ZINKTiti/30-bibliotheque-Modelisme/01 Electronique/Motors/01 NEMA/NEMA_17_with_connector.png

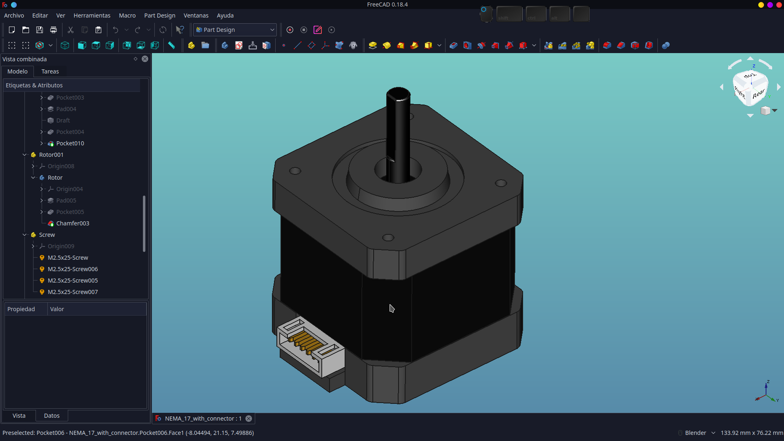
01 Electronique/Motors/01 NEMA/NEMA_17_with_connector.png
