ZINKTiti/30-bibliotheque-Modelisme/README.md

# 30-bibliotheque-Modelisme
 Library FreeCAD pour le modelisme

Cette library est un compilation d'un grand nombre de model utilisable dans me designe 3D pour le modelisme
