ZINKTiti/30-bibliotheque-Modelisme/00 Modelisme/Moteur/Bruchless/Turnigy/sk3-3542_dt3019-14p_motor_edited_.pdf

### I ""1 I I/"

I I

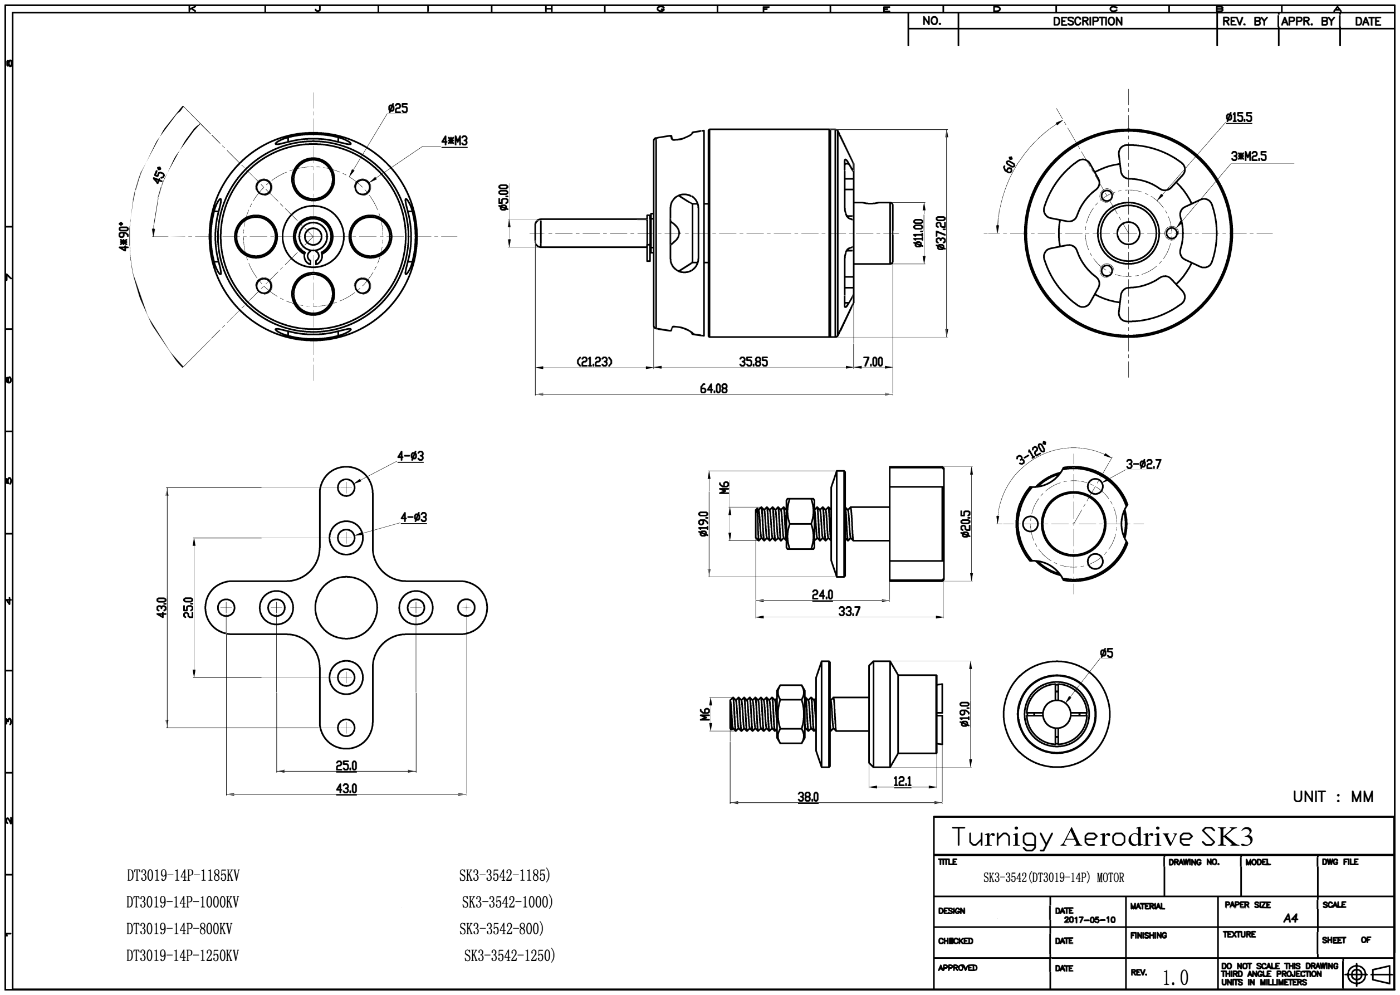
[picture p3: page 1]

11125

4•M3

II") s.
II ( C1' | L
Ill | -

I
, | +---------1 .,
/ | (21.23)

4-1113

4-1113

I • | 0

25.0

43.0

DT3019-14P-1185KV | SK3-3542-1185)
| SK3-3542-1000)
| SK3-3542-800)

## DT3019-14P-1000KV

## DT3019-14P-800KV

DT3019-14P-1250KV | SK3-3542-1250)

## _,__...,.-

/<::::::

__,......,___

35.85

64.08

I

24.0

38.0

,,_
j

33.7

7.00

.,..:;

12.1

NO. | DESCRIPTION | REV. BY IAPPR. BY I DATE

@
{;:;s.

II'!

@ s.

I

# I / _J_

11115,5

3•M2.5

UNIT : MM

# Turnigy Aerodrive SK3

1111£ | I DRAWING NO. | I MODEL | I DWO FILE
SK3-3542(DT3019-14P) MOTOR
DESIGN | I DA

17-o5-10 IIA'IERW. PAPER SIZE I SCALE A4
CHECKED | I DAlE | FINISHNG | 1EXIURE | I SHEEr | OF - | I DAlE | RE.V. | 1.0 | DO NOT SCALE lHIS DRAWING I
lHIRD ANGLE PROJECllON | -$ lNTS IN IIIWIIEIERS
