ZINKTiti/30-bibliotheque-Modelisme/00 Modelisme/Accessoires/Boitier connecteur/connecteur_JR_affleurant.png

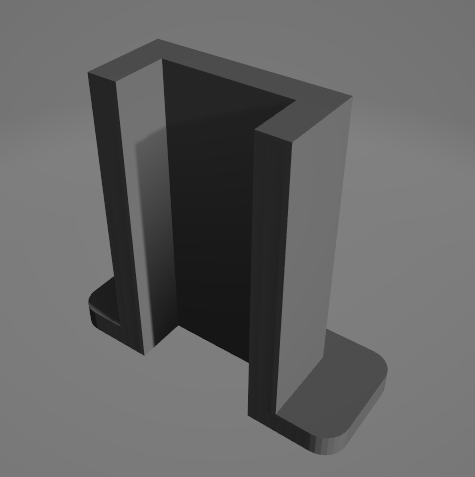
00 Modelisme/Accessoires/Boitier connecteur/connecteur_JR_affleurant.png
