ZINKTiti/30-bibliotheque-Modelisme/00 Modelisme/Accessoires/Connecteur/MPX/MPX.png

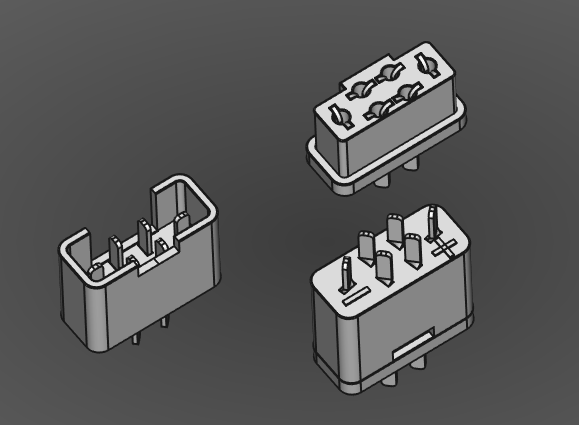
00 Modelisme/Accessoires/Connecteur/MPX/MPX.png
