ZINKTiti/30-bibliotheque-Modelisme/00 Modelisme/Moteur/Bruchless/Axi/2208dwg.jpg

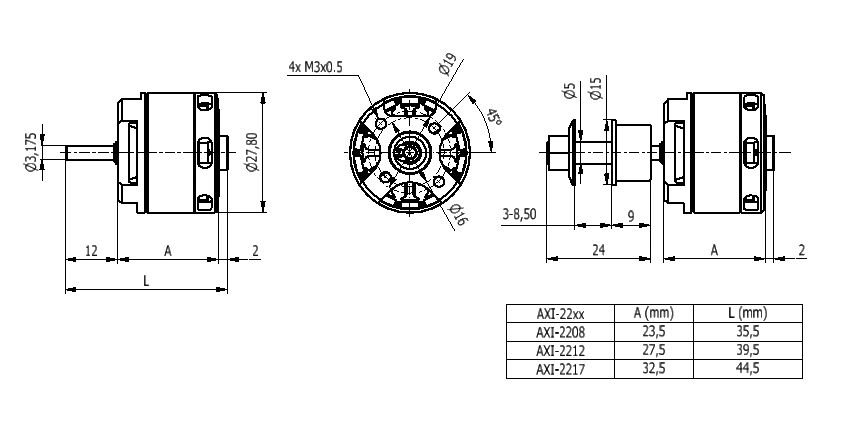
00 Modelisme/Moteur/Bruchless/Axi/2208dwg.jpg
