ZINKTiti/30-bibliotheque-Modelisme/00 Modelisme/Moteur/Bruchless/Axi/2212-3.jpg

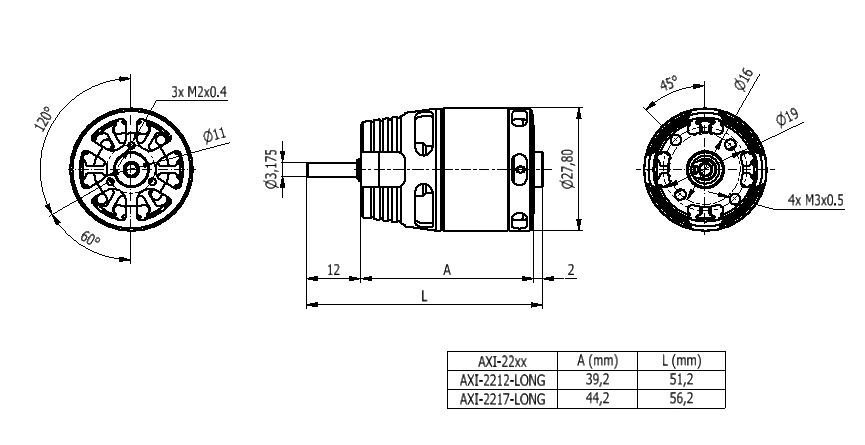
00 Modelisme/Moteur/Bruchless/Axi/2212-3.jpg
