ZINKTiti/30-bibliotheque-Modelisme/00 Modelisme/Moteur/Bruchless/Axi/axi-81xx.jpg

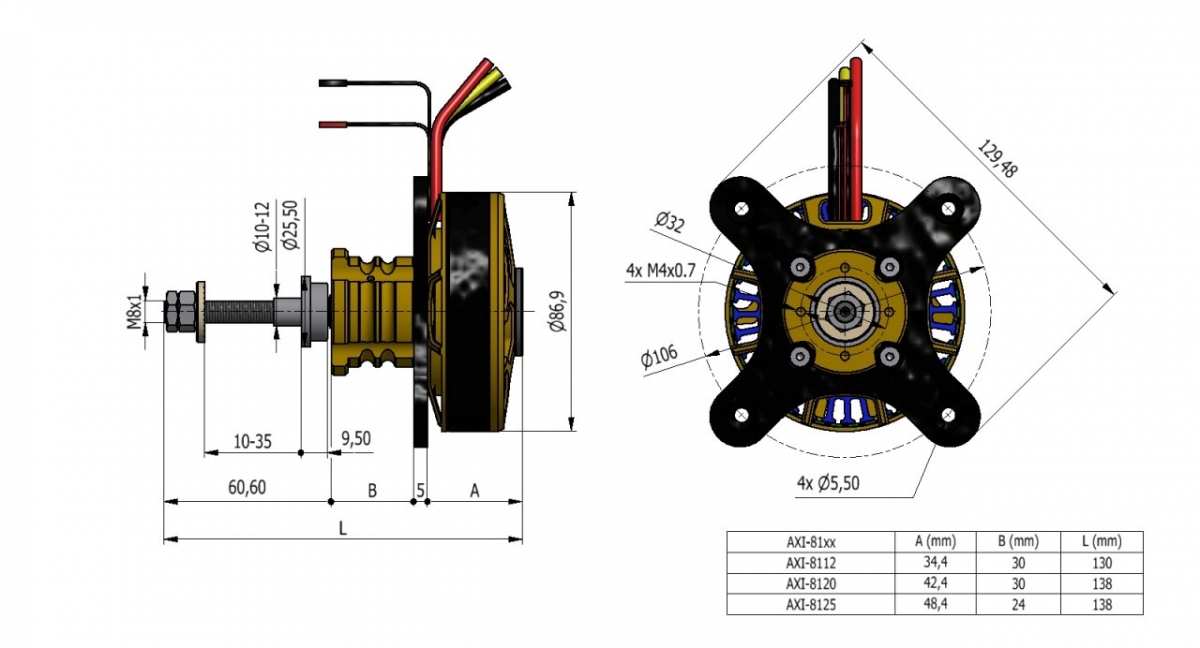
00 Modelisme/Moteur/Bruchless/Axi/axi-81xx.jpg
