ZINKTiti/30-bibliotheque-Modelisme/00 Modelisme/Moteur/Bruchless/Axi/axi-90-5320-370-3d3.jpg

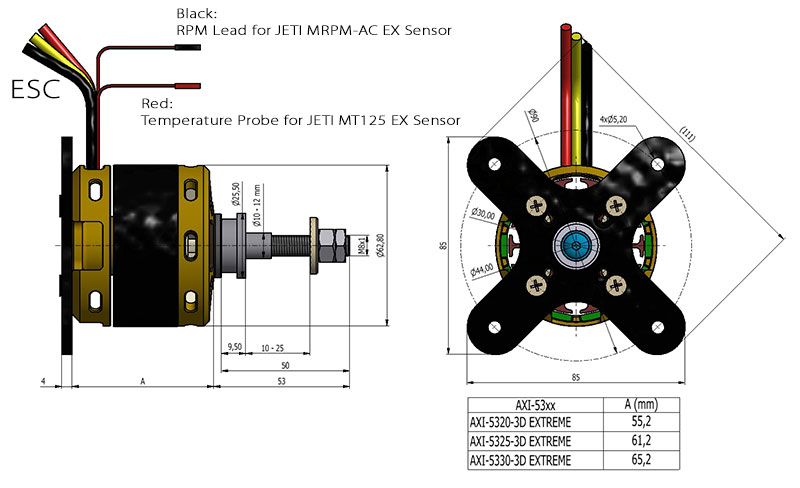
00 Modelisme/Moteur/Bruchless/Axi/axi-90-5320-370-3d3.jpg
