ZINKTiti/30-bibliotheque-Modelisme/00 Modelisme/Moteur/Bruchless/Axi/axi-5345l-hd3.jpg

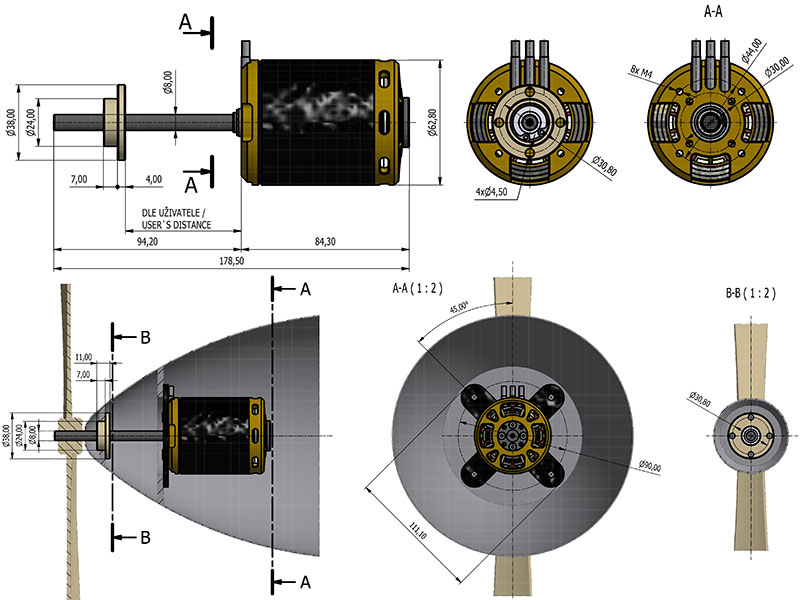
00 Modelisme/Moteur/Bruchless/Axi/axi-5345l-hd3.jpg
