ZINKTiti/30-bibliotheque-Modelisme/00 Modelisme/Moteur/Bruchless/Turnigy/p2_FULL.jpg

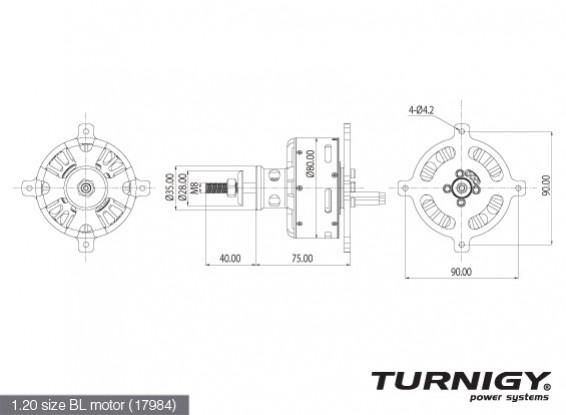
00 Modelisme/Moteur/Bruchless/Turnigy/p2_FULL.jpg
