ZINKTiti/30-bibliotheque-Modelisme/00 Modelisme/Moteur/Essence/DLE/DLE30_dim1.jpg

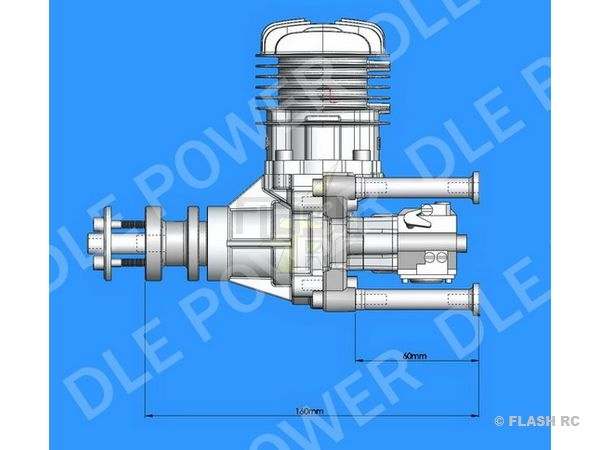
00 Modelisme/Moteur/Essence/DLE/DLE30_dim1.jpg
