ZINKTiti/30-bibliotheque-Modelisme/00 Modelisme/Moteur/Essence/DLE/dle60_dimensions_back.jpg

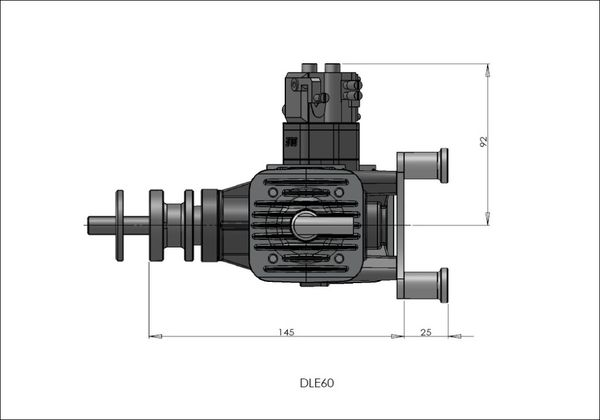
00 Modelisme/Moteur/Essence/DLE/dle60_dimensions_back.jpg
