ZINKTiti/30-bibliotheque-Modelisme/00 Modelisme/Moteur/Essence/DLE/dle_55_5.jpg

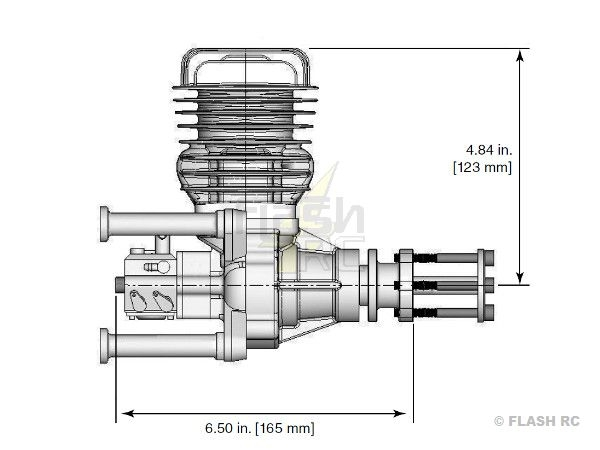
00 Modelisme/Moteur/Essence/DLE/dle_55_5.jpg
