ZINKTiti/30-bibliotheque-Modelisme/00 Modelisme/Servos/KST/03_cec1d161-892e-4872-81a3-9242b01087f4_600x600.webp

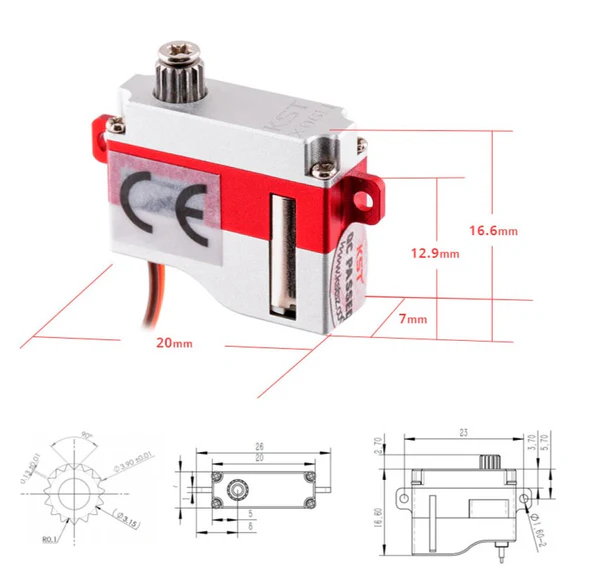
00 Modelisme/Servos/KST/03_cec1d161-892e-4872-81a3-9242b01087f4_600x600.webp
