ZINKTiti/30-bibliotheque-Modelisme/00 Modelisme/Servos/KST/kst-x12-5082.jpg

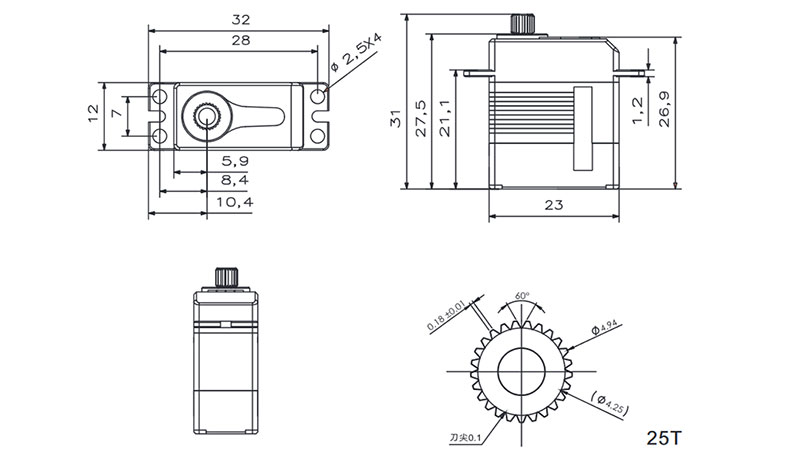
00 Modelisme/Servos/KST/kst-x12-5082.jpg
