ZINKTiti/30-bibliotheque-Modelisme/00 Modelisme/Servos/KST/kst-x20-38132.jpg

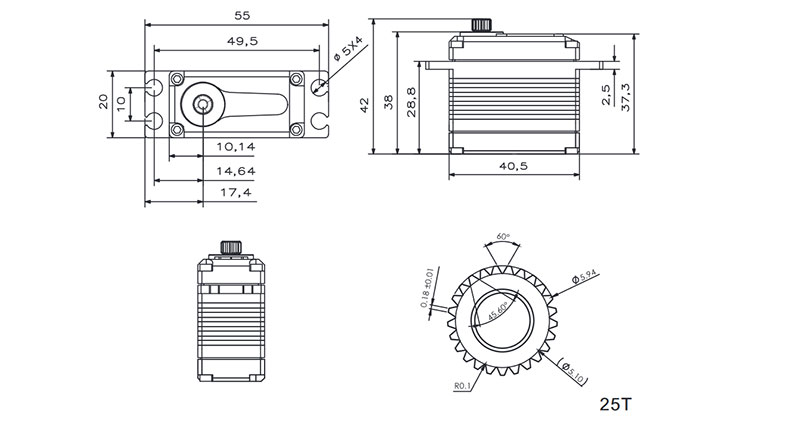
00 Modelisme/Servos/KST/kst-x20-38132.jpg
