ZINKTiti/30-bibliotheque-Modelisme/00 Modelisme/Servos/KST/nano-servo-kst-x12-508-v80-62kg-a-84v.jpg

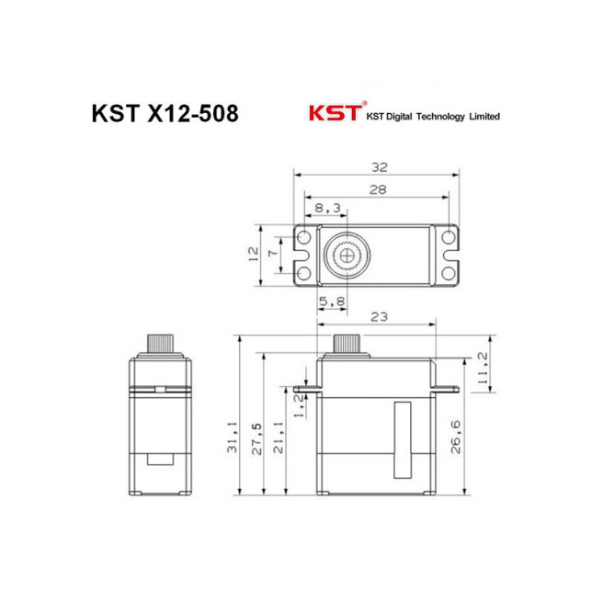
00 Modelisme/Servos/KST/nano-servo-kst-x12-508-v80-62kg-a-84v.jpg
