ZINKTiti/30-bibliotheque-Modelisme/00 Modelisme/Servos/KST/servo-brushless-hv-kst-bls505.jpg

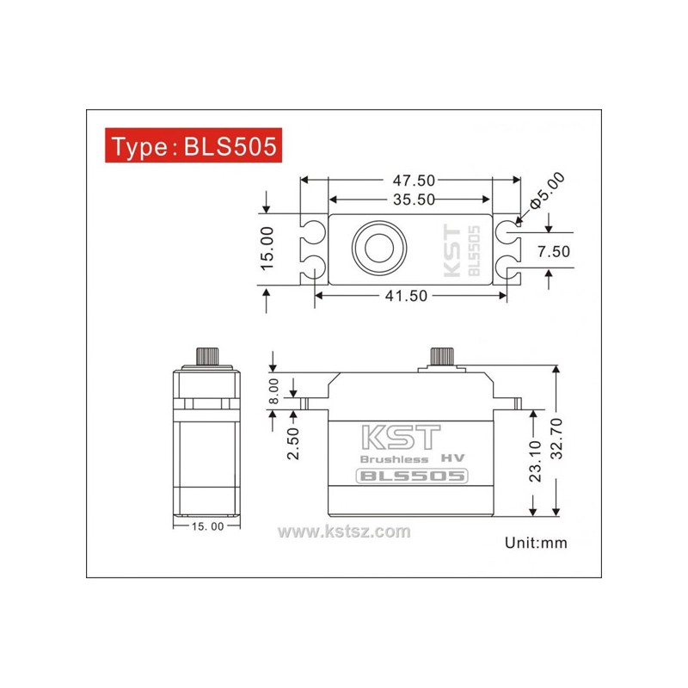
00 Modelisme/Servos/KST/servo-brushless-hv-kst-bls505.jpg
