ZINKTiti/30-bibliotheque-Modelisme/00 Modelisme/Servos/KST/servo-d-aile-kst-ds125mg-7kgcm-a-6v.jpg

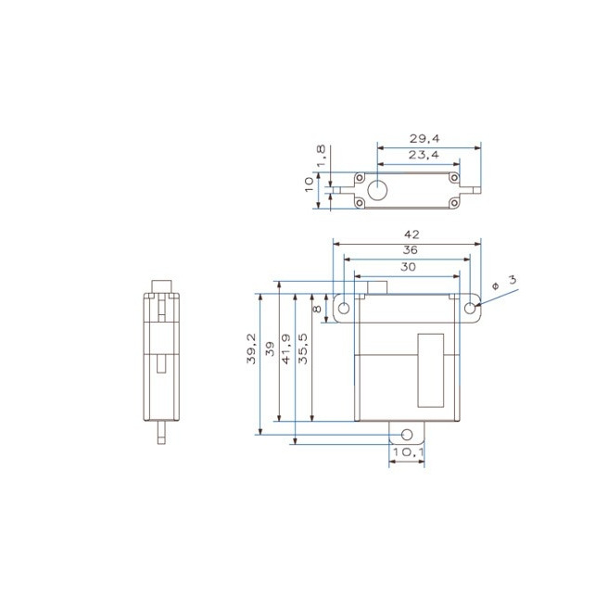
00 Modelisme/Servos/KST/servo-d-aile-kst-ds125mg-7kgcm-a-6v.jpg
