ZINKTiti/30-bibliotheque-Modelisme/00 Modelisme/Servos/KST/servo-x10-mini-v8-23gr-75kg-kst.jpg

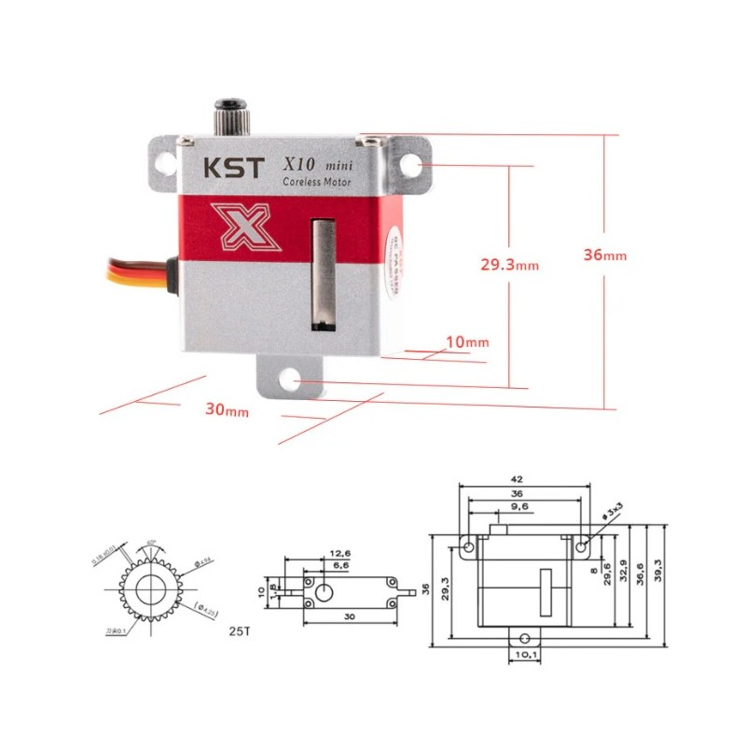
00 Modelisme/Servos/KST/servo-x10-mini-v8-23gr-75kg-kst.jpg
