ZINKTiti/30-bibliotheque-Modelisme/00 Modelisme/Servos/KST/X08 plus.jpg

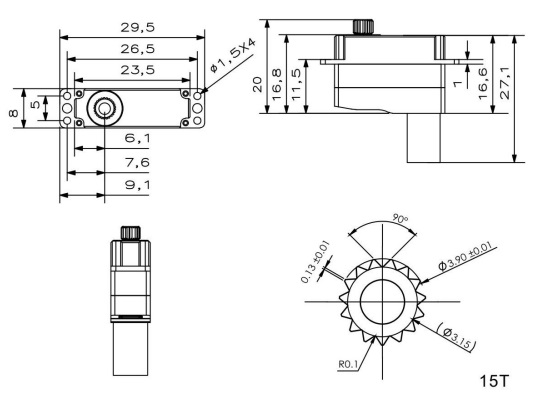
00 Modelisme/Servos/KST/X08 plus.jpg
