ZINKTiti/30-bibliotheque-Modelisme/01 Electronique/Fin de course/endstop.png

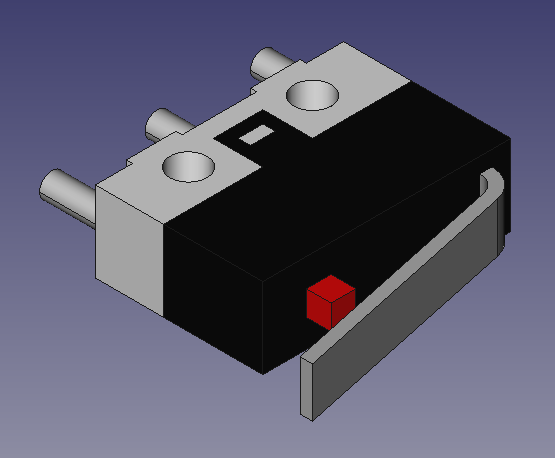
01 Electronique/Fin de course/endstop.png
