ZINKTiti/30-bibliotheque-Modelisme/01 Electronique/Fin de course/endstopsmall.png

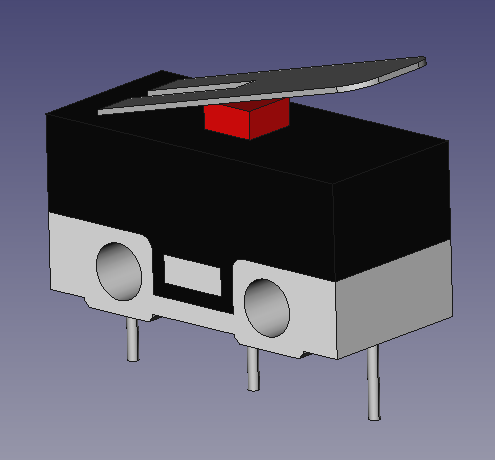
01 Electronique/Fin de course/endstopsmall.png
