ZINKTiti/30-bibliotheque-Modelisme/01 Electronique/Fin de course/Fin de course rouge/Bildschirmfoto 2016-11-22 um 21.24.29.JPG

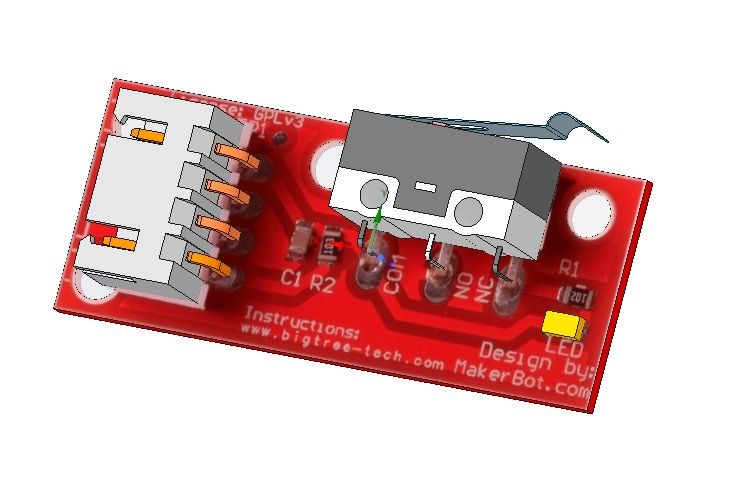
01 Electronique/Fin de course/Fin de course rouge/Bildschirmfoto 2016-11-22 um 21.24.29.JPG
