ZINKTiti/30-bibliotheque-Modelisme/01 Electronique/LCD/2-2-tft-lcd-screen/Assortment.JPG

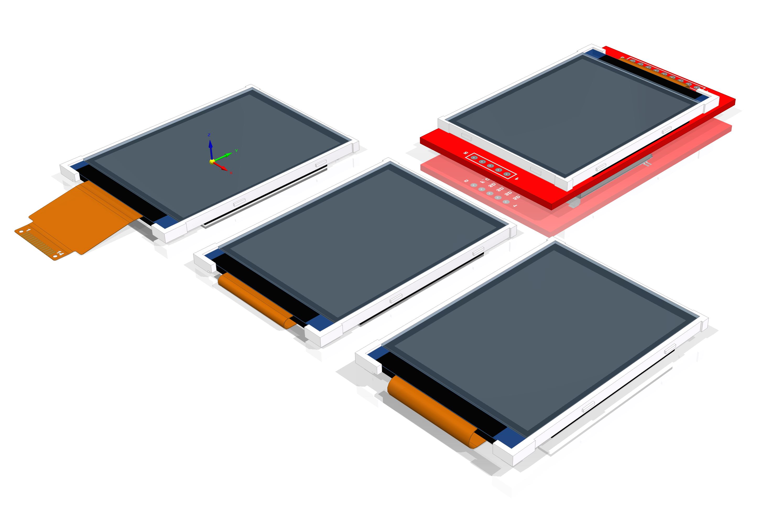
01 Electronique/LCD/2-2-tft-lcd-screen/Assortment.JPG
