ZINKTiti/30-bibliotheque-Modelisme/01 Electronique/LCD/tft-lcd-2-4-inch-ili9341-touch-320x240/2.jpg

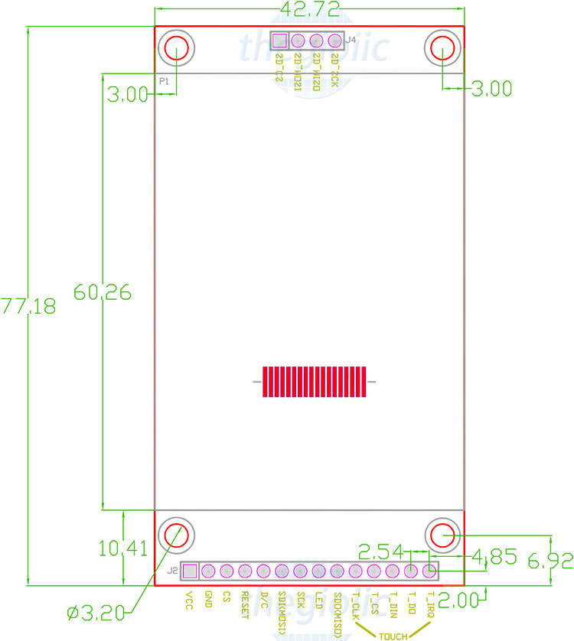
01 Electronique/LCD/tft-lcd-2-4-inch-ili9341-touch-320x240/2.jpg
