ZINKTiti/30-bibliotheque-Modelisme/01 Electronique/Statique Relay/FinalRender.jpg

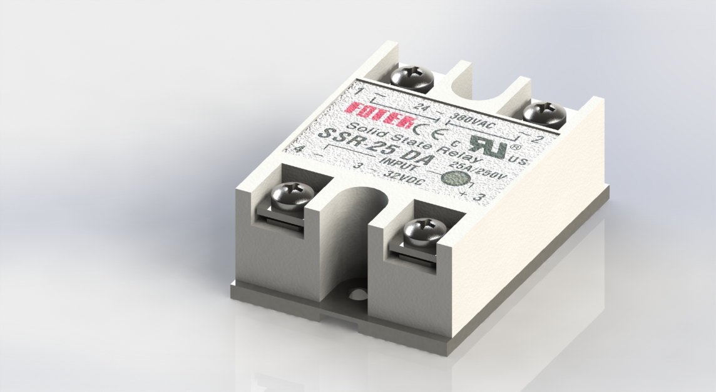
01 Electronique/Statique Relay/FinalRender.jpg
