ZINKTiti/30-bibliotheque-Modelisme/01 Electronique/Statique Relay/Fotek SSR Faceplate.jpg

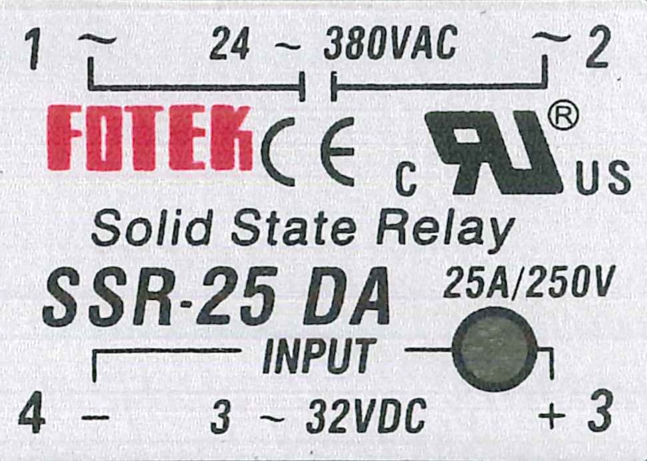
01 Electronique/Statique Relay/Fotek SSR Faceplate.jpg
