ZINKTiti/30-bibliotheque-Modelisme/02 Mecanique/Coupleur/CF/CF-03.jpg

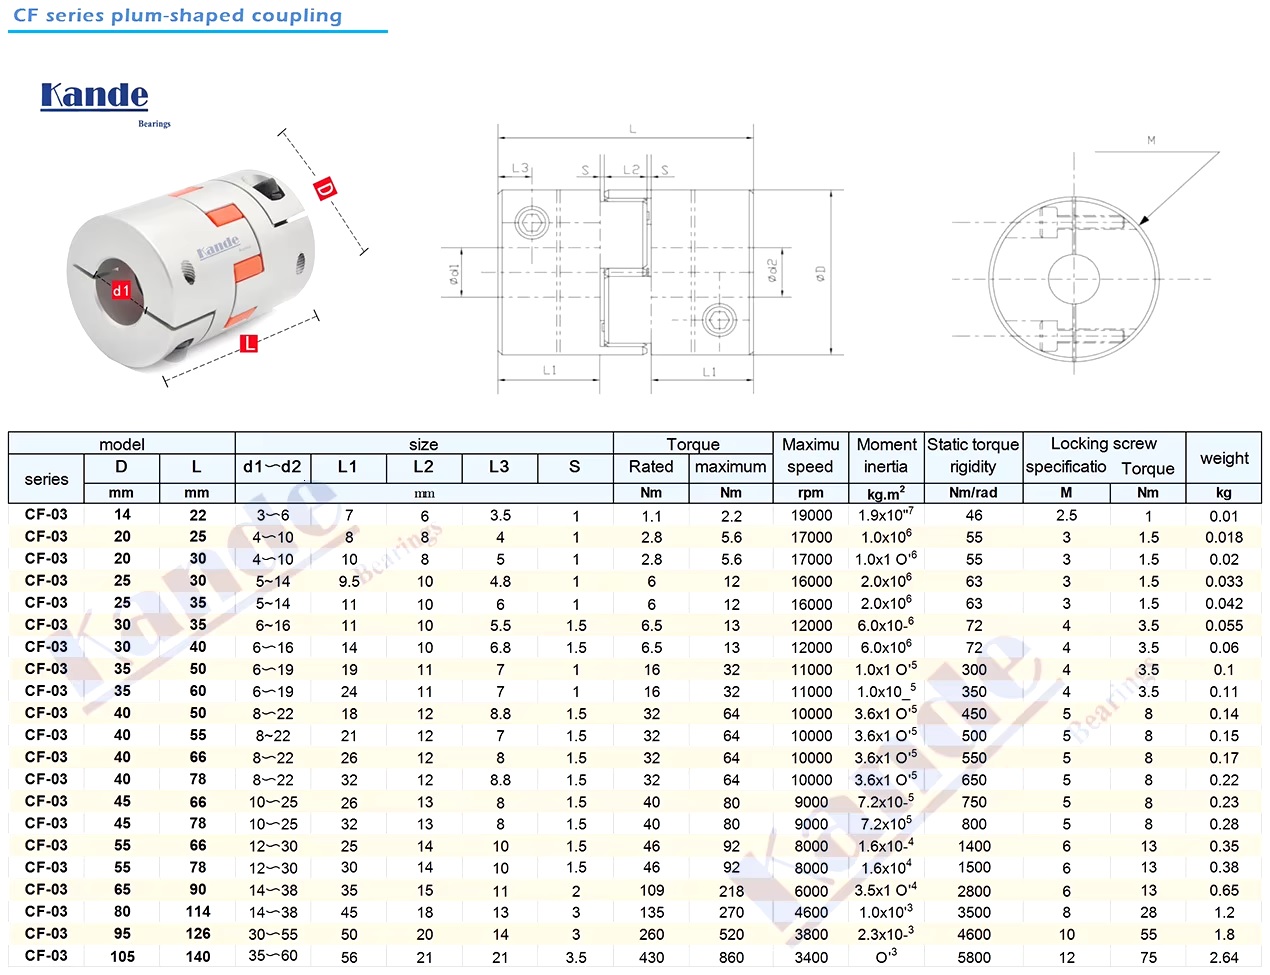
02 Mecanique/Coupleur/CF/CF-03.jpg
