ZINKTiti/30-bibliotheque-Modelisme/02 Mecanique/Guidage Lineaire/HGH/HGH 15 to 65 all Dim V2.jpg

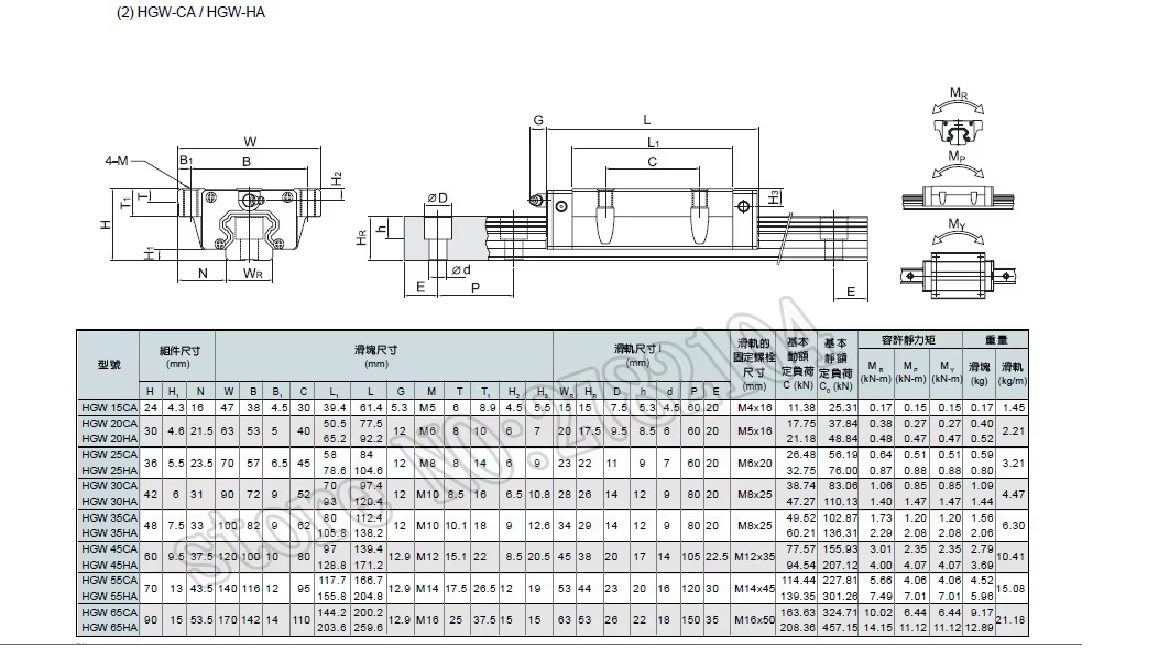
02 Mecanique/Guidage Lineaire/HGH/HGH 15 to 65 all Dim V2.jpg
