ZINKTiti/30-bibliotheque-Modelisme/02 Mecanique/Guidage Lineaire/HGH/HGH.jpg

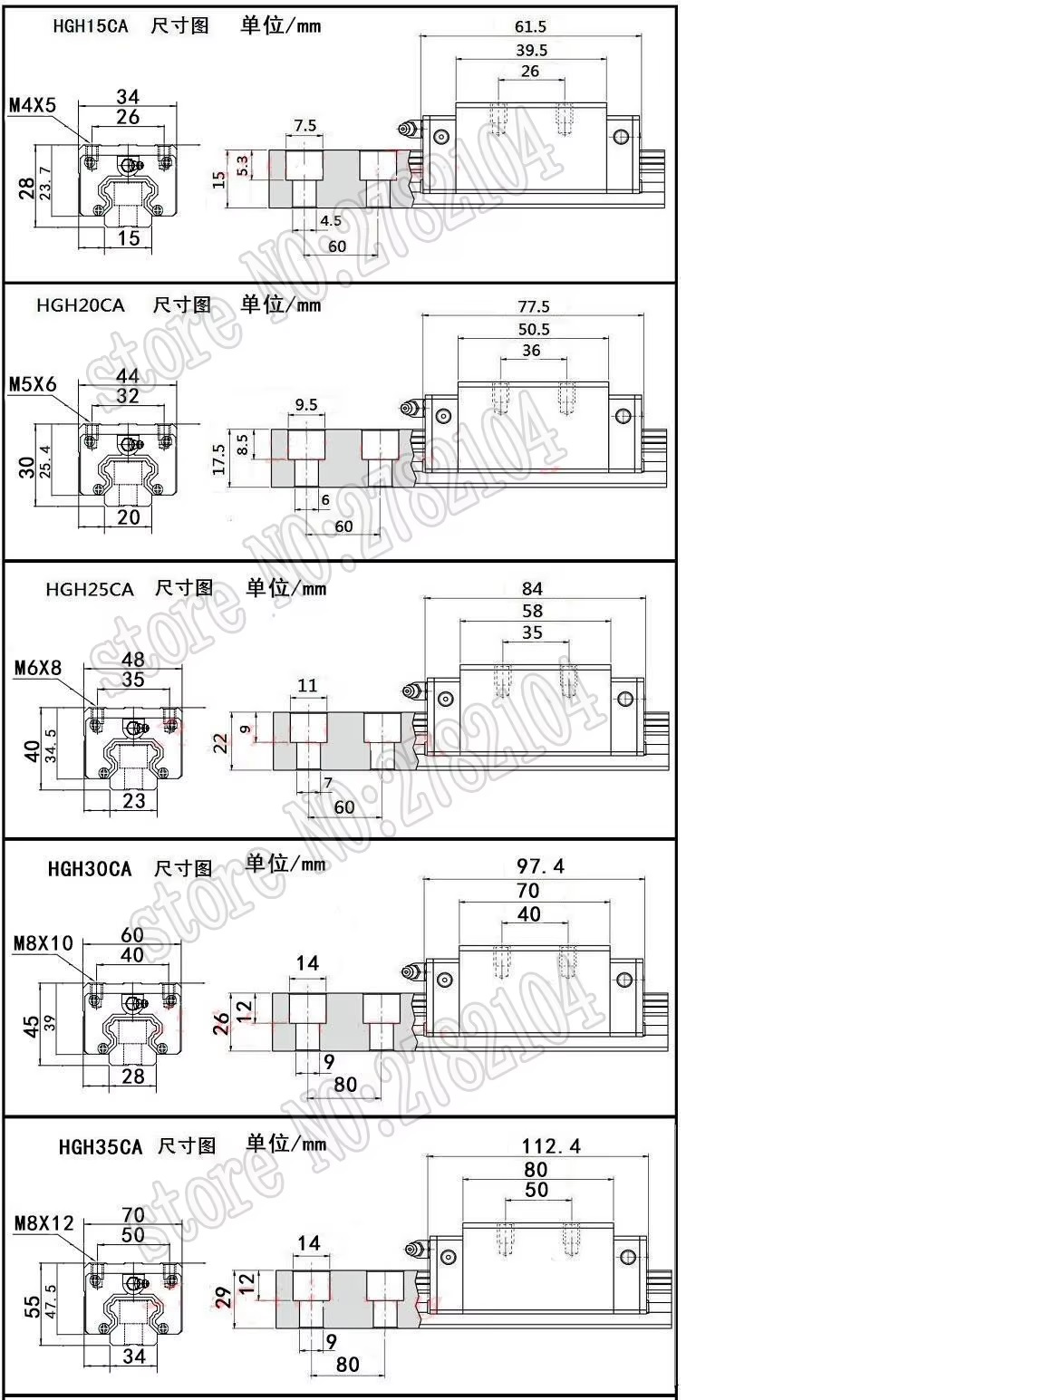
02 Mecanique/Guidage Lineaire/HGH/HGH.jpg
