ZINKTiti/30-bibliotheque-Modelisme/02 Mecanique/Poulie/3M/15T_88T.jpg

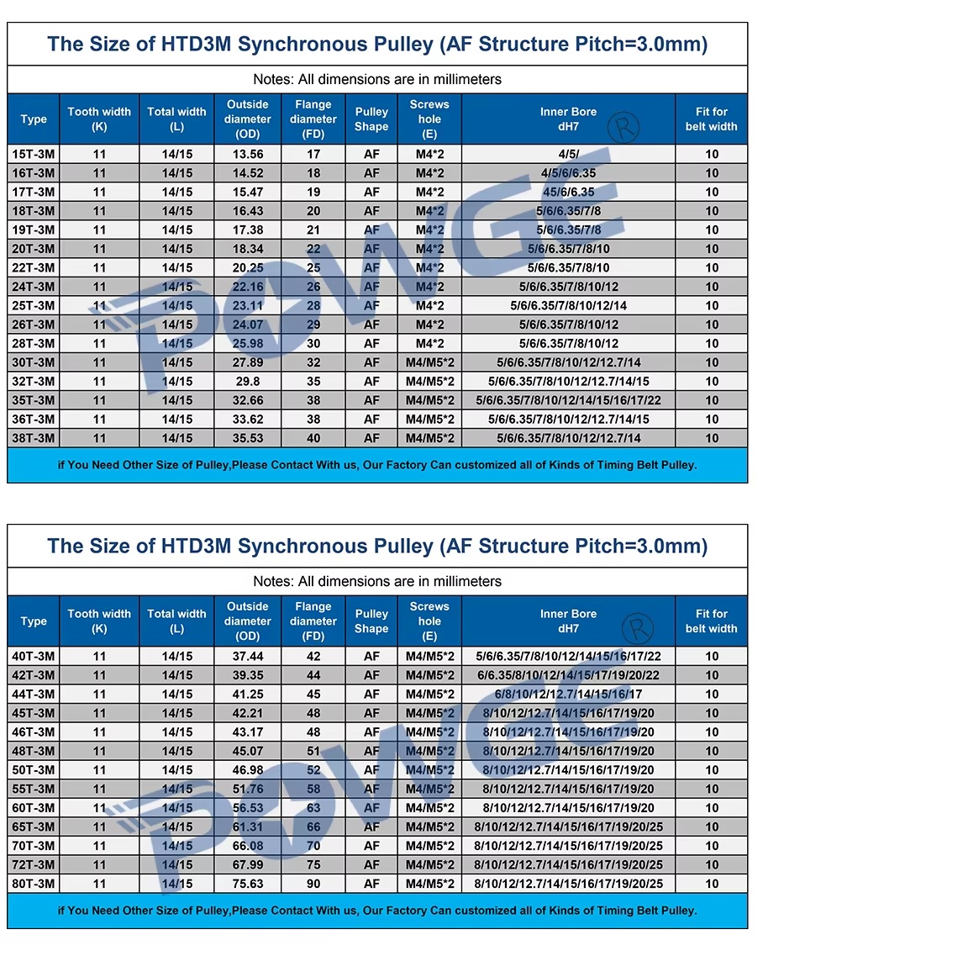
02 Mecanique/Poulie/3M/15T_88T.jpg
