ZINKTiti/30-bibliotheque-Modelisme/02 Mecanique/Poulie/3M/AF_BF_CF.jpg

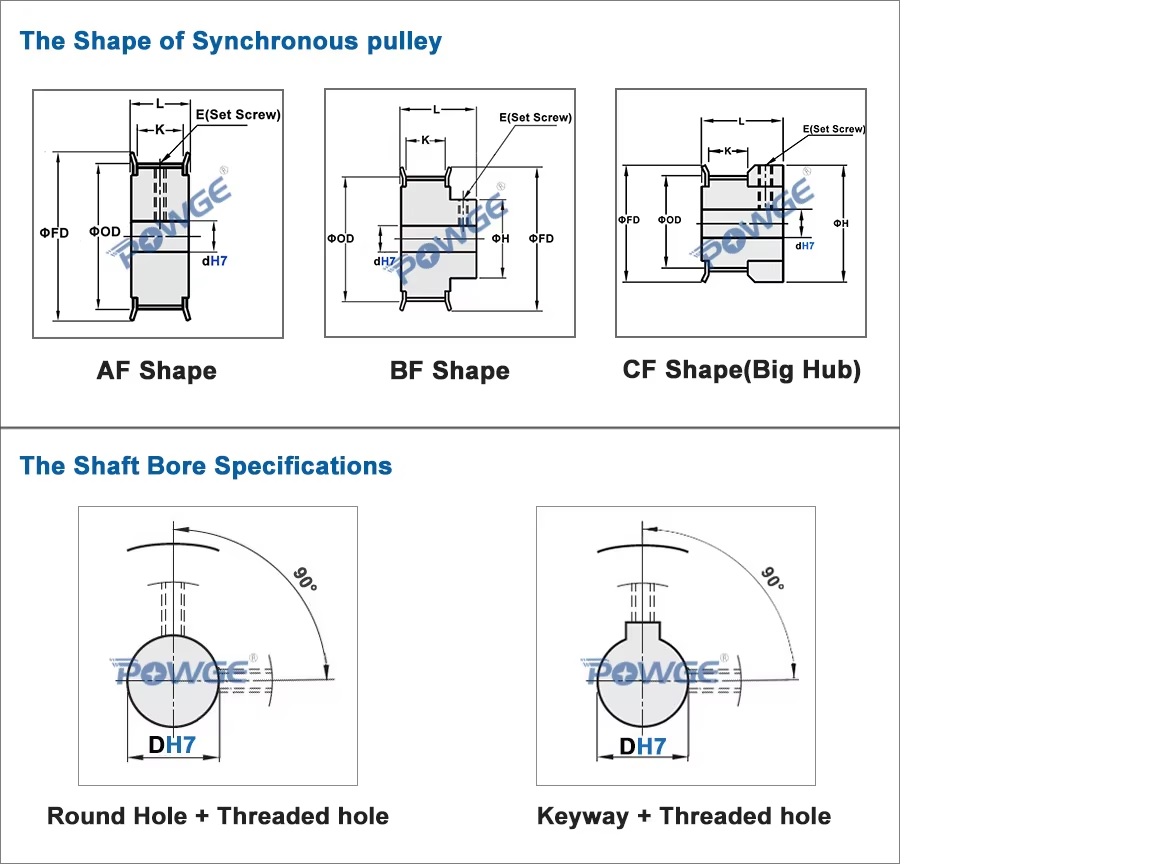
02 Mecanique/Poulie/3M/AF_BF_CF.jpg
