ZINKTiti/30-bibliotheque-Modelisme/02 Mecanique/Poulie/3M/Carde1.jpg

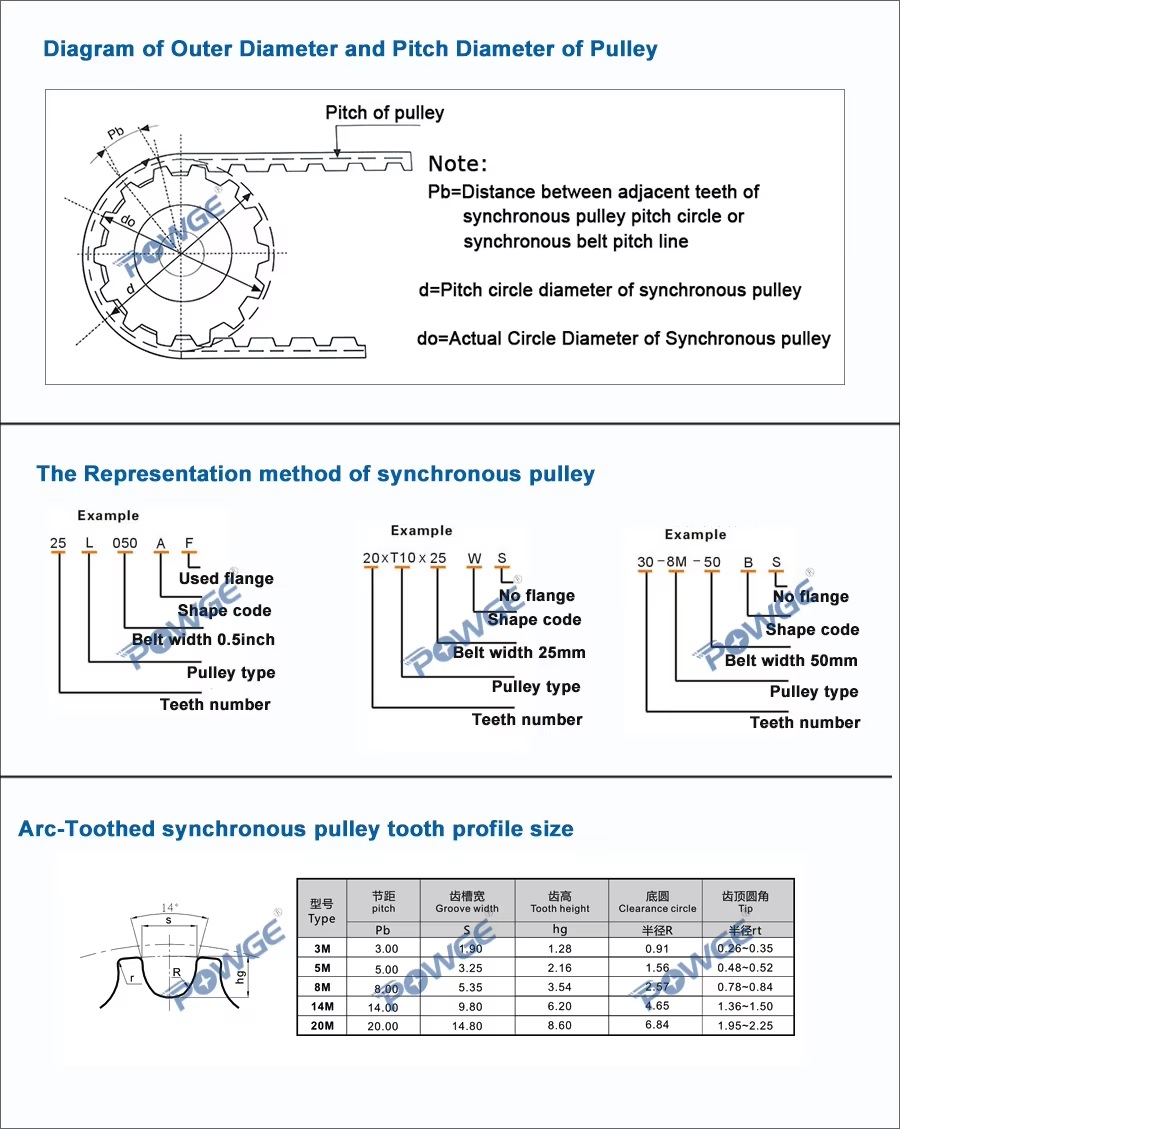
02 Mecanique/Poulie/3M/Carde1.jpg
