ZINKTiti/30-bibliotheque-Modelisme/02 Mecanique/Poulie/3M/Couroit HTD 3M.jpg

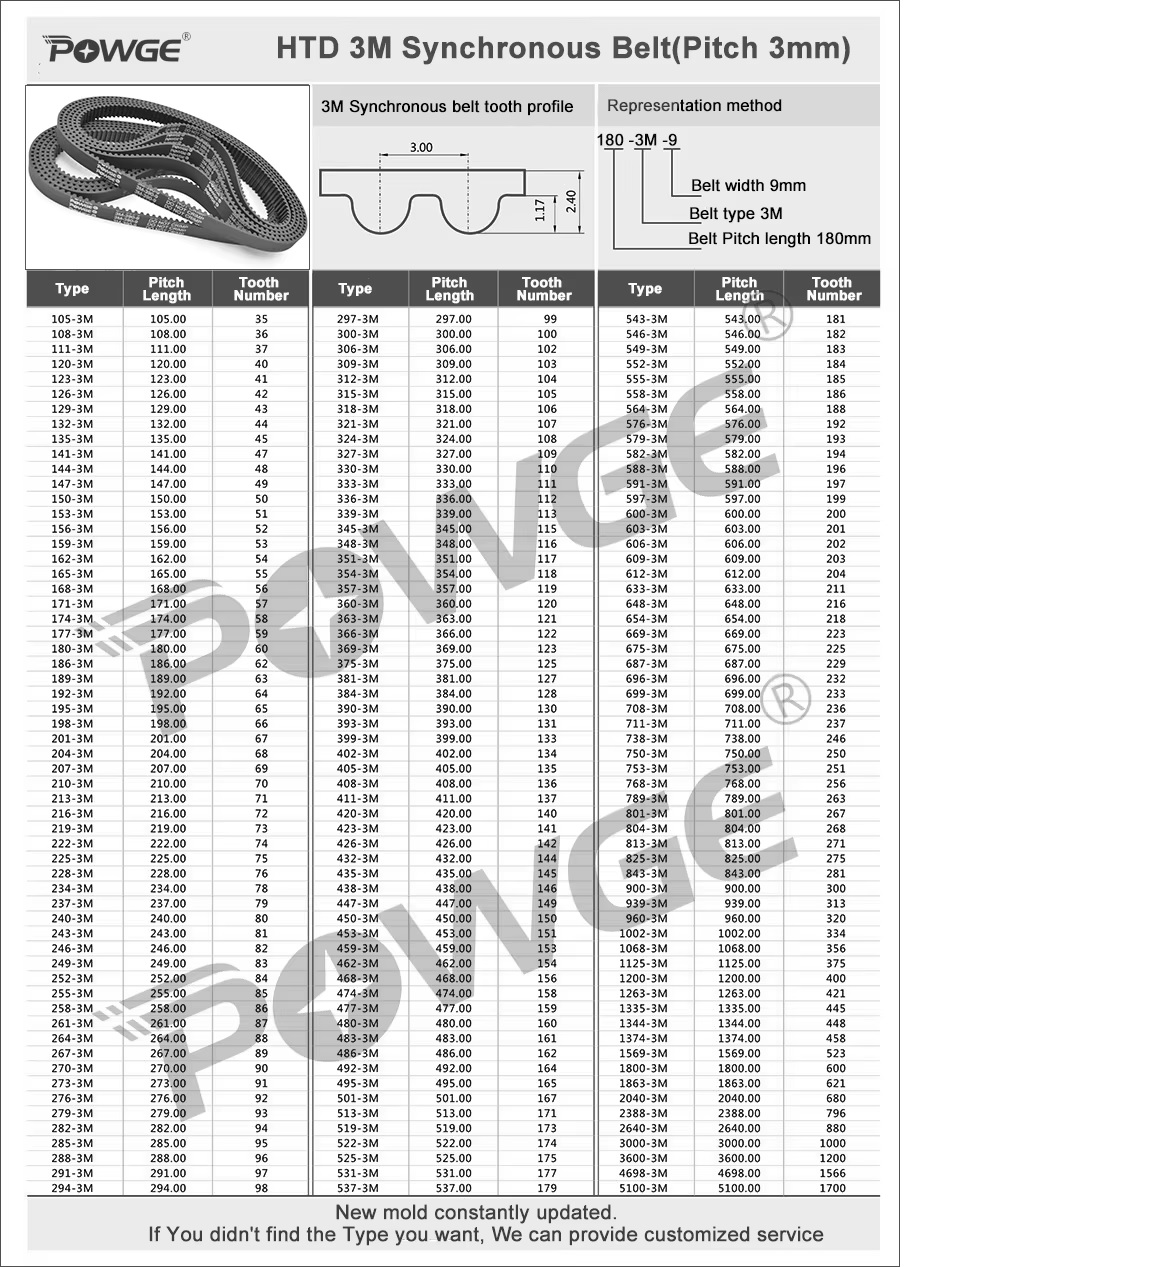
02 Mecanique/Poulie/3M/Couroit HTD 3M.jpg
