ZINKTiti/30-bibliotheque-Modelisme/02 Mecanique/Poulie/3M/Keyway.jpg

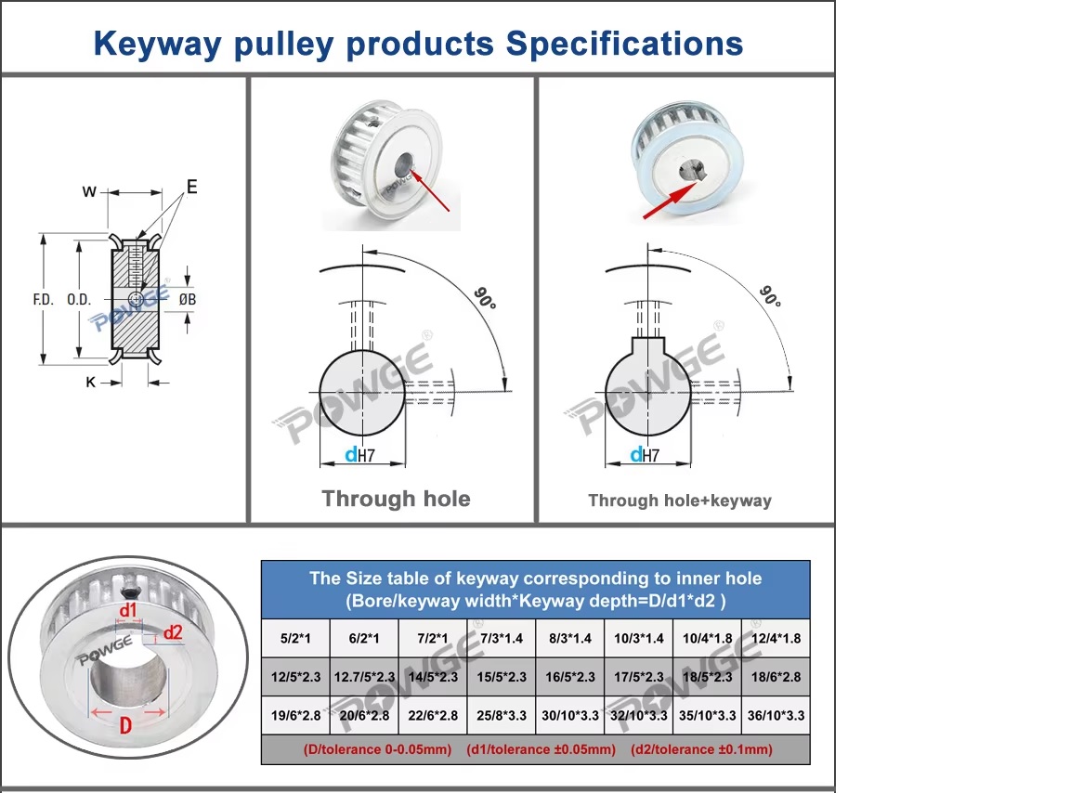
02 Mecanique/Poulie/3M/Keyway.jpg
