ZINKTiti/30-bibliotheque-Modelisme/02 Mecanique/Profiles EN/BOSCH/20-4040_dimensional.png

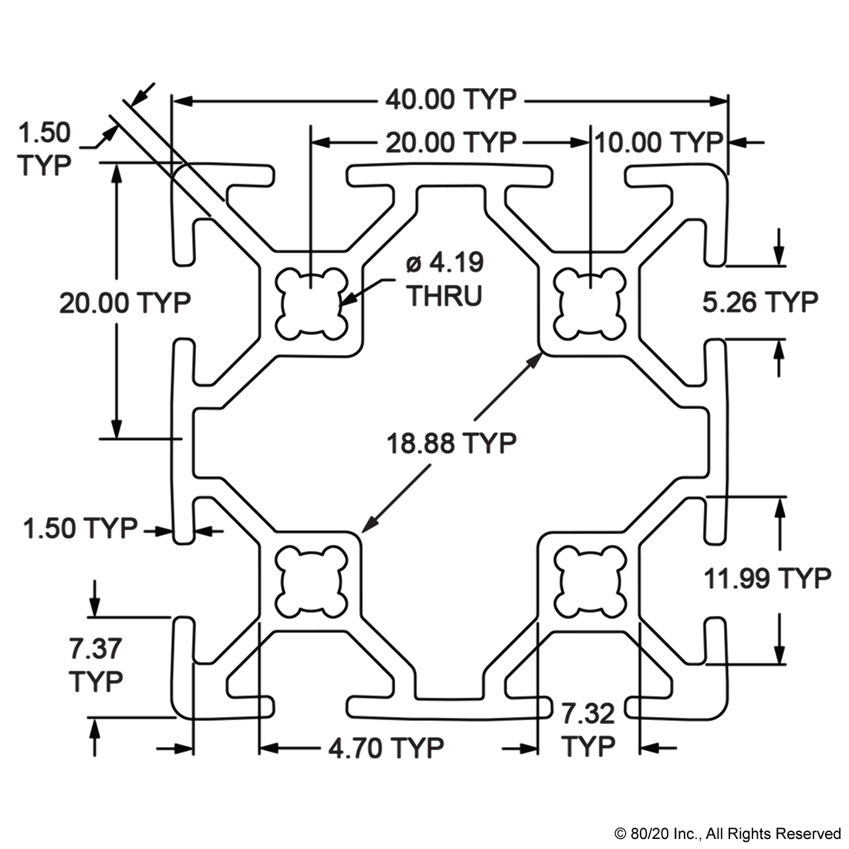
02 Mecanique/Profiles EN/BOSCH/20-4040_dimensional.png
