ZINKTiti/30-bibliotheque-Modelisme/02 Mecanique/Profiles EN/BOSCH/Bosch-Rexroth-Aluminum-connectors90.PNG

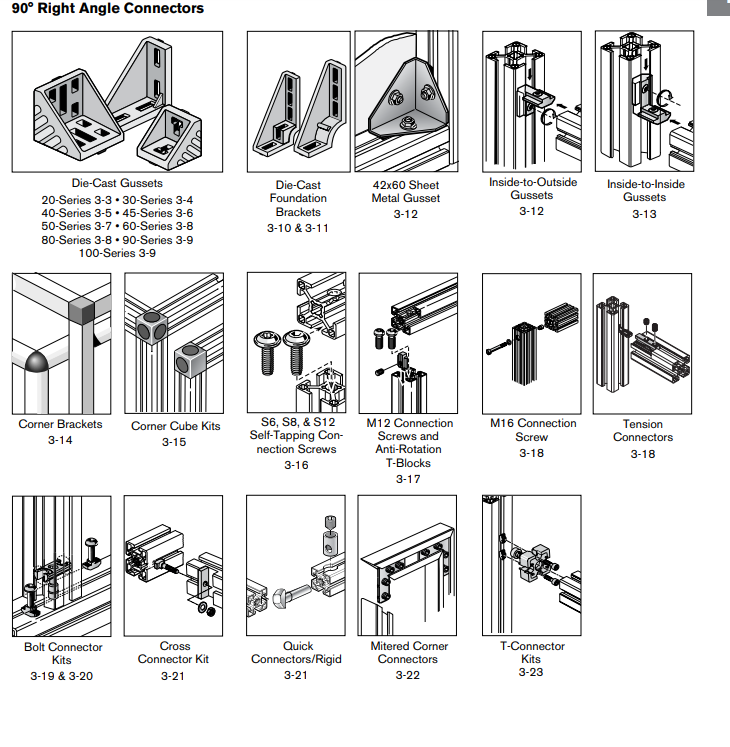
02 Mecanique/Profiles EN/BOSCH/Bosch-Rexroth-Aluminum-connectors90.PNG
