ZINKTiti/30-bibliotheque-Modelisme/02 Mecanique/Profiles EN/BOSCH/Bosch-Rexroth-Aluminum-connectors180.PNG

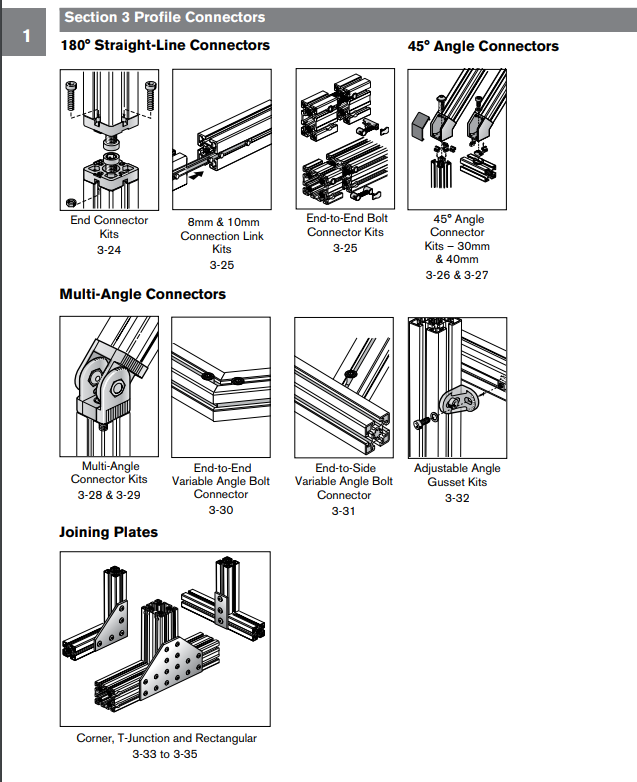
02 Mecanique/Profiles EN/BOSCH/Bosch-Rexroth-Aluminum-connectors180.PNG
