ZINKTiti/30-bibliotheque-Modelisme/02 Mecanique/Profiles EN/BOSCH/Bosch-Rexroth-Aluminum-Framing.PNG

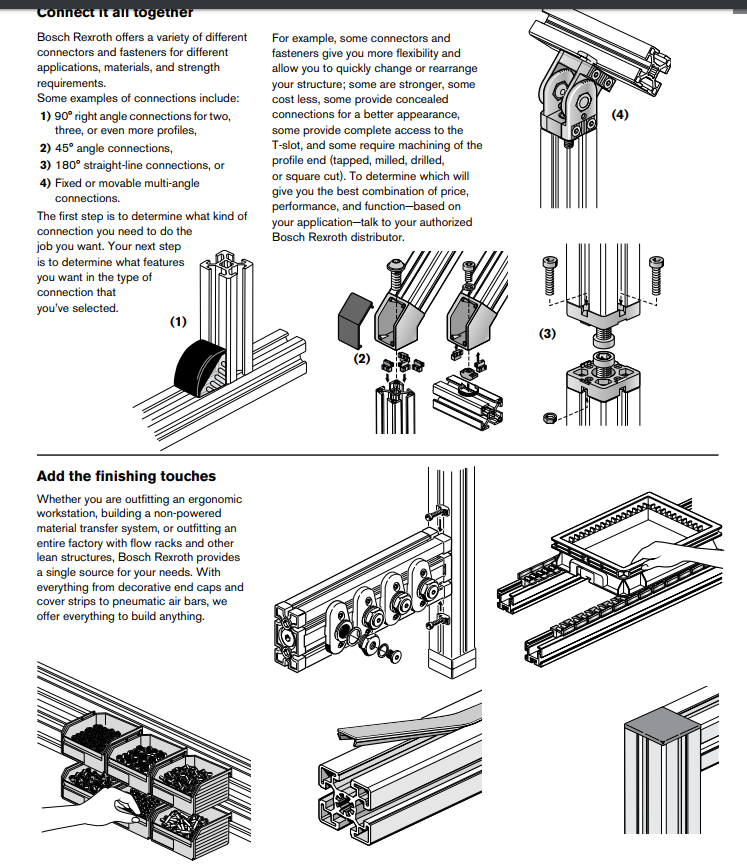
02 Mecanique/Profiles EN/BOSCH/Bosch-Rexroth-Aluminum-Framing.PNG
