ZINKTiti/30-bibliotheque-Modelisme/02 Mecanique/Profiles EN/BOSCH/Profile Bosh 40x40mm FreeCAD.PNG

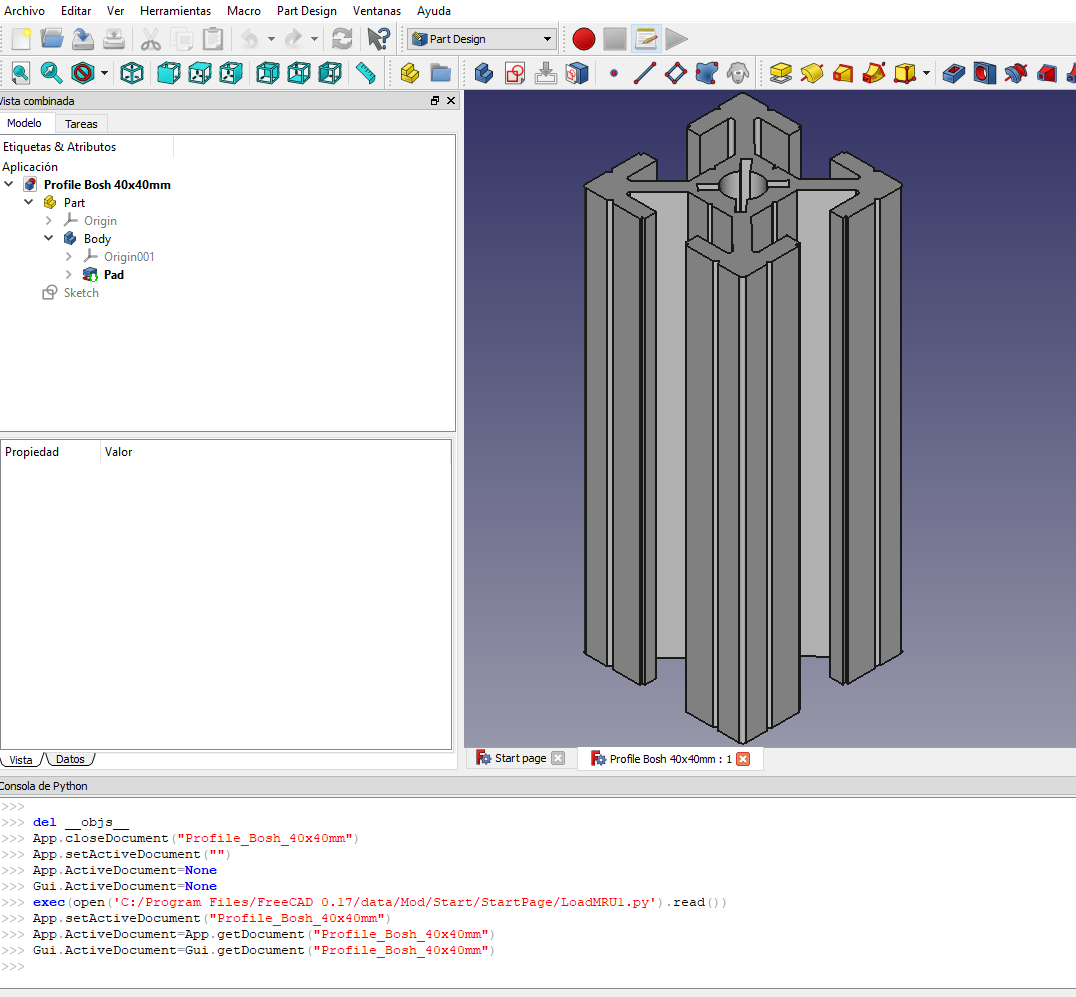
02 Mecanique/Profiles EN/BOSCH/Profile Bosh 40x40mm FreeCAD.PNG
