ZINKTiti/30-bibliotheque-Modelisme/02 Mecanique/Profiles EN/Misumi_profiles/misumi_profile_hfs_serie6_w8_30x30.jpg

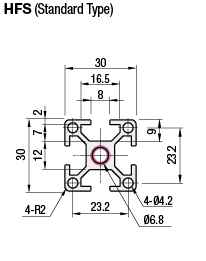
02 Mecanique/Profiles EN/Misumi_profiles/misumi_profile_hfs_serie6_w8_30x30.jpg
