ZINKTiti/30-bibliotheque-Modelisme/02 Mecanique/Profiles EN/Symmetrical rail/Captura de pantalla de 2019-06-09 17-44-11.png

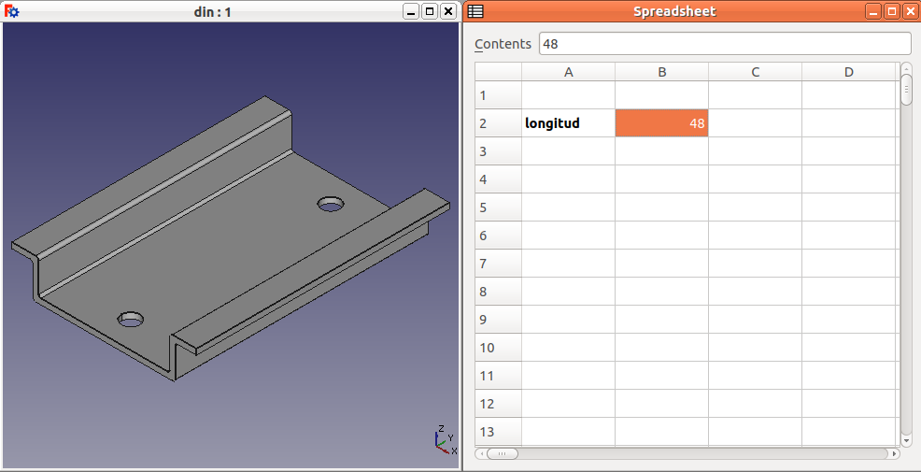
02 Mecanique/Profiles EN/Symmetrical rail/Captura de pantalla de 2019-06-09 17-44-11.png
