ZINKTiti/30-bibliotheque-Modelisme/02 Mecanique/Roulement/Bearing Demo.PNG

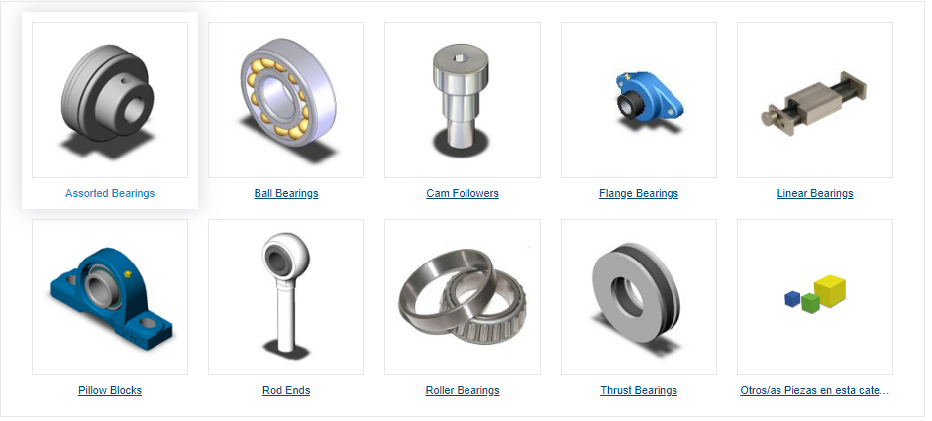
02 Mecanique/Roulement/Bearing Demo.PNG
