ZINKTiti/30-bibliotheque-Modelisme/02 Mecanique/Roulement/parametric_ball_bearing/dimensions.png

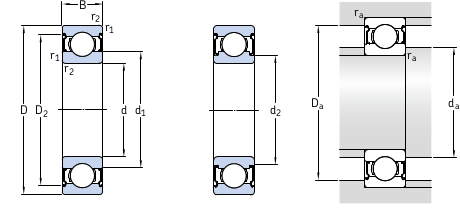
02 Mecanique/Roulement/parametric_ball_bearing/dimensions.png
