ZINKTiti/30-bibliotheque-Modelisme/02 Mecanique/Roulement/Serie 60.jpg

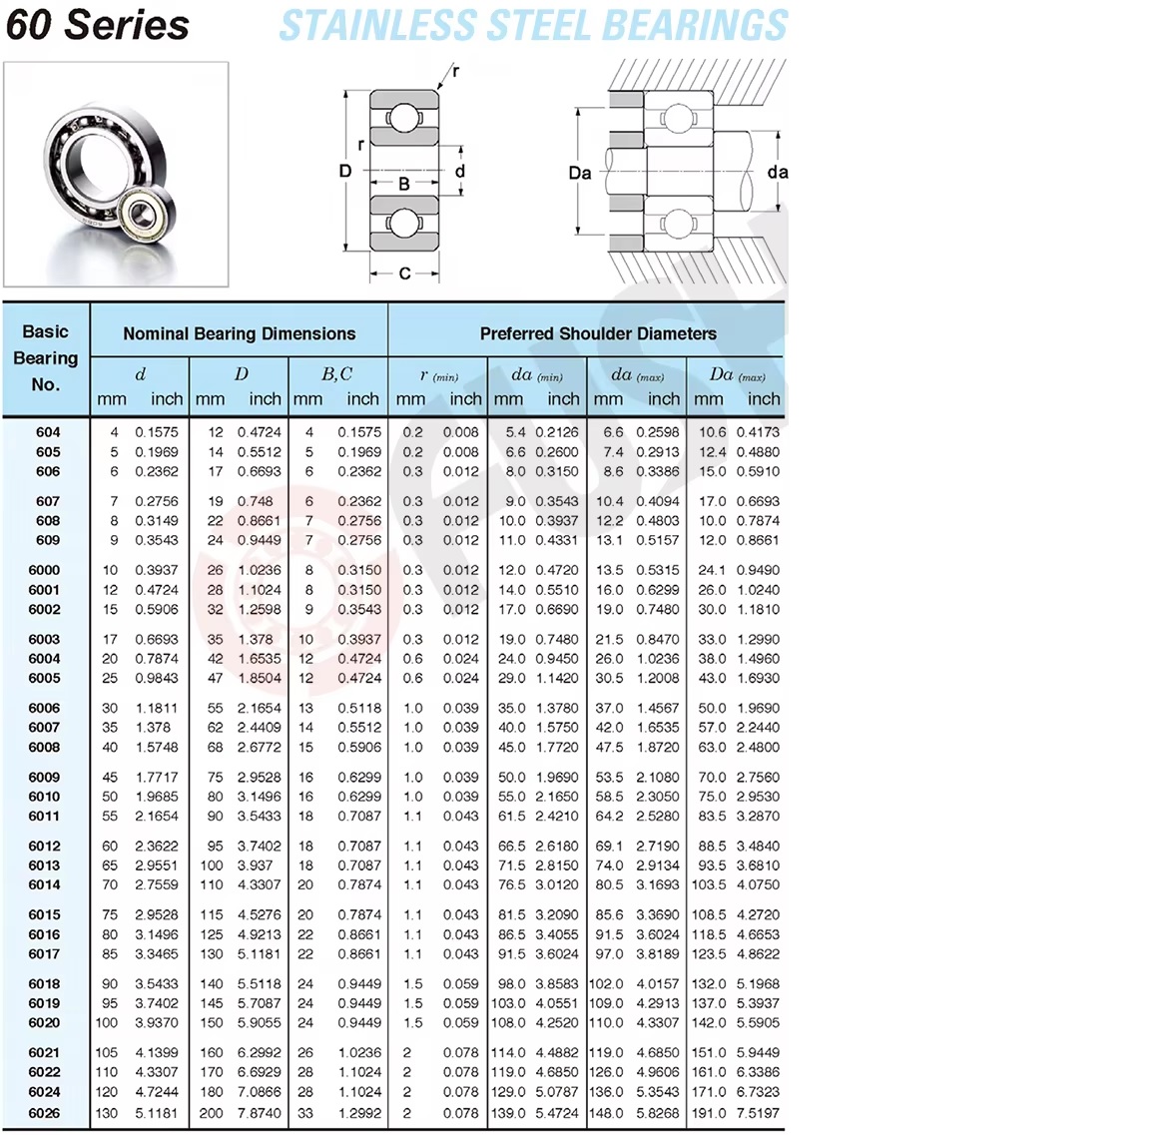
02 Mecanique/Roulement/Serie 60.jpg
