ZINKTiti/30-bibliotheque-Modelisme/02 Mecanique/Vis a bille.png

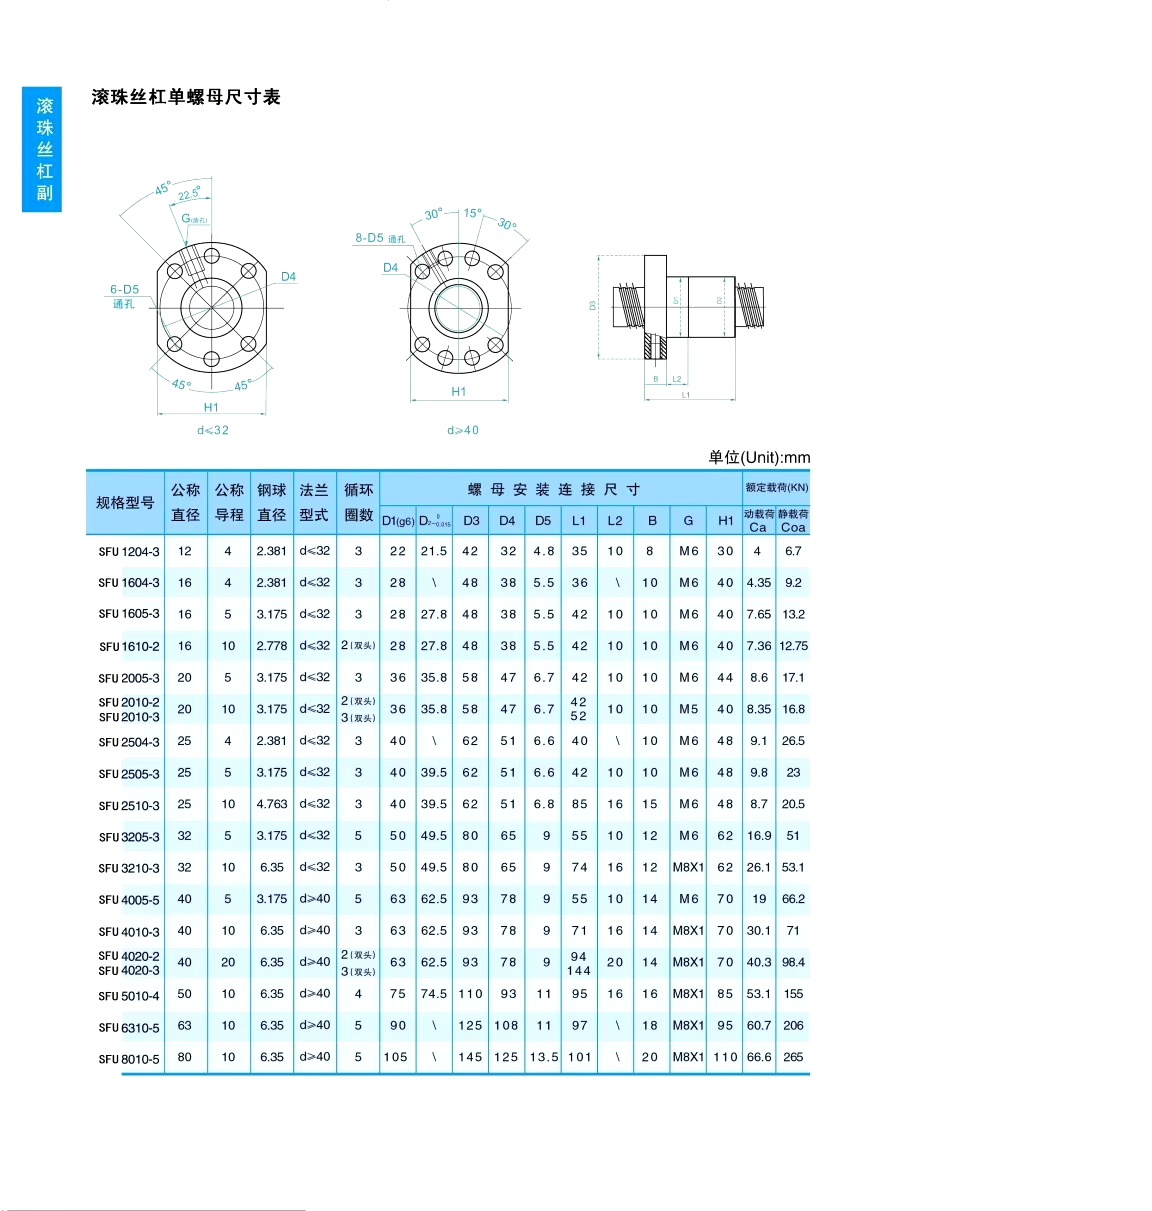
02 Mecanique/Vis a bille.png
