ZINKTiti/30-bibliotheque-Modelisme/01 Electronique/Statique Relay/Main Relay Body.STEP

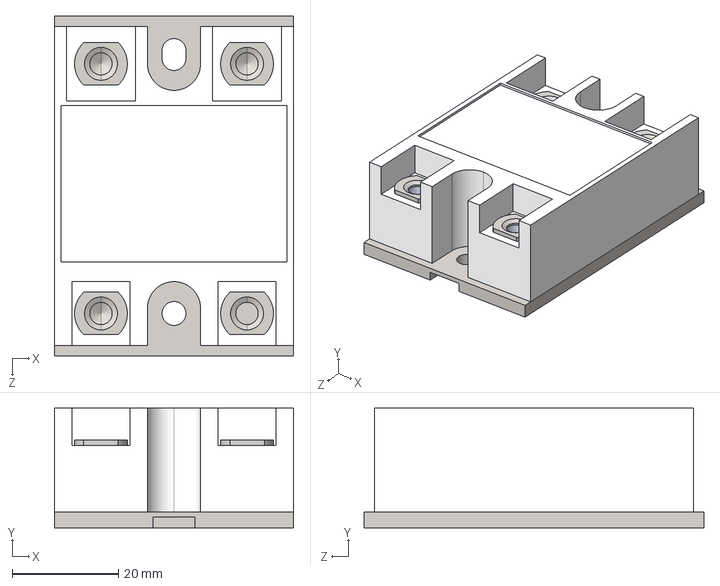
[picture p60: CAD file, 2025-01-18]
01 Electronique/Statique Relay/Main Relay Body.STEP
45.0 x 22.5 x 64.0 mm
