ZINKTiti/30-bibliotheque-Modelisme/00 Modelisme/Accessoires/Boitier connecteur/houder_XT60_def.stl

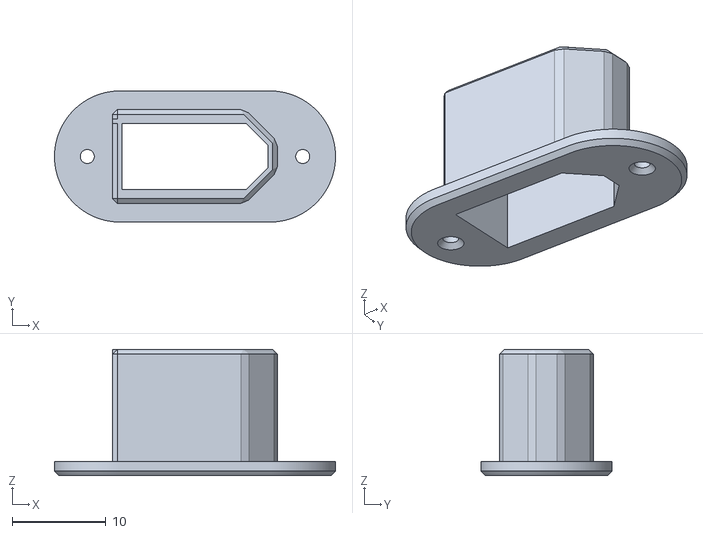
[picture p61: CAD file, 2024-11-10]
00 Modelisme/Accessoires/Boitier connecteur/houder_XT60_def.stl
30.0 x 14.0 x 13.5
