ZINKTiti/30-bibliotheque-Modelisme/00 Modelisme/Accessoires/Boitier connecteur/MPX Hochstromstecker Halter/MPX_halter_kurz.stl

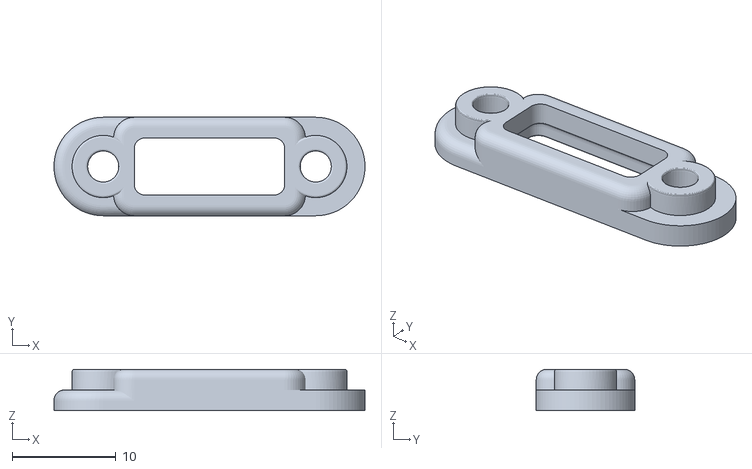
[picture p62: CAD file, 2024-11-10]
00 Modelisme/Accessoires/Boitier connecteur/MPX Hochstromstecker Halter/MPX_halter_kurz.stl
30.0 x 9.50 x 4.00
