ZINKTiti/30-bibliotheque-Modelisme/00 Modelisme/Accessoires/Connecteur/JR/JR male Spinetta.igs

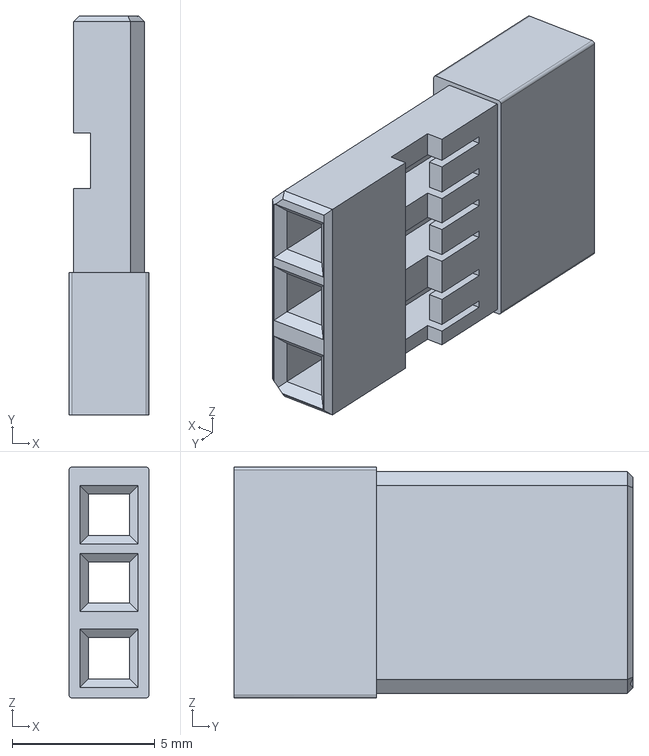
[picture p63: CAD file, 2024-11-10]
00 Modelisme/Accessoires/Connecteur/JR/JR male Spinetta.igs
2.80 x 14.0 x 8.10 mm
