ZINKTiti/30-bibliotheque-Modelisme/00 Modelisme/Accessoires/Connecteur/MPX/MULTIPLEX CONNECTOR.STEP

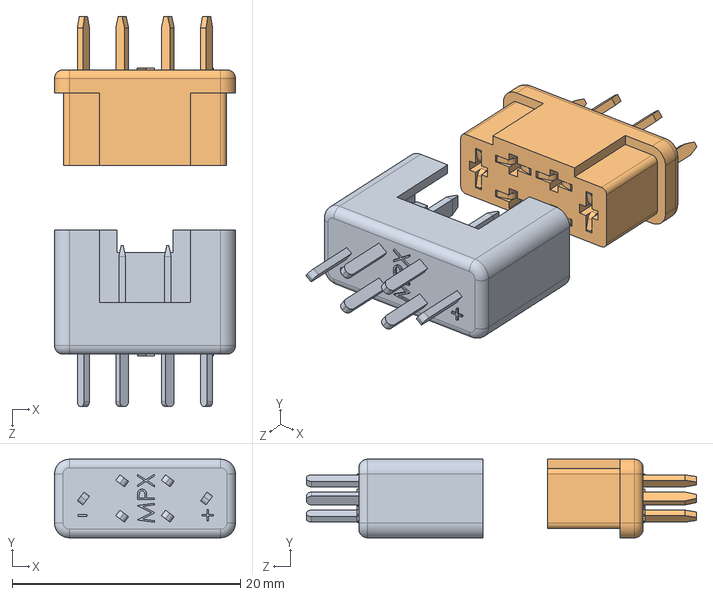
[picture p64: CAD file, 2022-01-30]
00 Modelisme/Accessoires/Connecteur/MPX/MULTIPLEX CONNECTOR.STEP
15.9 x 6.89 x 34.2 mm
CONNECTOR, MULTIPLEX, SOCKET
CONNECTOR, MULTIPLEX, PLUG
