ZINKTiti/30-bibliotheque-Modelisme/00 Modelisme/Accessoires/Connecteur/T/T-Plug female - W.S Deans Co. Est. 1957.step

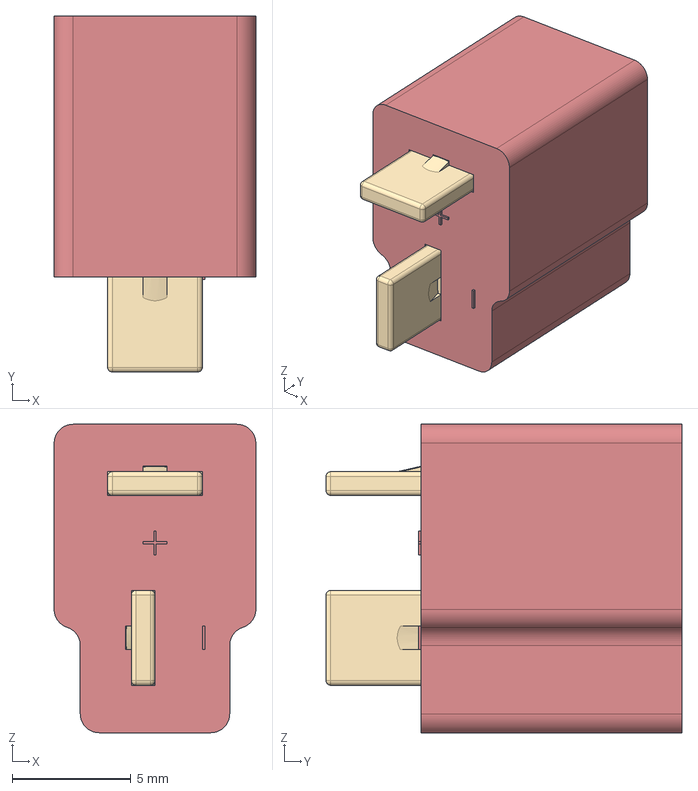
[picture p65: CAD file, 2024-11-10]
00 Modelisme/Accessoires/Connecteur/T/T-Plug female - W.S Deans Co. Est. 1957.step
8.50 x 15.0 x 13.0 mm
