ZINKTiti/30-bibliotheque-Modelisme/00 Modelisme/Accessoires/Connecteur/XT/xt90_female.STEP

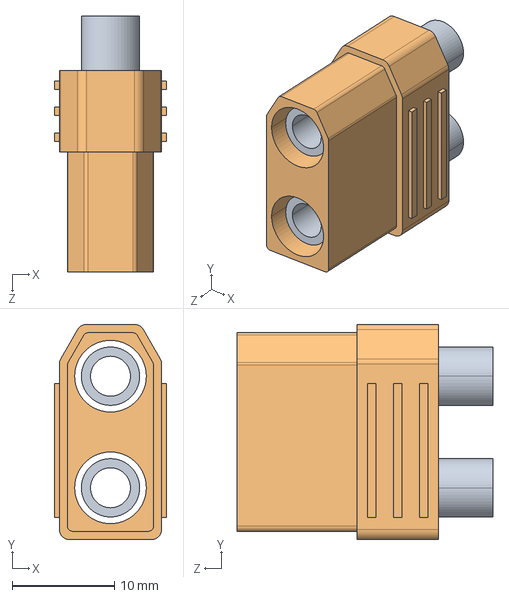
[picture p66: CAD file, 2024-11-10]
00 Modelisme/Accessoires/Connecteur/XT/xt90_female.STEP
10.9 x 21.0 x 25.0 mm
