ZINKTiti/30-bibliotheque-Modelisme/00 Modelisme/Accessoires/Helice/24x12.STEP

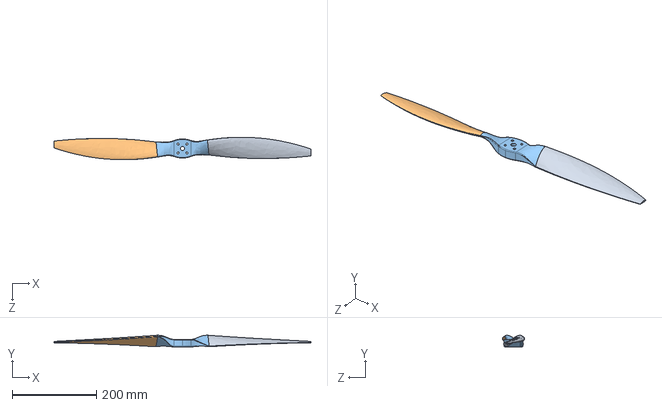
[picture p67: CAD file, 2024-11-10]
00 Modelisme/Accessoires/Helice/24x12.STEP
609.6 x 27.5 x 53.2 mm
