ZINKTiti/30-bibliotheque-Modelisme/00 Modelisme/Battery/Turnigy/LiPo 2S 300mAh.stp

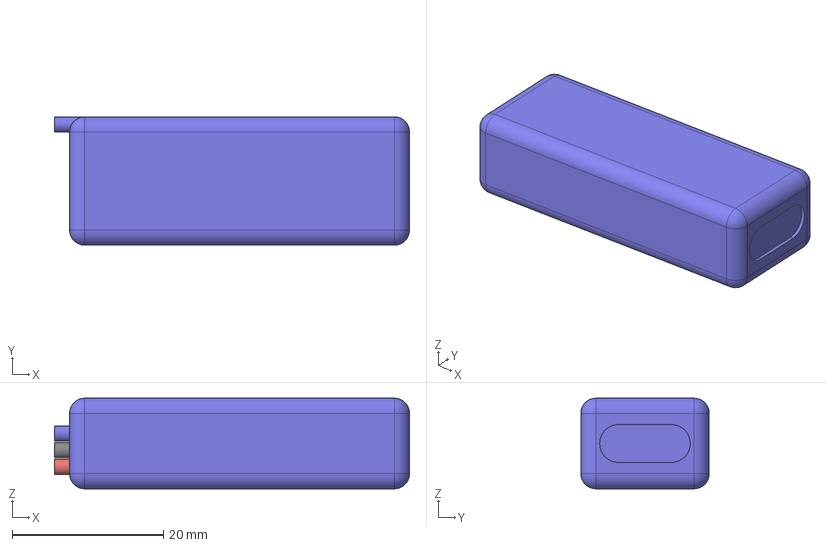
[picture p68: CAD file, 2022-11-20]
00 Modelisme/Battery/Turnigy/LiPo 2S 300mAh.stp
47.0 x 17.0 x 12.0 mm
