ZINKTiti/30-bibliotheque-Modelisme/00 Modelisme/Moteur/Bruchless/Axi/AXI_28XX.FCStd

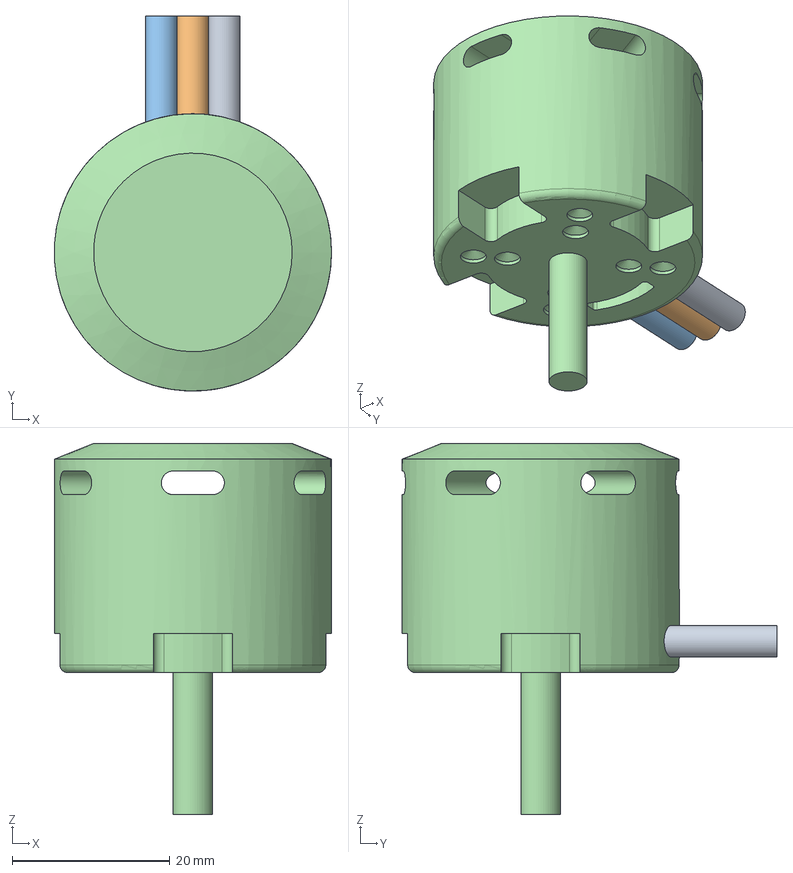
[picture p69: CAD file, 2022-02-01]
00 Modelisme/Moteur/Bruchless/Axi/AXI_28XX.FCStd
35.2 x 47.6 x 47.1 mm
Cylindre
Cylindre001
Cylindre002
