ZINKTiti/30-bibliotheque-Modelisme/00 Modelisme/Moteur/Bruchless/Hacker/A50/HACKER A50-10L Turnado V3.stp

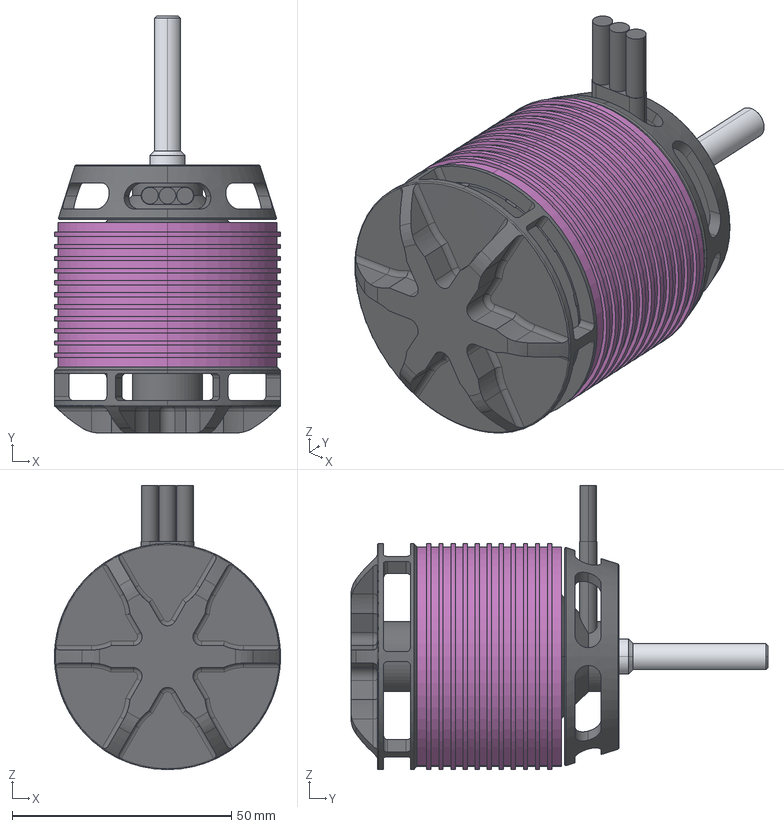
[picture p71: CAD file, 2024-11-10]
00 Modelisme/Moteur/Bruchless/Hacker/A50/HACKER A50-10L Turnado V3.stp
51.5 x 95.0 x 64.8 mm
HACKER_A50-10L_Turnado_V3_Rotor
HACKER_A50-10L_Turnado_V3_Stator
