ZINKTiti/30-bibliotheque-Modelisme/00 Modelisme/Moteur/Bruchless/Propdrive 2826 V2.STEP

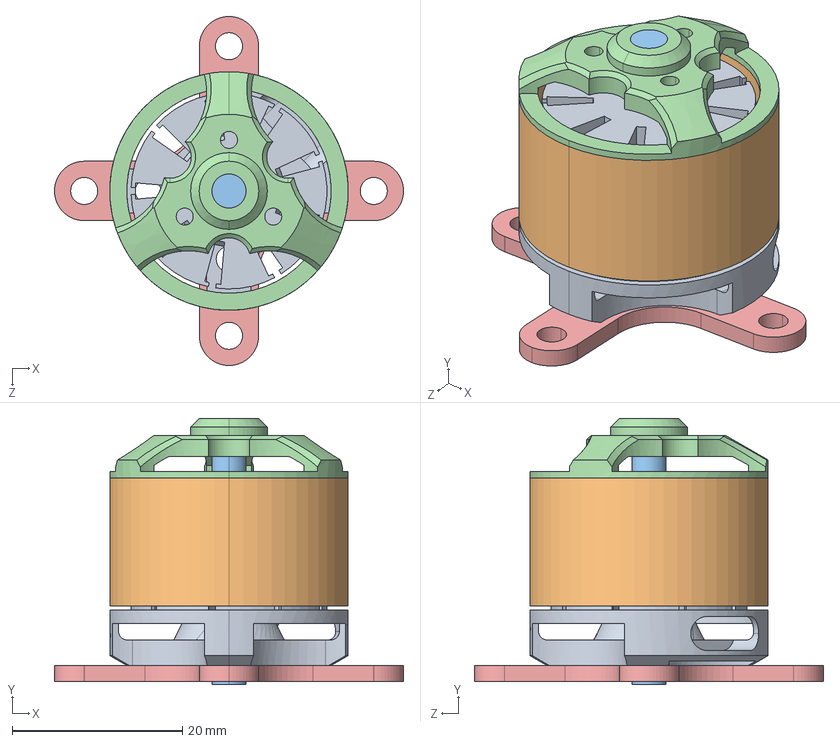
[picture p72: CAD file, 2022-11-20]
00 Modelisme/Moteur/Bruchless/Propdrive 2826 V2.STEP
41.0 x 31.2 x 41.0 mm
Propdrive 2826 V2 Stator
Propdrive 2826 V2 Rotor
Propdrive 2826 V2 Mount_Valor predeterminado
