ZINKTiti/30-bibliotheque-Modelisme/00 Modelisme/Moteur/Bruchless/Turnigy/Turnigy Motor D3542-4.STEP

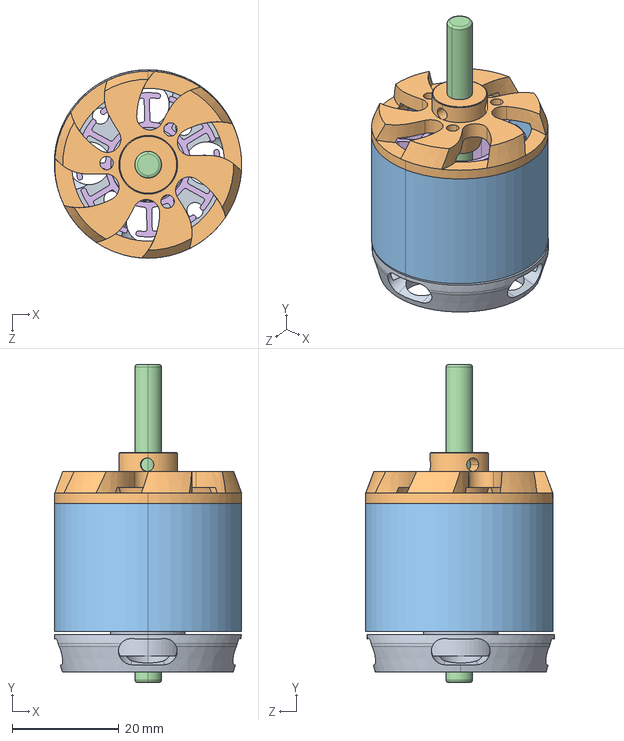
[picture p73: CAD file, 2024-11-10]
00 Modelisme/Moteur/Bruchless/Turnigy/Turnigy Motor D3542-4.STEP
35.1 x 59.5 x 35.3 mm
