ZINKTiti/30-bibliotheque-Modelisme/00 Modelisme/Recepteur/Futaba/futaba R2008sb.stp

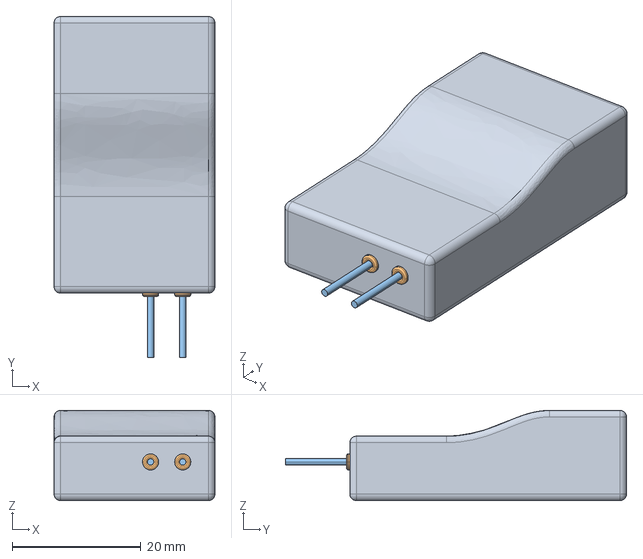
[picture p74: CAD file, 2022-01-30]
00 Modelisme/Recepteur/Futaba/futaba R2008sb.stp
25.0 x 53.0 x 14.0 mm
