ZINKTiti/30-bibliotheque-Modelisme/00 Modelisme/Recepteur/Graupner/Graupner XR-16 iFS.stp

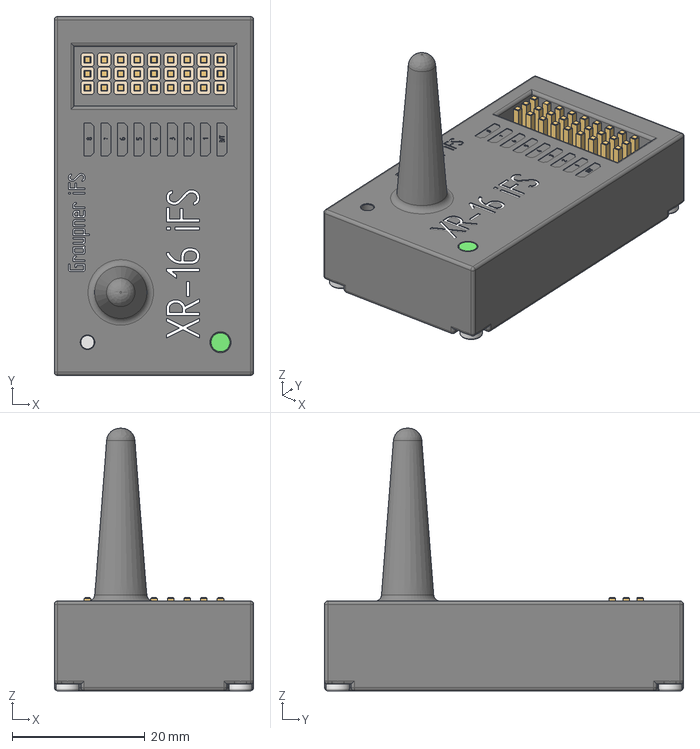
[picture p75: CAD file, 2022-01-30]
00 Modelisme/Recepteur/Graupner/Graupner XR-16 iFS.stp
30.0 x 54.0 x 39.5 mm
