ZINKTiti/30-bibliotheque-Modelisme/00 Modelisme/Recepteur/Jeti/Jeti Duplex Rmk2 2.4GHz RX.stp

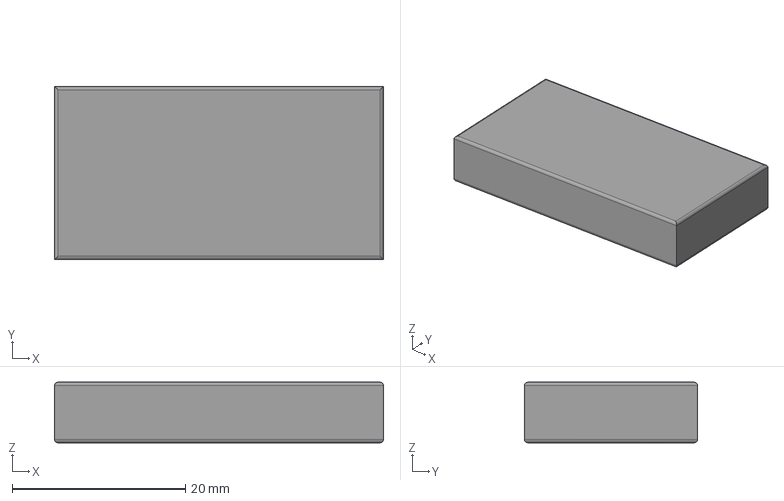
[picture p76: CAD file, 2022-01-30]
00 Modelisme/Recepteur/Jeti/Jeti Duplex Rmk2 2.4GHz RX.stp
38.0 x 20.0 x 7.00 mm
