ZINKTiti/30-bibliotheque-Modelisme/00 Modelisme/Servos/Accesories/XT60H-F v3.step

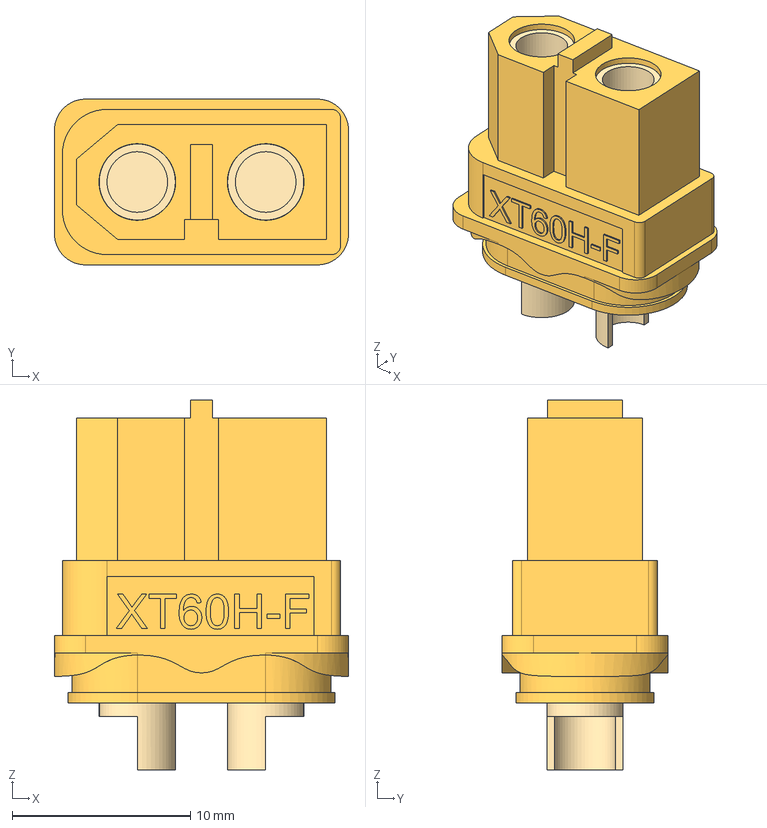
[picture p77: CAD file, 2022-03-02]
00 Modelisme/Servos/Accesories/XT60H-F v3.step
16.5 x 9.30 x 20.8 mm
Housing
Contact x 2
