ZINKTiti/30-bibliotheque-Modelisme/00 Modelisme/Servos/Ditex/DITEX EL0510M.stp

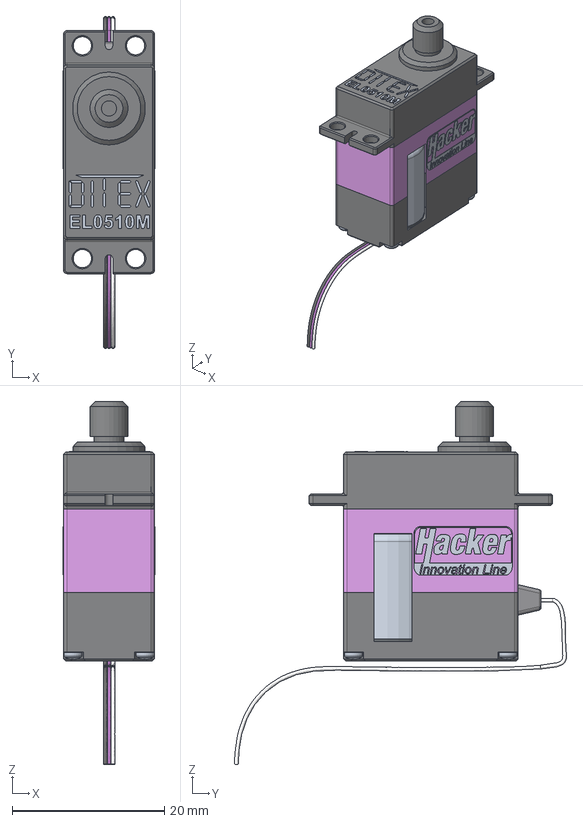
[picture p78: CAD file, 2024-11-10]
00 Modelisme/Servos/Ditex/DITEX EL0510M.stp
12.1 x 43.7 x 47.8 mm
