ZINKTiti/30-bibliotheque-Modelisme/00 Modelisme/Servos/Futaba/Futaba FP-S28.STEP

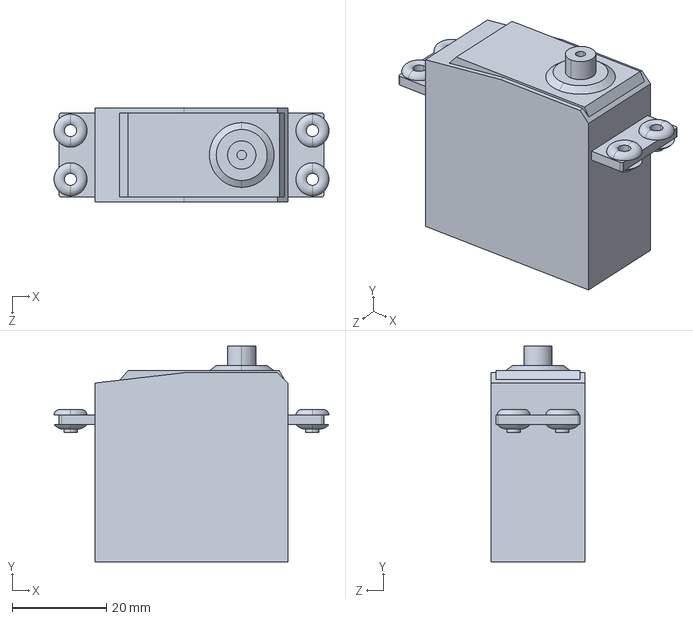
[picture p79: CAD file, 2022-01-30]
00 Modelisme/Servos/Futaba/Futaba FP-S28.STEP
58.2 x 45.7 x 19.9 mm
