ZINKTiti/30-bibliotheque-Modelisme/00 Modelisme/Servos/Futaba/Futaba3003/Futaba3003-big-rounded-horn.stp

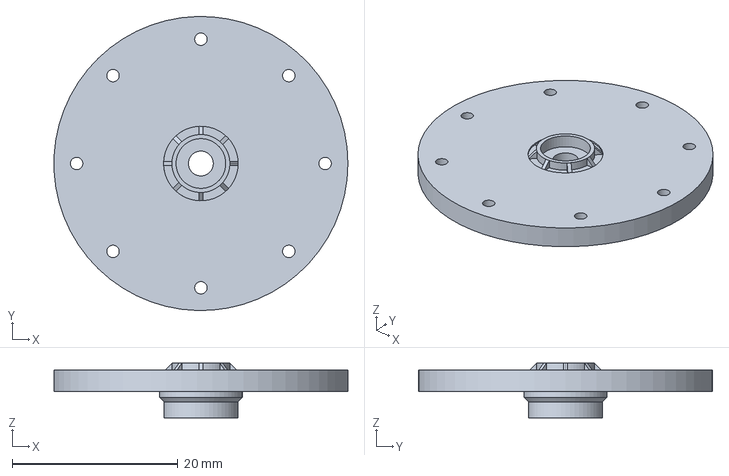
[picture p80: CAD file, 2022-01-30]
00 Modelisme/Servos/Futaba/Futaba3003/Futaba3003-big-rounded-horn.stp
35.5 x 35.5 x 6.60 mm
