ZINKTiti/30-bibliotheque-Modelisme/00 Modelisme/Servos/Goteck/Goteck BL1511S.stp

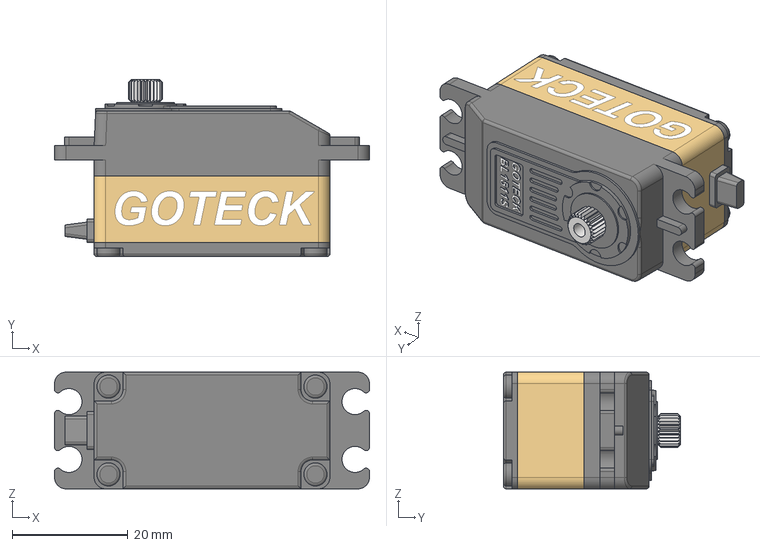
[picture p81: CAD file, 2022-01-30]
00 Modelisme/Servos/Goteck/Goteck BL1511S.stp
54.5 x 30.7 x 20.2 mm
