ZINKTiti/30-bibliotheque-Modelisme/00 Modelisme/Servos/Graupner/C508.igs

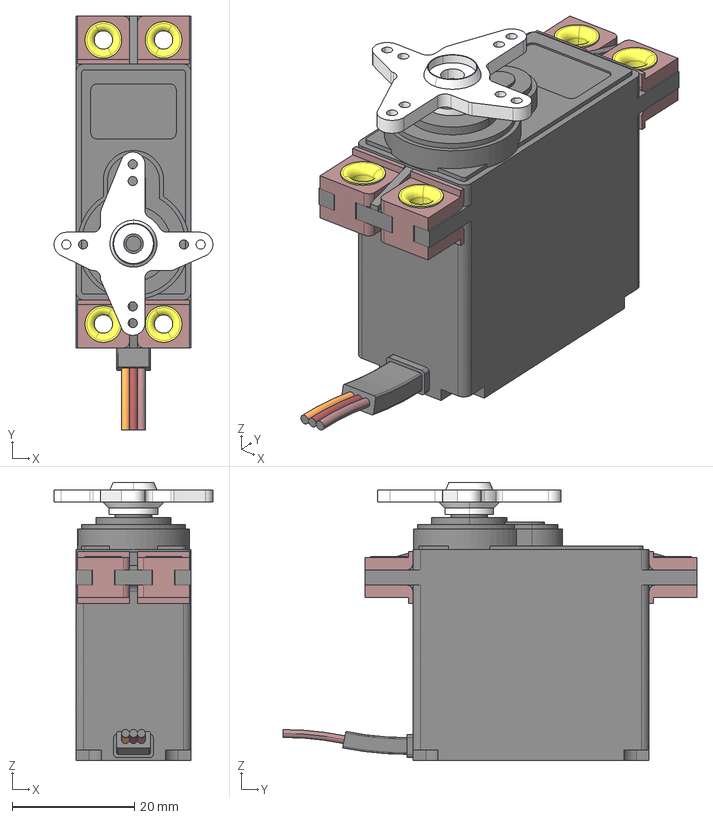
[picture p82: CAD file, 2022-01-30]
00 Modelisme/Servos/Graupner/C508.igs
26.0 x 67.7 x 45.5 mm
