ZINKTiti/30-bibliotheque-Modelisme/00 Modelisme/Servos/Hitec/HS-55.step

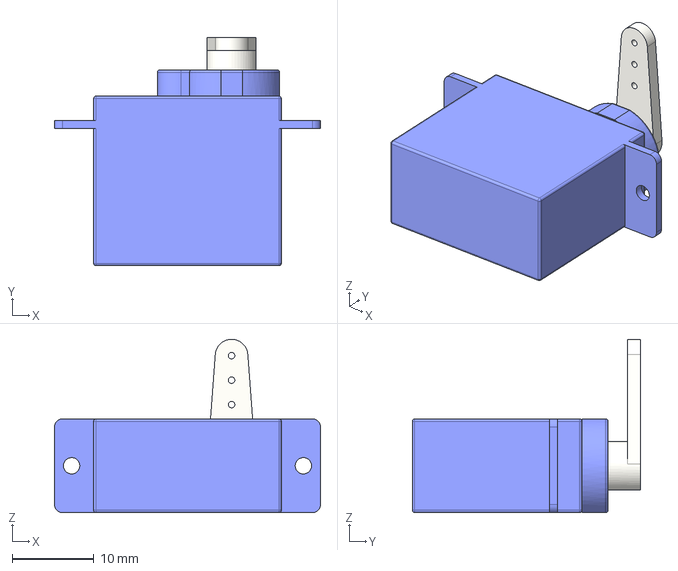
[picture p83: CAD file, 2022-01-30]
00 Modelisme/Servos/Hitec/HS-55.step
32.6 x 28.0 x 21.3 mm
