ZINKTiti/30-bibliotheque-Modelisme/00 Modelisme/Servos/Inconnu/SG-90/SG90-1-arm-horn.step

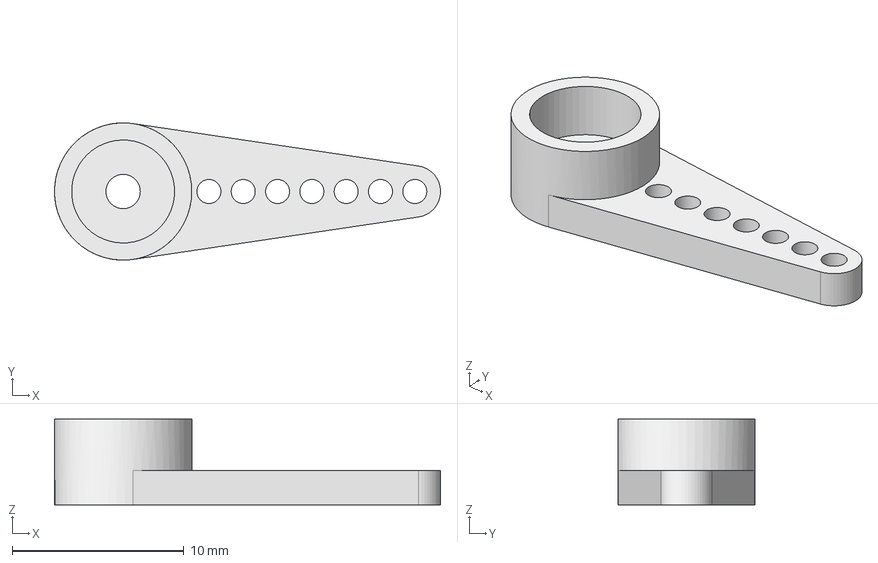
[picture p84: CAD file, 2022-01-30]
00 Modelisme/Servos/Inconnu/SG-90/SG90-1-arm-horn.step
22.5 x 8.00 x 5.00 mm
