ZINKTiti/30-bibliotheque-Modelisme/00 Modelisme/Servos/KST/KST DS225MG HV Coreless.stp

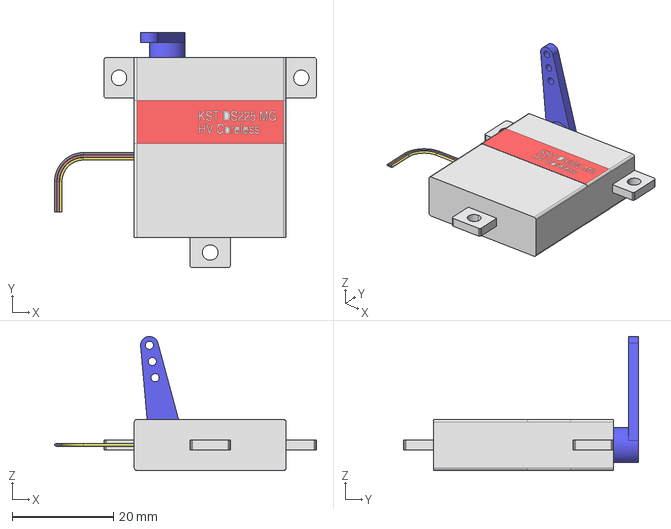
[picture p85: CAD file, 2022-01-30]
00 Modelisme/Servos/KST/KST DS225MG HV Coreless.stp
51.8 x 46.5 x 26.5 mm
