ZINKTiti/30-bibliotheque-Modelisme/00 Modelisme/Servos/Savox/SH-0257MG.stp

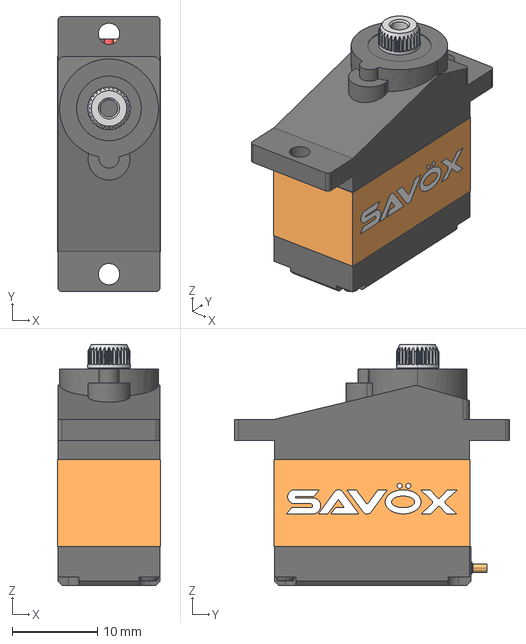
[picture p86: CAD file, 2022-01-30]
00 Modelisme/Servos/Savox/SH-0257MG.stp
12.1 x 32.3 x 28.3 mm
