ZINKTiti/30-bibliotheque-Modelisme/00 Modelisme/Servos/SERVO FLAT PARAMTERIQUE.FCStd

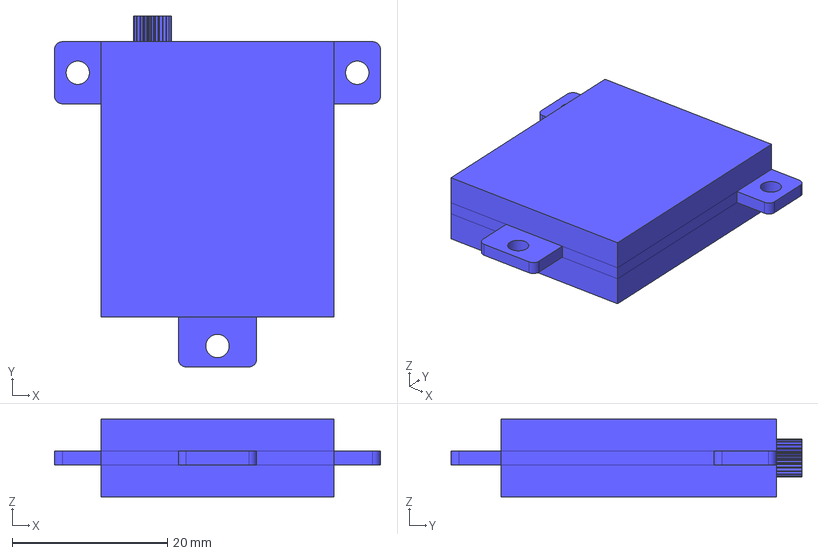
[picture p87: CAD file, 2022-11-20]
00 Modelisme/Servos/SERVO FLAT PARAMTERIQUE.FCStd
42.0 x 45.2 x 10.0 mm
