ZINKTiti/30-bibliotheque-Modelisme/00 Modelisme/Servos/TowerPro/MG946R.STL

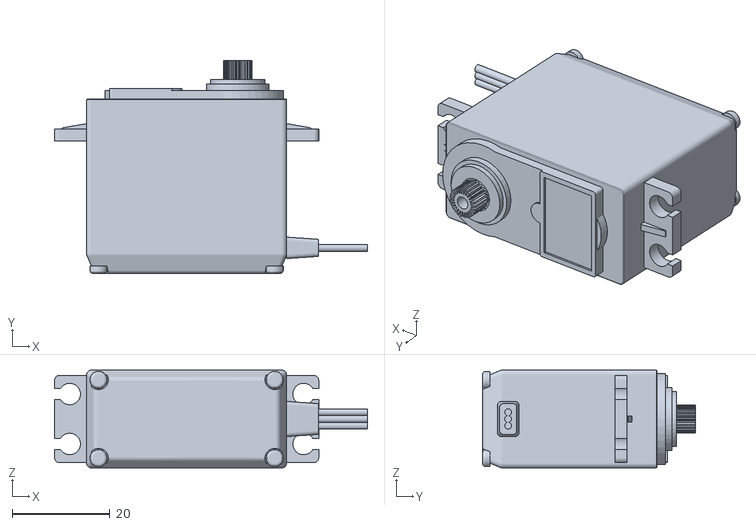
[picture p88: CAD file, 2022-01-30]
00 Modelisme/Servos/TowerPro/MG946R.STL
64.0 x 43.4 x 20.0
