ZINKTiti/30-bibliotheque-Modelisme/00 Modelisme/Servos/Turnigy/TG6Y-9018MG.step

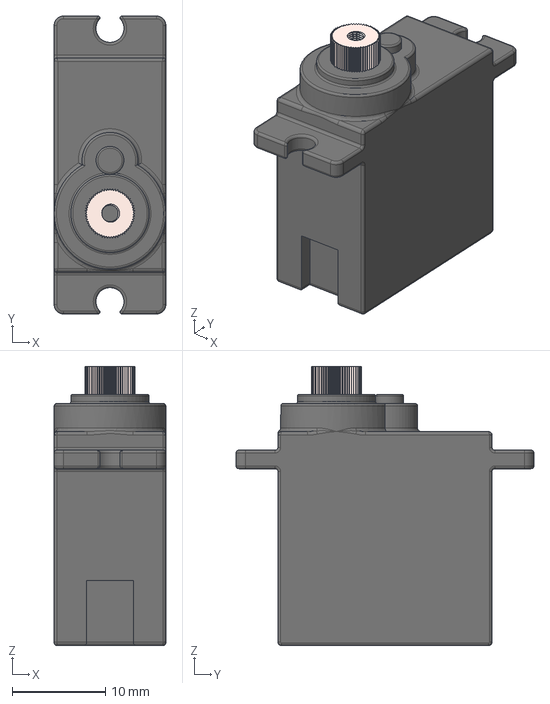
[picture p89: CAD file, 2022-01-30]
00 Modelisme/Servos/Turnigy/TG6Y-9018MG.step
12.0 x 32.0 x 30.0 mm
