ZINKTiti/30-bibliotheque-Modelisme/01 Electronique/Arduino/COMMON SHIELDS/pololu-A500.step

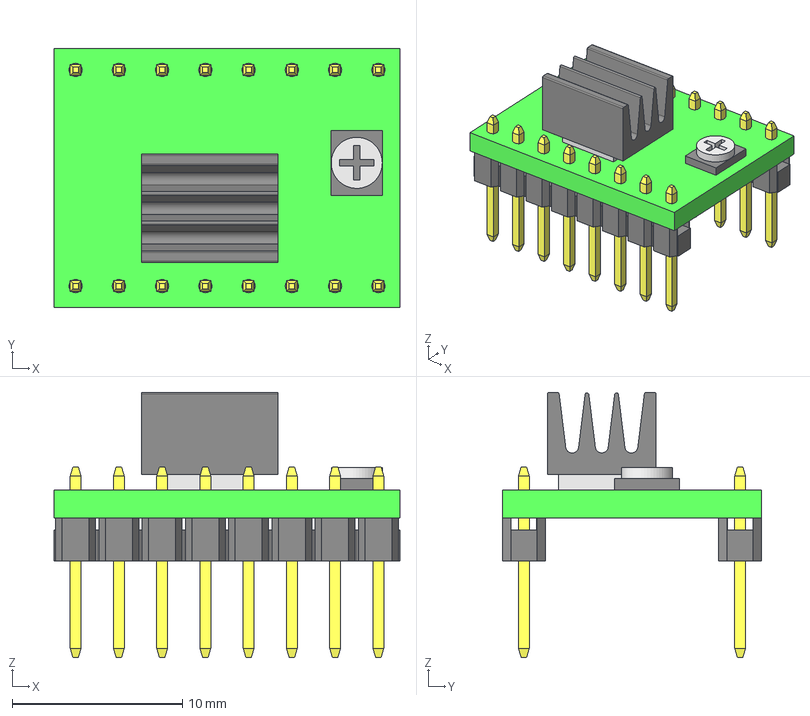
[picture p90: CAD file, 2022-01-30]
01 Electronique/Arduino/COMMON SHIELDS/pololu-A500.step
20.3 x 15.2 x 15.6 mm
