ZINKTiti/30-bibliotheque-Modelisme/01 Electronique/Arduino/MEGA/arduino-mega.fcstd

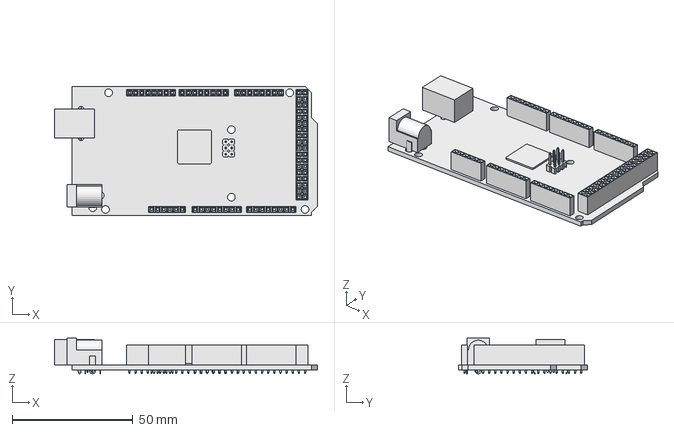
[picture p91: CAD file, 2022-01-30]
01 Electronique/Arduino/MEGA/arduino-mega.fcstd
108.8 x 53.2 x 14.8 mm
