ZINKTiti/30-bibliotheque-Modelisme/01 Electronique/Arduino/MEGA/SHIELDS/ramps-1_4.stl

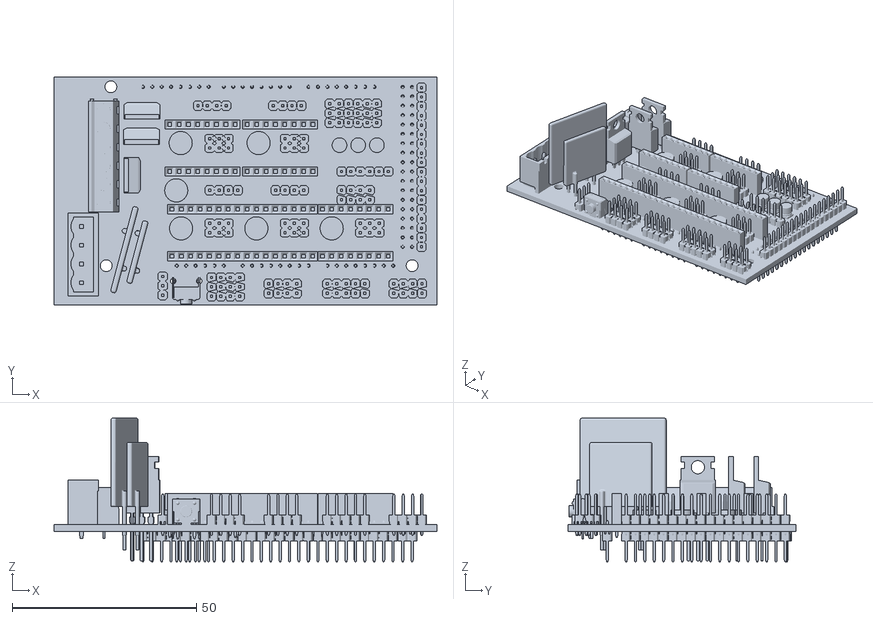
[picture p92: CAD file, 2022-01-30]
01 Electronique/Arduino/MEGA/SHIELDS/ramps-1_4.stl
103.9 x 61.8 x 39.0
