ZINKTiti/30-bibliotheque-Modelisme/01 Electronique/Arduino/NANO/Nano-Rev3_0.step

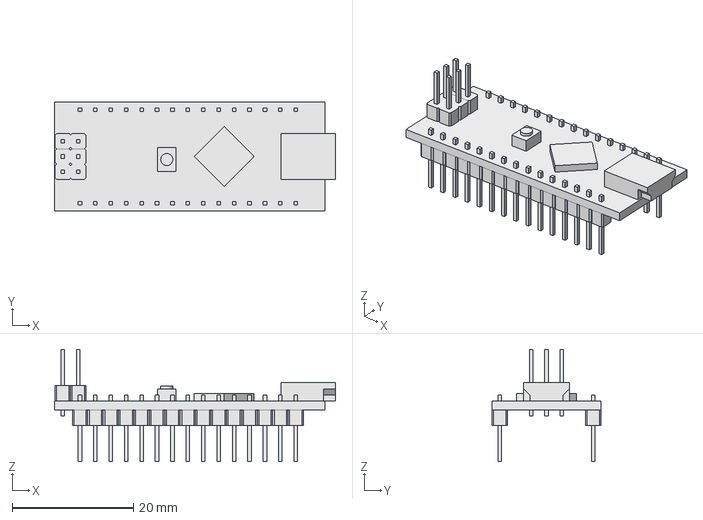
[picture p93: CAD file, 2022-01-30]
01 Electronique/Arduino/NANO/Nano-Rev3_0.step
46.3 x 18.0 x 18.5 mm
