ZINKTiti/30-bibliotheque-Modelisme/01 Electronique/Arduino/NANO/SHIELDS/nano_expansion_shield.fcstd

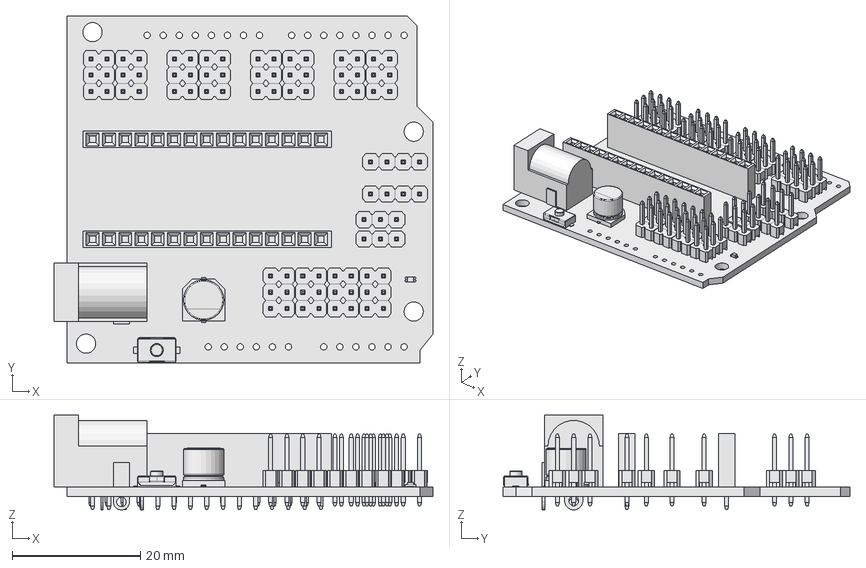
[picture p94: CAD file, 2022-01-30]
01 Electronique/Arduino/NANO/SHIELDS/nano_expansion_shield.fcstd
59.0 x 54.0 x 14.8 mm
