ZINKTiti/30-bibliotheque-Modelisme/01 Electronique/Arduino/UNO/freaduino-uno.fcstd

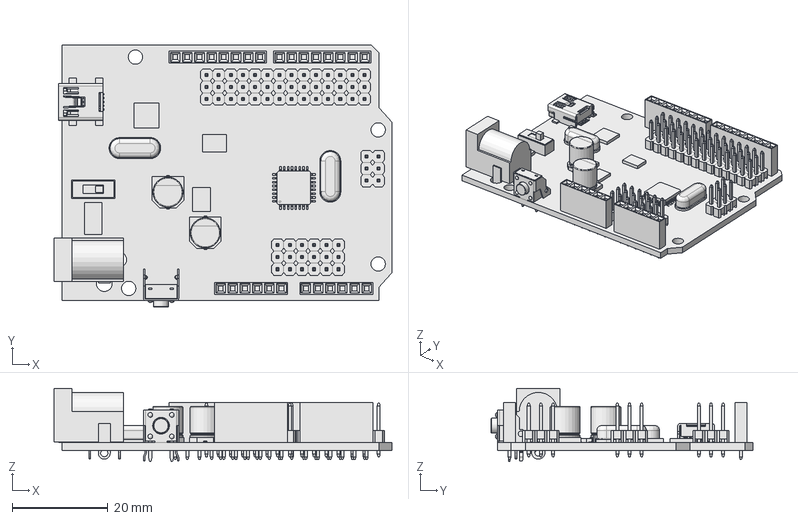
[picture p95: CAD file, 2022-01-30]
01 Electronique/Arduino/UNO/freaduino-uno.fcstd
70.6 x 54.6 x 15.3 mm
