ZINKTiti/30-bibliotheque-Modelisme/01 Electronique/dupont-connectors/dupont-2_54mm-female-connector.fcstd

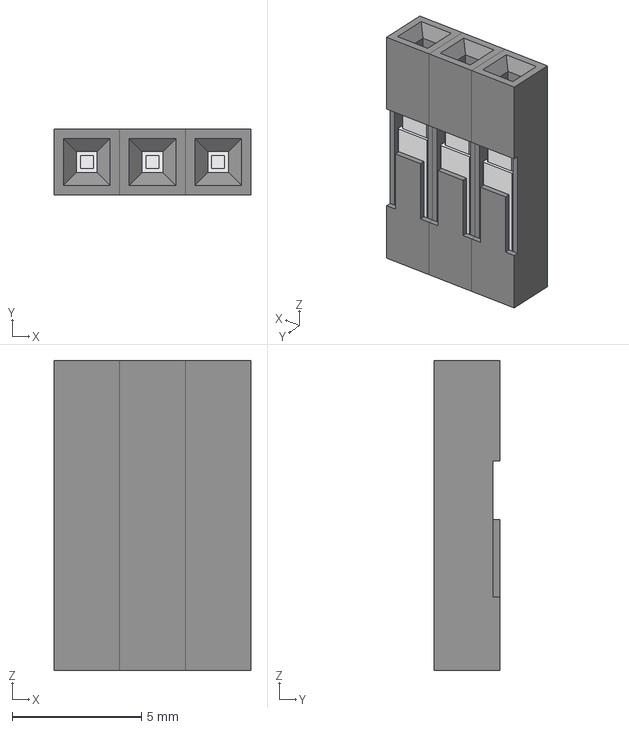
[picture p96: CAD file, 2022-01-30]
01 Electronique/dupont-connectors/dupont-2_54mm-female-connector.fcstd
7.62 x 2.54 x 12.0 mm
Case
Pins
