ZINKTiti/30-bibliotheque-Modelisme/01 Electronique/fans/fan-50x50mm.step

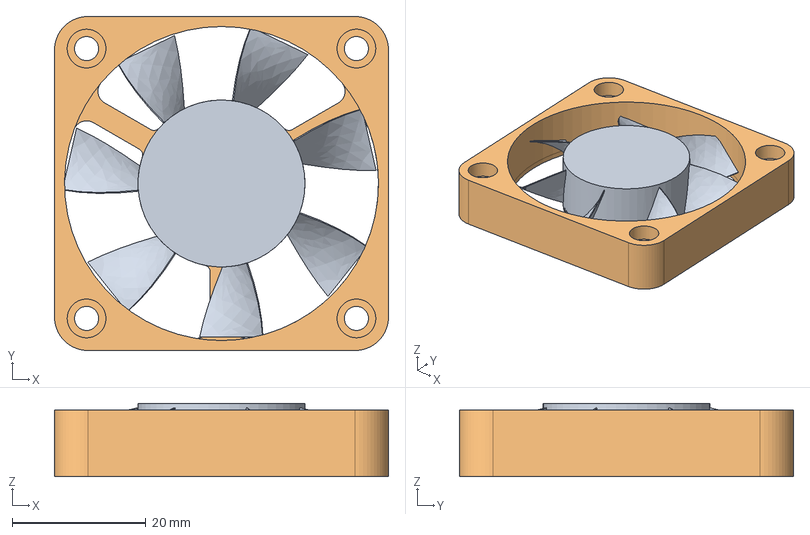
[picture p97: CAD file, 2022-01-30]
01 Electronique/fans/fan-50x50mm.step
50.0 x 50.0 x 11.0 mm
