ZINKTiti/30-bibliotheque-Modelisme/01 Electronique/Fin de course/endstopsmall.stp

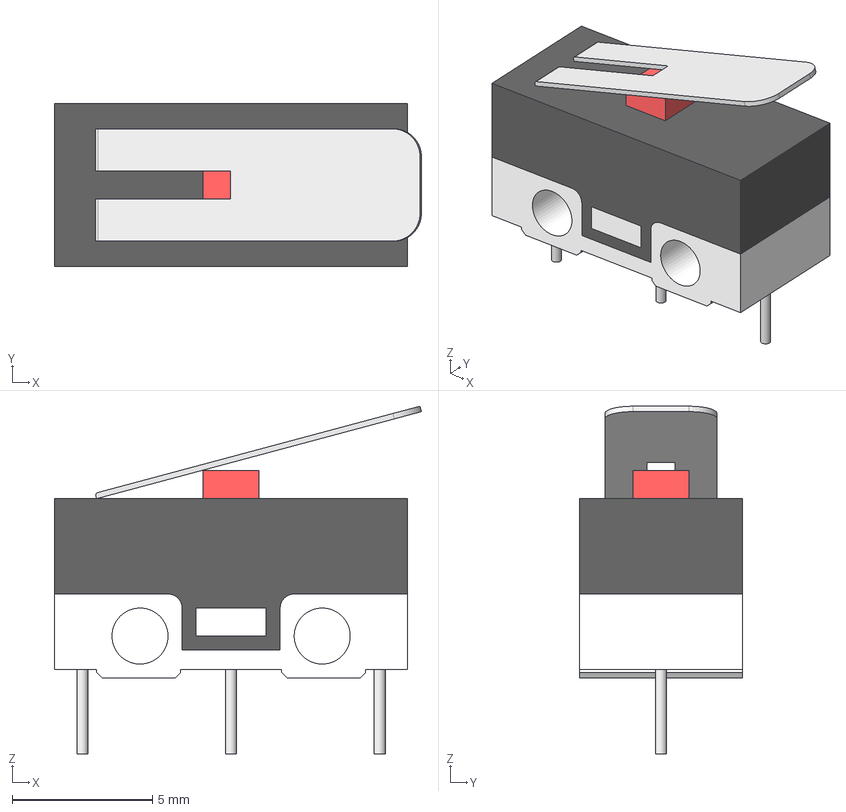
[picture p98: CAD file, 2022-01-30]
01 Electronique/Fin de course/endstopsmall.stp
13.1 x 5.80 x 12.4 mm
