ZINKTiti/30-bibliotheque-Modelisme/01 Electronique/Fin de course/Fin de course rouge/Konstruktion24.stp

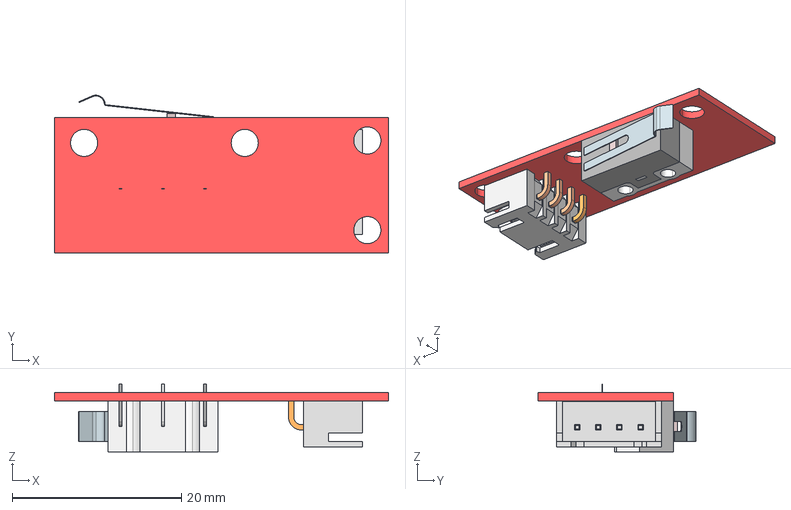
[picture p99: CAD file, 2022-01-30]
01 Electronique/Fin de course/Fin de course rouge/Konstruktion24.stp
39.5 x 18.6 x 8.00 mm
Konstruktion24
PCB^Endstop
Microswitch_1A_125vAC(seul)
JST 4Pin
