ZINKTiti/30-bibliotheque-Modelisme/01 Electronique/LCD/2-2-tft-lcd-screen/2.2 TFT ILI9341 - Flush- With Glass.stp

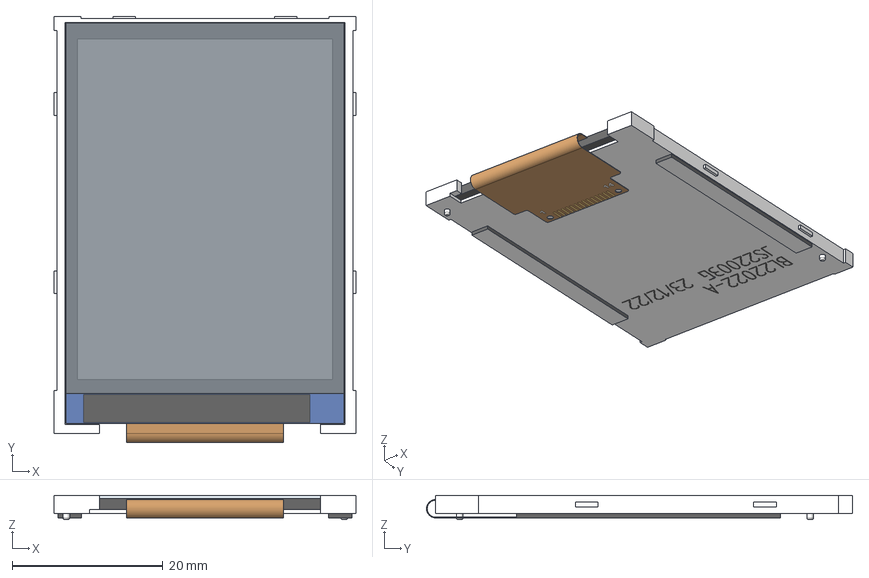
[picture p100: CAD file, 2025-01-18]
01 Electronique/LCD/2-2-tft-lcd-screen/2.2 TFT ILI9341 - Flush- With Glass.stp
40.0 x 56.5 x 3.22 mm
2.2 TFT ILI9341 - Flush
Glass
