ZINKTiti/30-bibliotheque-Modelisme/01 Electronique/LCD/lcd-4x20-backlight.step

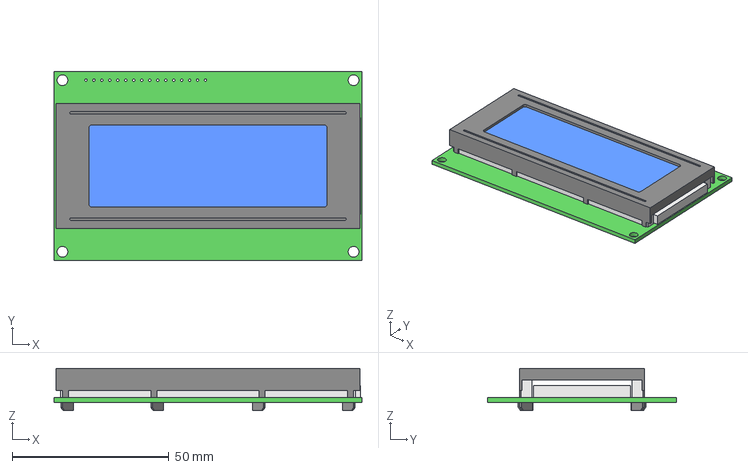
[picture p101: CAD file, 2022-01-30]
01 Electronique/LCD/lcd-4x20-backlight.step
98.2 x 60.1 x 13.4 mm
