ZINKTiti/30-bibliotheque-Modelisme/01 Electronique/LCD/tft-lcd-2-4-inch-ili9341-touch-320x240/TFT LCD 2.4 inch ILI9341.step

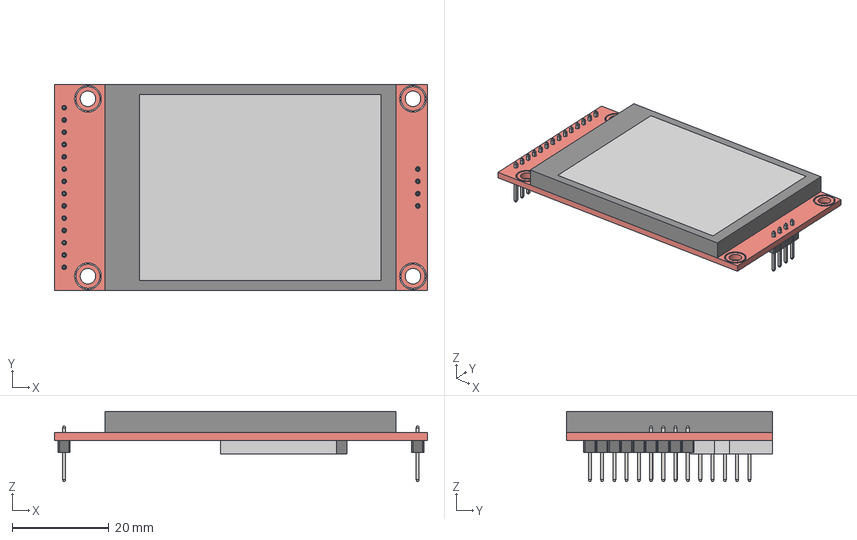
[picture p102: CAD file, 2025-01-18]
01 Electronique/LCD/tft-lcd-2-4-inch-ili9341-touch-320x240/TFT LCD 2.4 inch ILI9341.step
77.2 x 42.7 x 14.5 mm
1x1_Pin_Header_2.54mm x 4
1x1_Pin_Header_2.54mm_1 x 14
