ZINKTiti/30-bibliotheque-Modelisme/01 Electronique/Motors/01 NEMA/Nema-17_Mount_Bracket/Nema-17_MountBracket.step

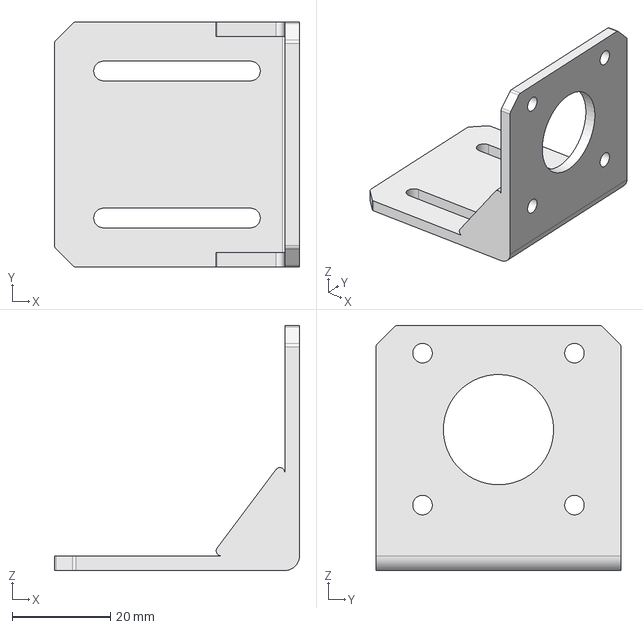
[picture p103: CAD file, 2022-01-30]
01 Electronique/Motors/01 NEMA/Nema-17_Mount_Bracket/Nema-17_MountBracket.step
50.0 x 50.0 x 50.0 mm
