ZINKTiti/30-bibliotheque-Modelisme/01 Electronique/Motors/01 NEMA/NEMA_17_with_connector.FCStd

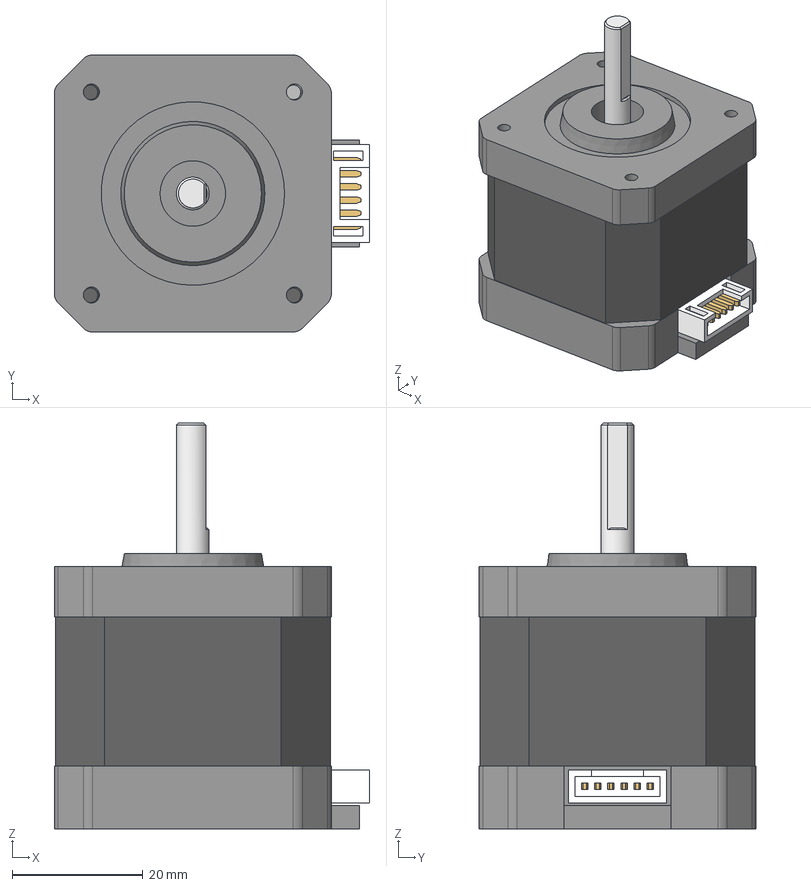
[picture p104: CAD file, 2022-01-30]
01 Electronique/Motors/01 NEMA/NEMA_17_with_connector.FCStd
48.2 x 42.3 x 62.0 mm
Aluminium rear001
Aluminum front001
Rotor
M2.5x25-Screw
M2.5x25-Screw006
M2.5x25-Screw005
M2.5x25-Screw007
conector
pin
