ZINKTiti/30-bibliotheque-Modelisme/01 Electronique/Motors/DC_Gear_Motor_37mm.fcstd

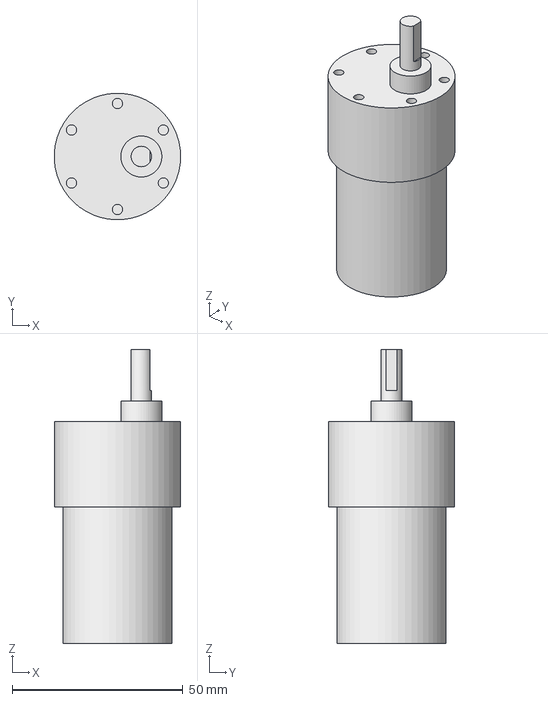
[picture p105: CAD file, 2022-01-30]
01 Electronique/Motors/DC_Gear_Motor_37mm.fcstd
37.0 x 37.0 x 86.0 mm
