ZINKTiti/30-bibliotheque-Modelisme/02 Mecanique/Embout a Rotule/Embout à rotule mâle DIN ISO 12240-4.FCStd

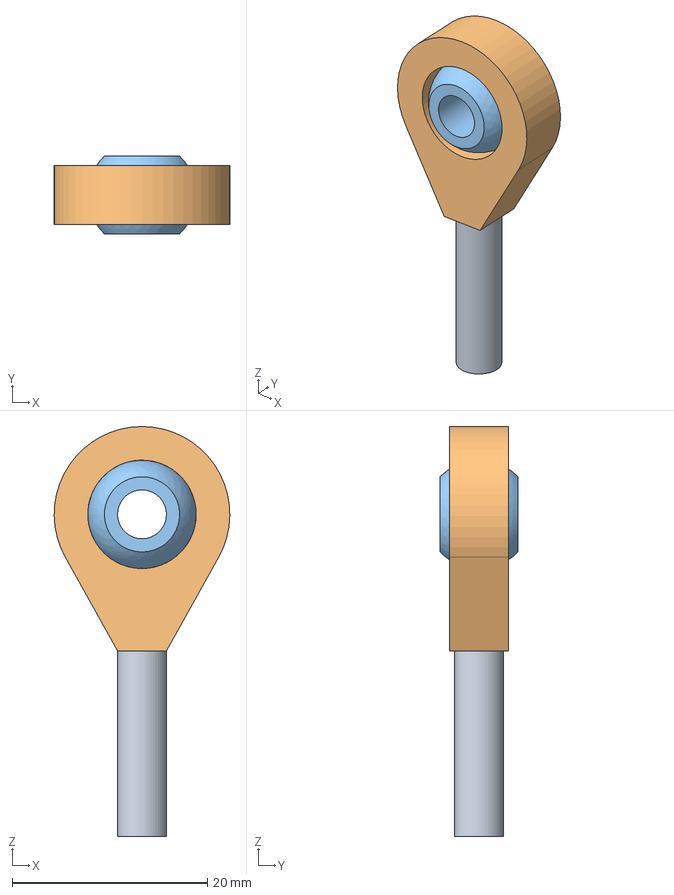
[picture p106: CAD file, 2022-02-02]
02 Mecanique/Embout a Rotule/Embout à rotule mâle DIN ISO 12240-4.FCStd
18.0 x 8.00 x 42.0 mm
Cylindre006
