ZINKTiti/30-bibliotheque-Modelisme/02 Mecanique/Insert Ruthex/RX-M5x9.5.step

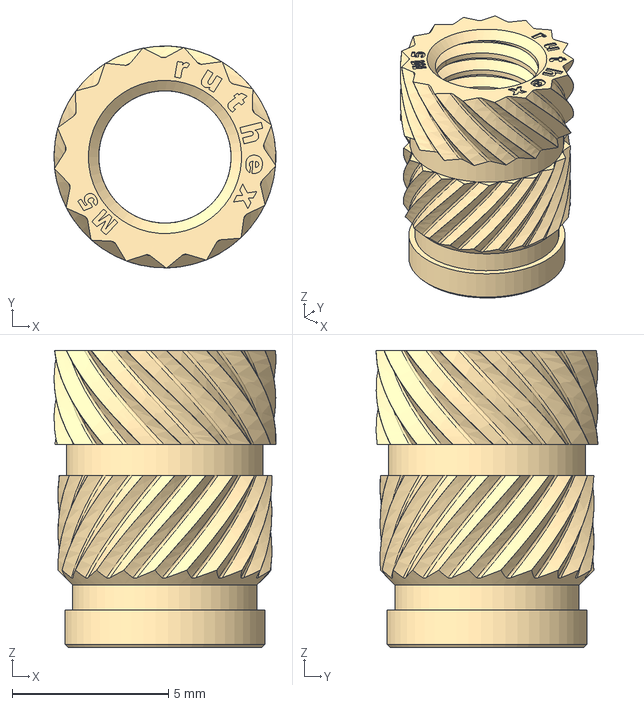
[picture p107: CAD file, 2022-02-15]
02 Mecanique/Insert Ruthex/RX-M5x9.5.step
7.10 x 7.10 x 9.50 mm
