ZINKTiti/30-bibliotheque-Modelisme/02 Mecanique/Profiles EN/BOSCH/Profile Bosh 30x30mm.FCStd

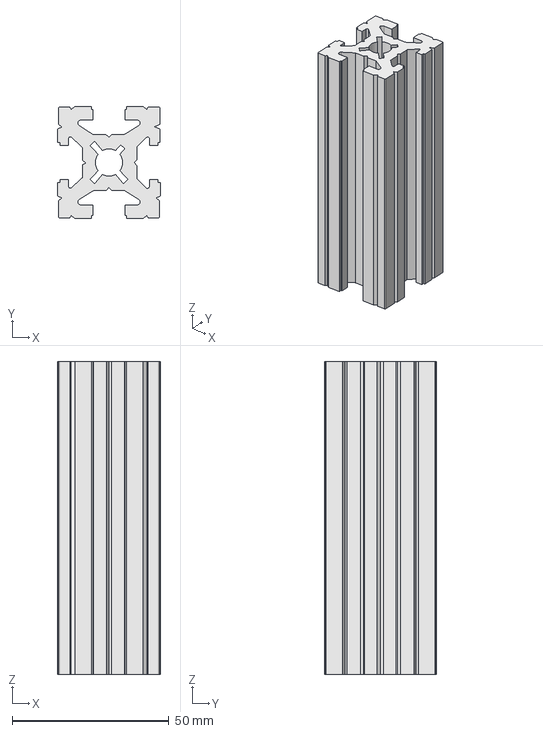
[picture p108: CAD file, 2022-01-30]
02 Mecanique/Profiles EN/BOSCH/Profile Bosh 30x30mm.FCStd
32.9 x 35.9 x 100.0 mm
