ZINKTiti/30-bibliotheque-Modelisme/02 Mecanique/Profiles EN/EN10056 Equal Angle Bars/Angle Bar L60x60x6 EN10056 S235JR.step

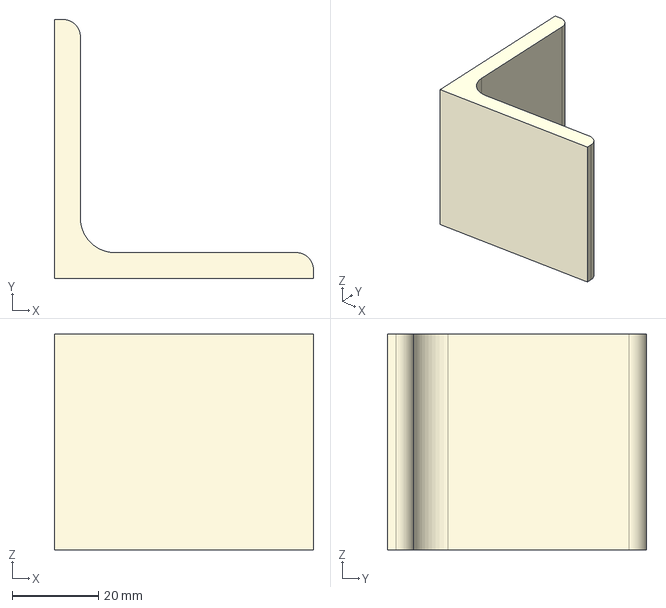
[picture p109: CAD file, 2022-01-30]
02 Mecanique/Profiles EN/EN10056 Equal Angle Bars/Angle Bar L60x60x6 EN10056 S235JR.step
60.0 x 60.0 x 50.0 mm
