ZINKTiti/30-bibliotheque-Modelisme/02 Mecanique/Profiles EN/EN10056 Unequal Angle Bars/Angle Bar 70x50x6 EN10056 S235JR.step

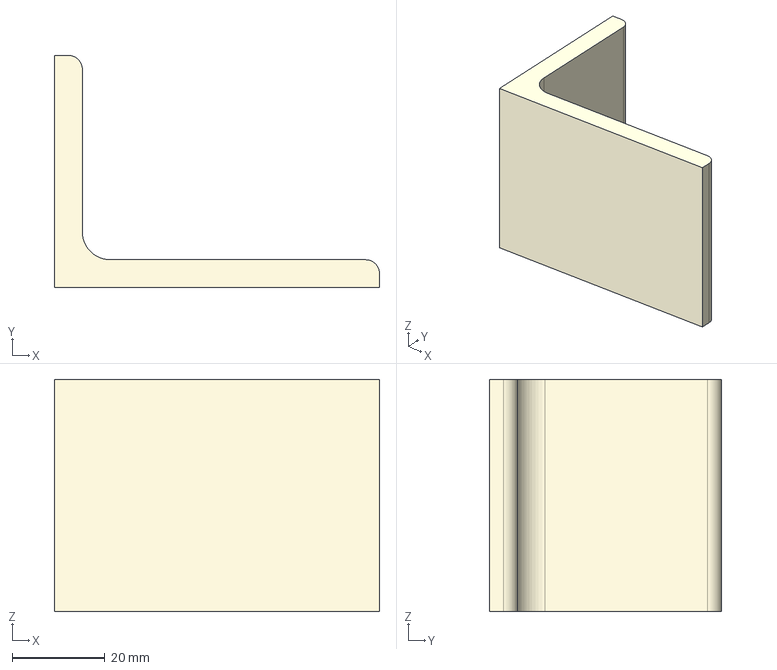
[picture p110: CAD file, 2022-01-30]
02 Mecanique/Profiles EN/EN10056 Unequal Angle Bars/Angle Bar 70x50x6 EN10056 S235JR.step
70.0 x 50.0 x 50.0 mm
