ZINKTiti/30-bibliotheque-Modelisme/02 Mecanique/Profiles EN/EN10058 Flat steel bars/Flat Bar 25x20 EN10058 S235JR.step

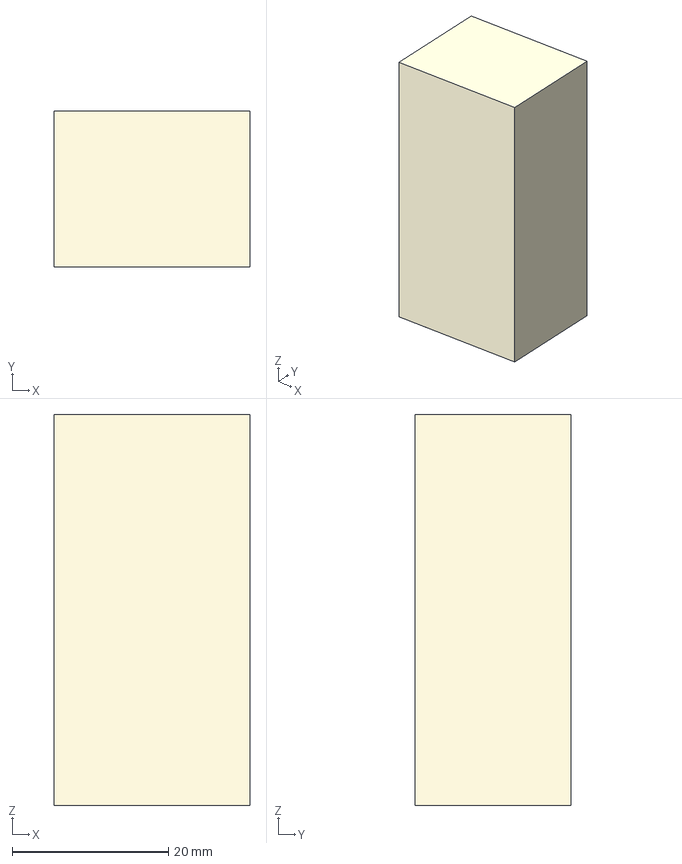
[picture p111: CAD file, 2022-01-30]
02 Mecanique/Profiles EN/EN10058 Flat steel bars/Flat Bar 25x20 EN10058 S235JR.step
25.0 x 20.0 x 50.0 mm
