ZINKTiti/30-bibliotheque-Modelisme/02 Mecanique/Profiles EN/EN10059 Square steel bars/Square Bar 150 EN10059 S235JR.step

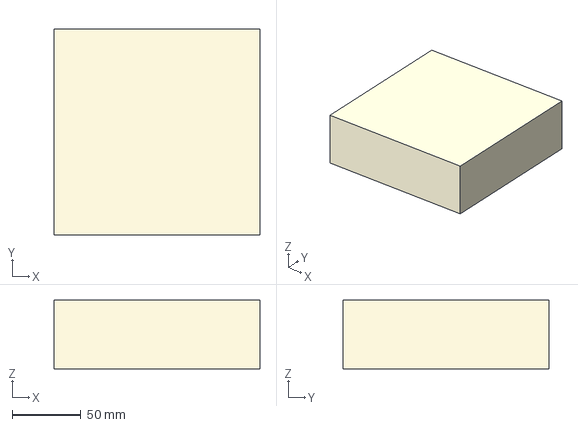
[picture p112: CAD file, 2022-01-30]
02 Mecanique/Profiles EN/EN10059 Square steel bars/Square Bar 150 EN10059 S235JR.step
150.0 x 150.0 x 50.0 mm
