ZINKTiti/30-bibliotheque-Modelisme/02 Mecanique/Profiles EN/EN10060 Round steel bars/Round Bar 40 EN10060 S235JR.step

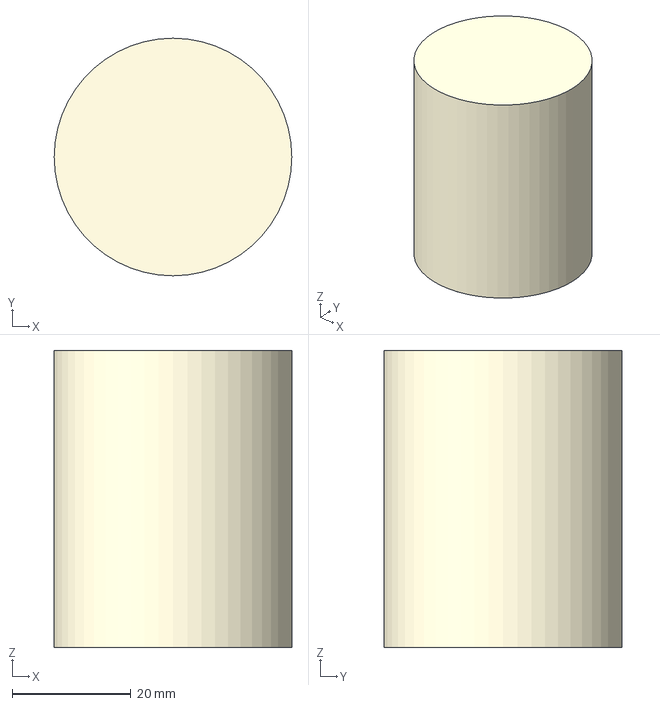
[picture p113: CAD file, 2022-01-30]
02 Mecanique/Profiles EN/EN10060 Round steel bars/Round Bar 40 EN10060 S235JR.step
40.0 x 40.0 x 50.0 mm
