ZINKTiti/30-bibliotheque-Modelisme/02 Mecanique/Profiles EN/EN10219 Rectangular Hollow Sections/Rectangular hollow section 120x60x5 EN10219 S235JRH.step

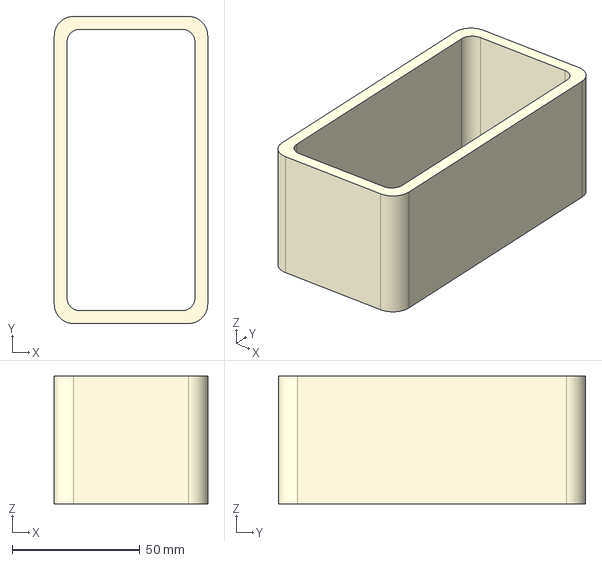
[picture p114: CAD file, 2022-01-30]
02 Mecanique/Profiles EN/EN10219 Rectangular Hollow Sections/Rectangular hollow section 120x60x5 EN10219 S235JRH.step
60.0 x 120.0 x 50.0 mm
