ZINKTiti/30-bibliotheque-Modelisme/02 Mecanique/Profiles EN/EN10219 Square Hollow Sections/Square hollow section 60x60x3 EN10219 S235JRH.step

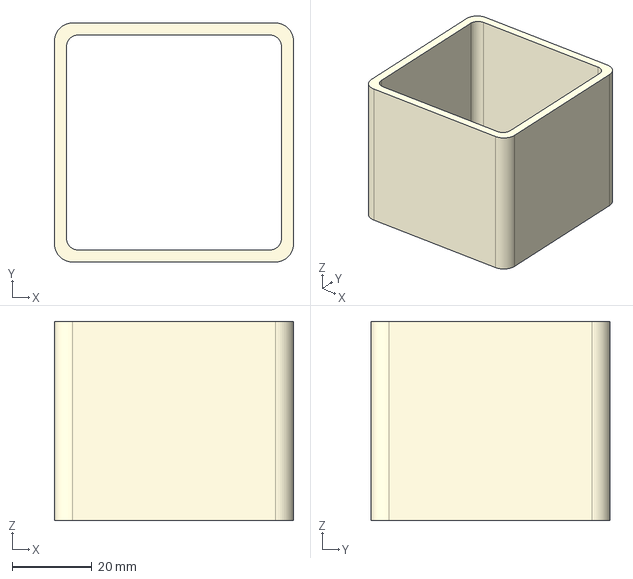
[picture p115: CAD file, 2022-01-30]
02 Mecanique/Profiles EN/EN10219 Square Hollow Sections/Square hollow section 60x60x3 EN10219 S235JRH.step
60.0 x 60.0 x 50.0 mm
