ZINKTiti/30-bibliotheque-Modelisme/02 Mecanique/Profiles EN/Item_Compatible_Profiles/Profile_20x20_I_Type_Slot5.stp

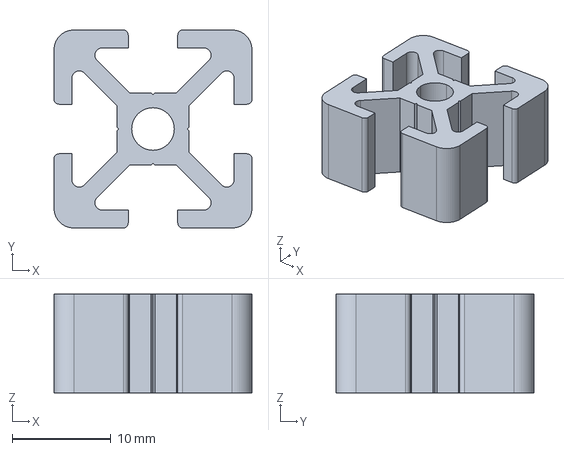
[picture p116: CAD file, 2022-01-30]
02 Mecanique/Profiles EN/Item_Compatible_Profiles/Profile_20x20_I_Type_Slot5.stp
20.0 x 20.0 x 10.0 mm
