ZINKTiti/30-bibliotheque-Modelisme/02 Mecanique/Profiles EN/Motedis/Profile-20x40-B-Type_Slot6.step

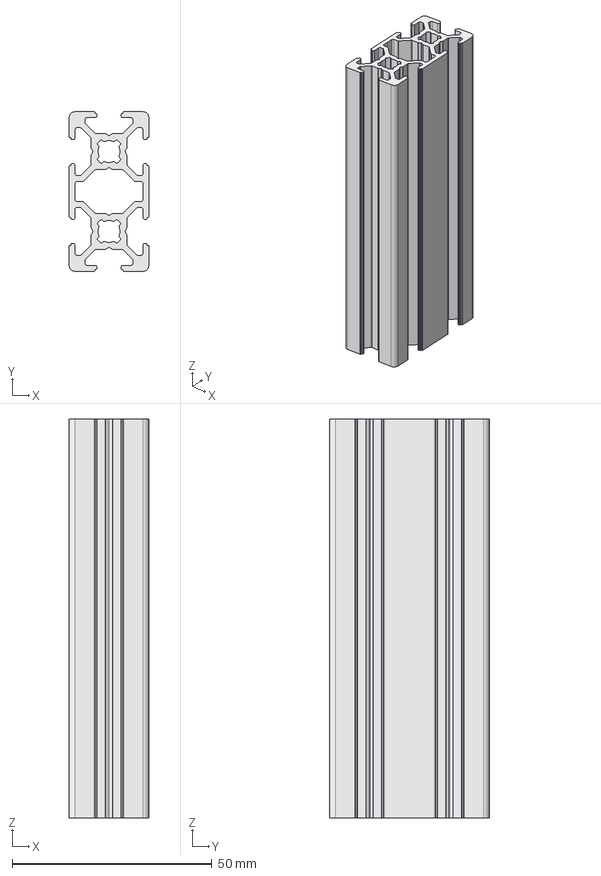
[picture p117: CAD file, 2022-01-30]
02 Mecanique/Profiles EN/Motedis/Profile-20x40-B-Type_Slot6.step
20.0 x 40.0 x 100.0 mm
