ZINKTiti/30-bibliotheque-Modelisme/02 Mecanique/Profiles EN/Sigma profiles/Profil kapagi 45x45.fcstd

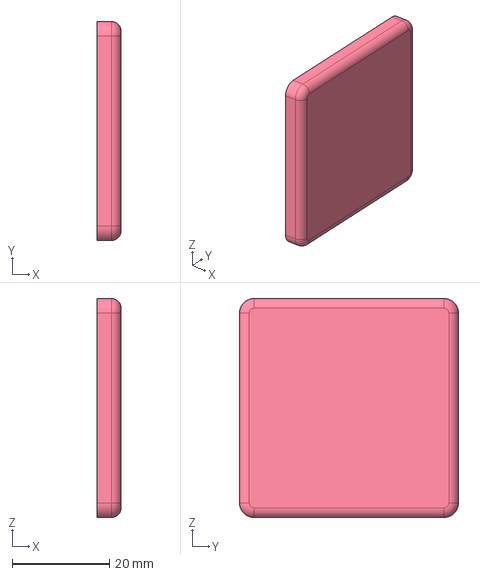
[picture p118: CAD file, 2022-01-30]
02 Mecanique/Profiles EN/Sigma profiles/Profil kapagi 45x45.fcstd
5.00 x 45.0 x 45.0 mm
