ZINKTiti/30-bibliotheque-Modelisme/02 Mecanique/Profiles EN/Symmetrical rail/TS35.fcstd

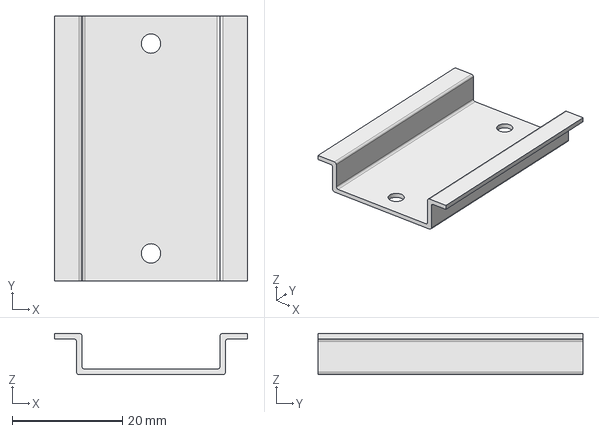
[picture p119: CAD file, 2022-01-30]
02 Mecanique/Profiles EN/Symmetrical rail/TS35.fcstd
35.0 x 48.0 x 7.50 mm
