ZINKTiti/30-bibliotheque-Modelisme/02 Mecanique/Profiles EN/VSlot/Vslot 2020 Parametrique.FCStd

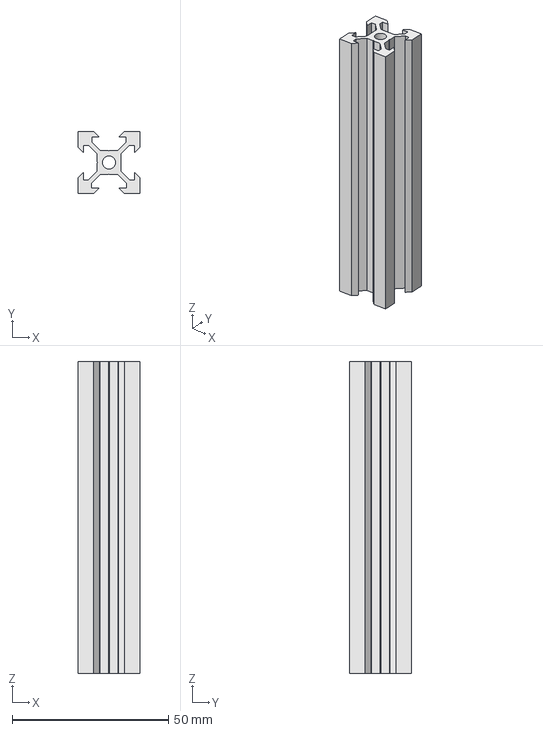
[picture p120: CAD file, 2022-02-15]
02 Mecanique/Profiles EN/VSlot/Vslot 2020 Parametrique.FCStd
20.0 x 20.0 x 100.0 mm
