ZINKTiti/30-bibliotheque-Modelisme/02 Mecanique/Roulement/LM8suu.fcstd

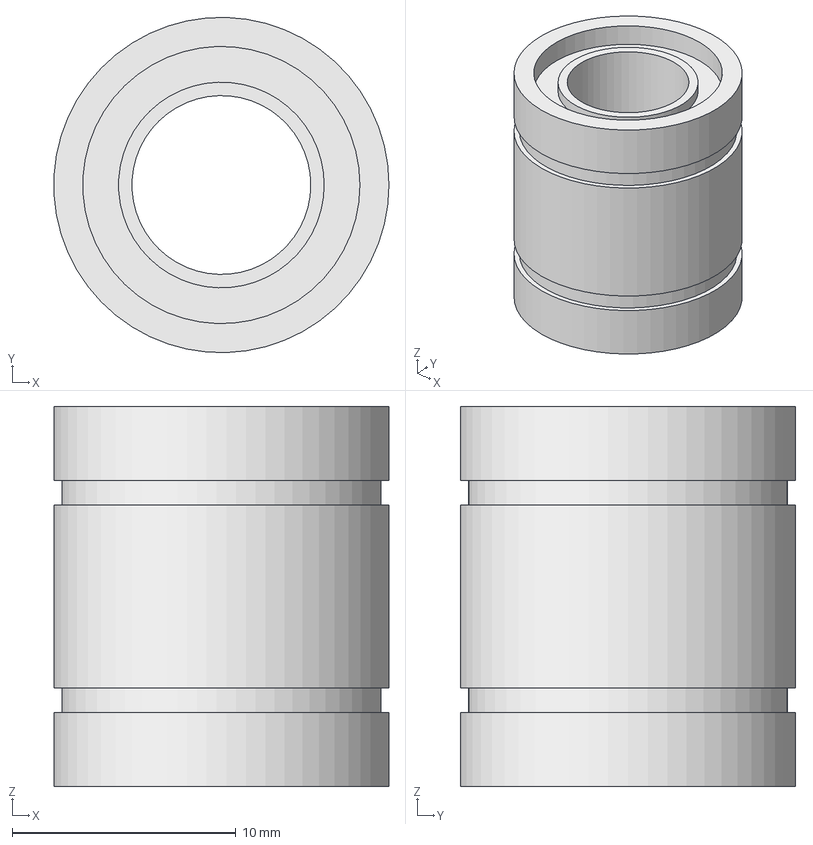
[picture p121: CAD file, 2022-01-30]
02 Mecanique/Roulement/LM8suu.fcstd
15.0 x 15.0 x 17.0 mm
