ZINKTiti/30-bibliotheque-Modelisme/02 Mecanique/Roulement/parametric_axial_bearing/parametric_axial_bearing.fcstd

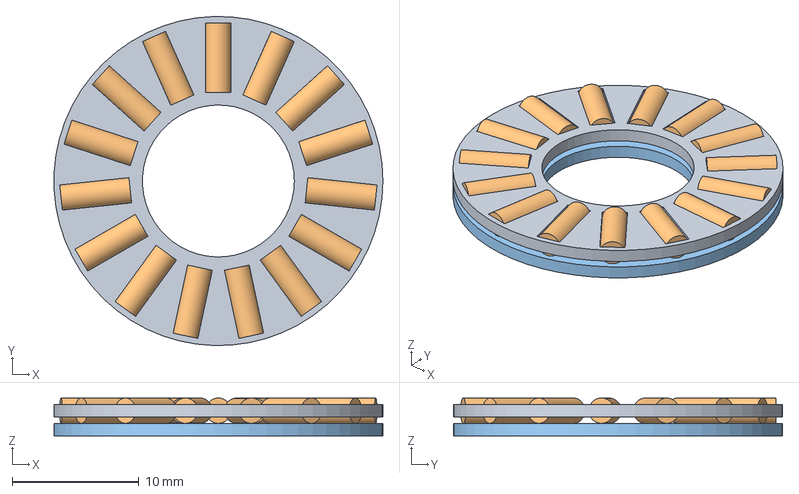
[picture p122: CAD file, 2022-01-30]
02 Mecanique/Roulement/parametric_axial_bearing/parametric_axial_bearing.fcstd
26.0 x 26.0 x 3.00 mm
BearingBody
Cylinders
BottomWasher
