ZINKTiti/30-bibliotheque-Modelisme/02 Mecanique/Roulement/parametric_ball_bearing/Parametric_Ball_Bearing.fcstd

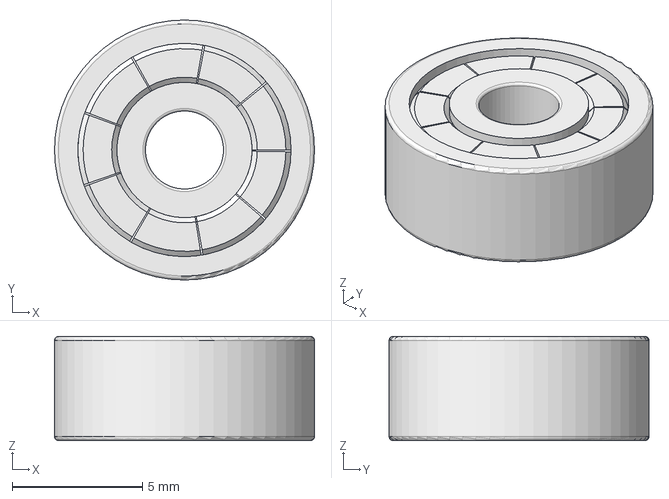
[picture p123: CAD file, 2022-01-30]
02 Mecanique/Roulement/parametric_ball_bearing/Parametric_Ball_Bearing.fcstd
10.0 x 10.0 x 4.00 mm
