ZINKTiti/30-bibliotheque-Modelisme/00 Modelisme/Accessoires/Boitier connecteur/Houder_mpx_6_polig.stl

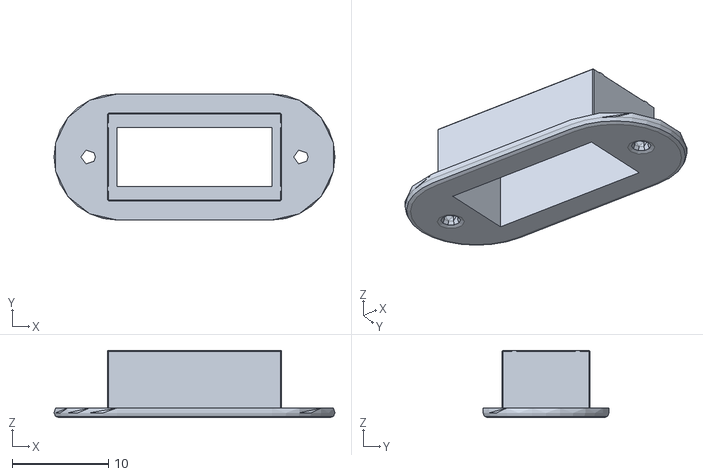
[picture p124: CAD file, 2024-11-10]
00 Modelisme/Accessoires/Boitier connecteur/Houder_mpx_6_polig.stl
29.2 x 13.1 x 7.00
