ZINKTiti/30-bibliotheque-Modelisme/00 Modelisme/Accessoires/Boitier connecteur/MPX Hochstromstecker Halter/MPX_zugentlastung.stl

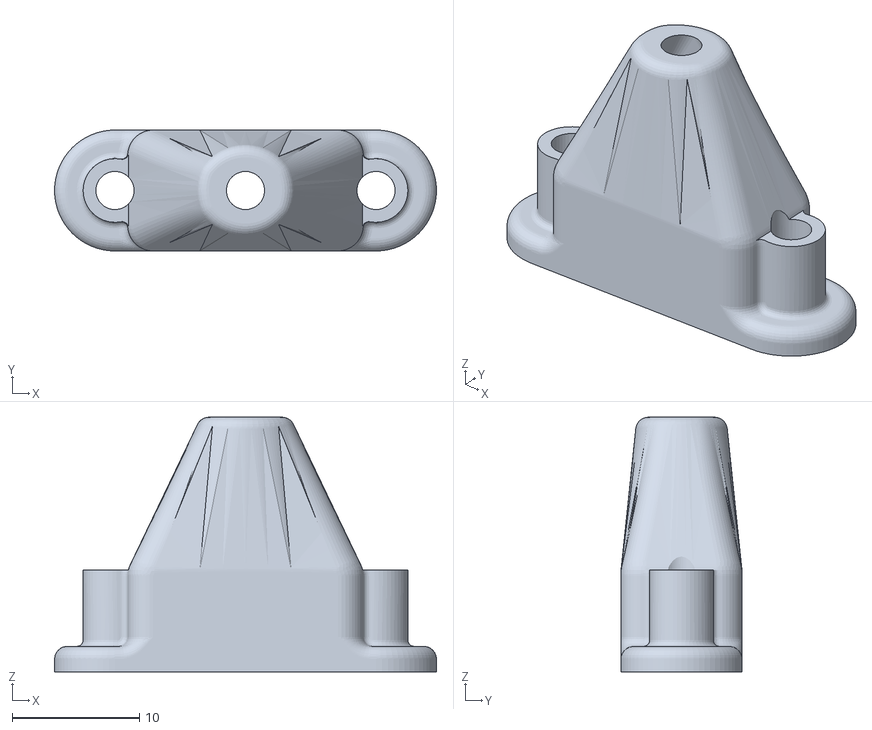
[picture p125: CAD file, 2024-11-10]
00 Modelisme/Accessoires/Boitier connecteur/MPX Hochstromstecker Halter/MPX_zugentlastung.stl
30.0 x 9.50 x 20.0
