ZINKTiti/30-bibliotheque-Modelisme/00 Modelisme/Accessoires/Connecteur/T/T-Plug male - W.S Deans Co. Est. 1957.step

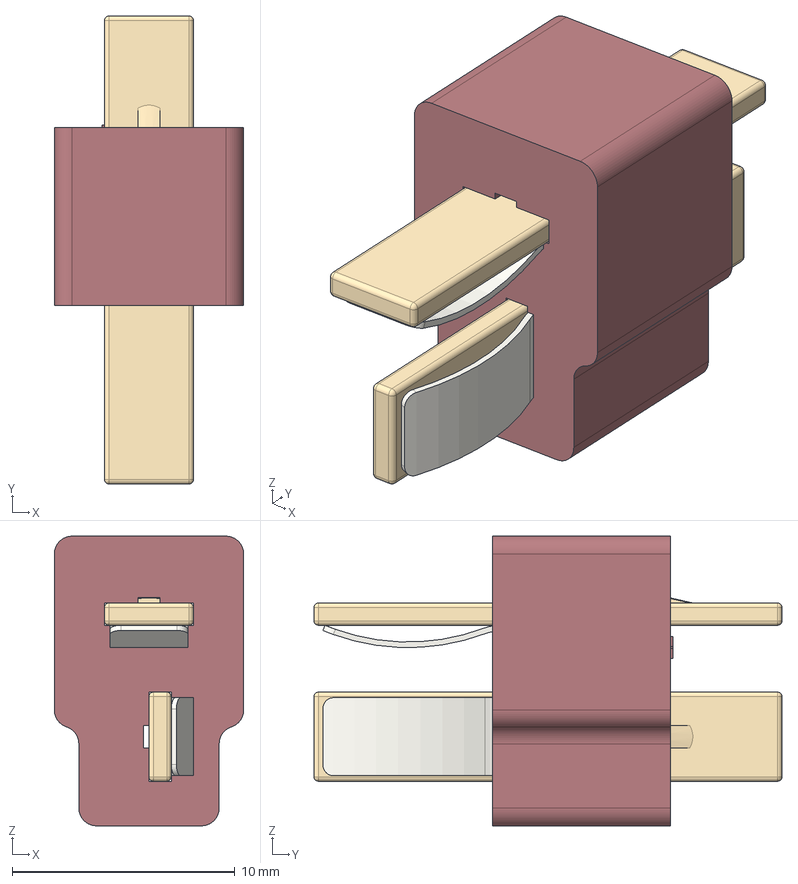
[picture p126: CAD file, 2024-11-10]
00 Modelisme/Accessoires/Connecteur/T/T-Plug male - W.S Deans Co. Est. 1957.step
8.50 x 21.0 x 13.0 mm
