ZINKTiti/30-bibliotheque-Modelisme/00 Modelisme/Accessoires/Connecteur/XT/XT30.stp

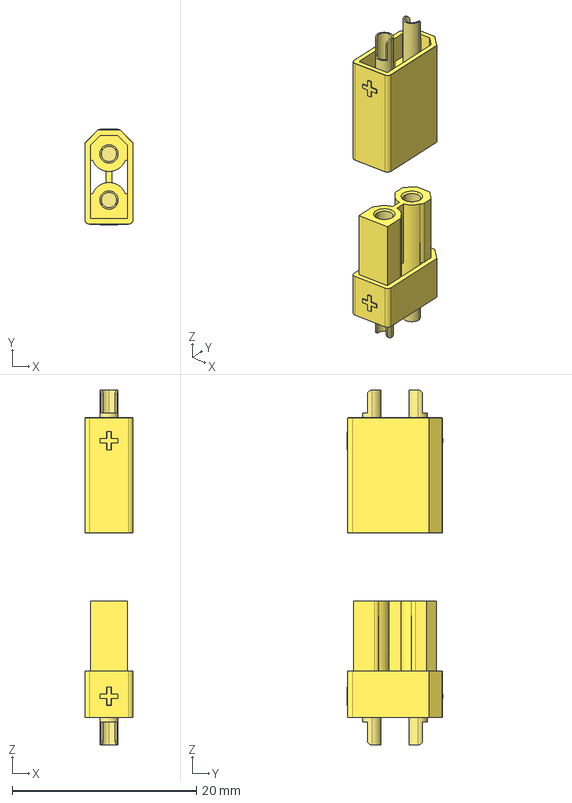
[picture p127: CAD file, 2024-11-10]
00 Modelisme/Accessoires/Connecteur/XT/XT30.stp
5.25 x 10.4 x 38.5 mm
