ZINKTiti/30-bibliotheque-Modelisme/00 Modelisme/Moteur/Bruchless/Axi/AXI2814-20.STEP

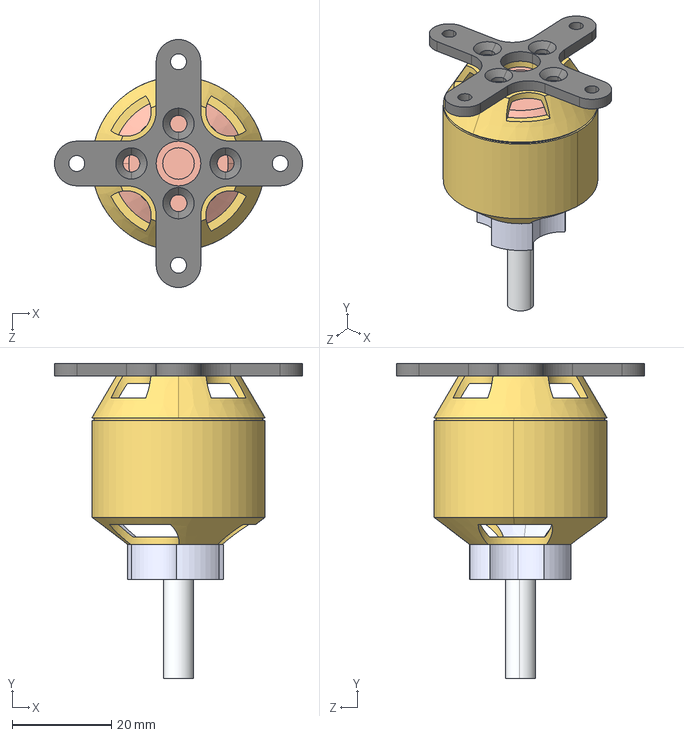
[picture p128: CAD file, 2022-01-30]
00 Modelisme/Moteur/Bruchless/Axi/AXI2814-20.STEP
50.0 x 63.5 x 50.0 mm
AXI2814-20-base_Valor predeterminado
AXI2814-20-rotor^AXI2814-20_Valor predeterminado
