ZINKTiti/30-bibliotheque-Modelisme/00 Modelisme/Moteur/Bruchless/Hacker/A50/HACKER A50-14L V4.STEP

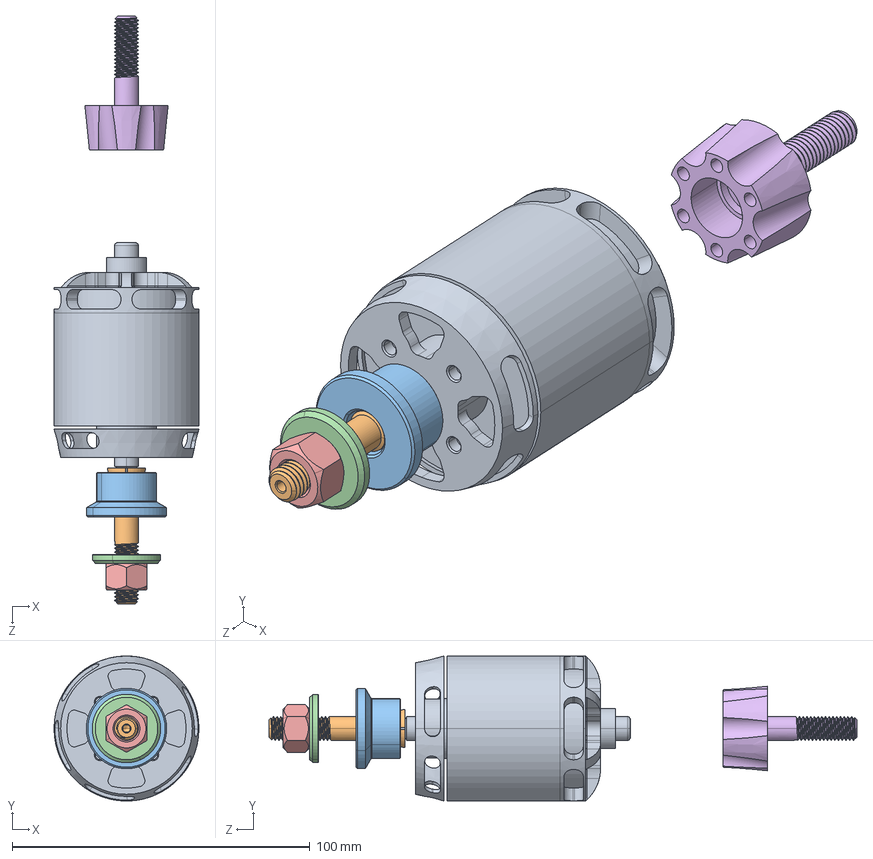
[picture p129: CAD file, 2024-11-10]
00 Modelisme/Moteur/Bruchless/Hacker/A50/HACKER A50-14L V4.STEP
48.7 x 48.7 x 197.3 mm
HACKER A50-14L V4
Collet
Washer for collet
Washer
Nut
Prop adapter for rear mounting
