ZINKTiti/30-bibliotheque-Modelisme/00 Modelisme/Moteur/Bruchless/Multistar 4822-390.STEP

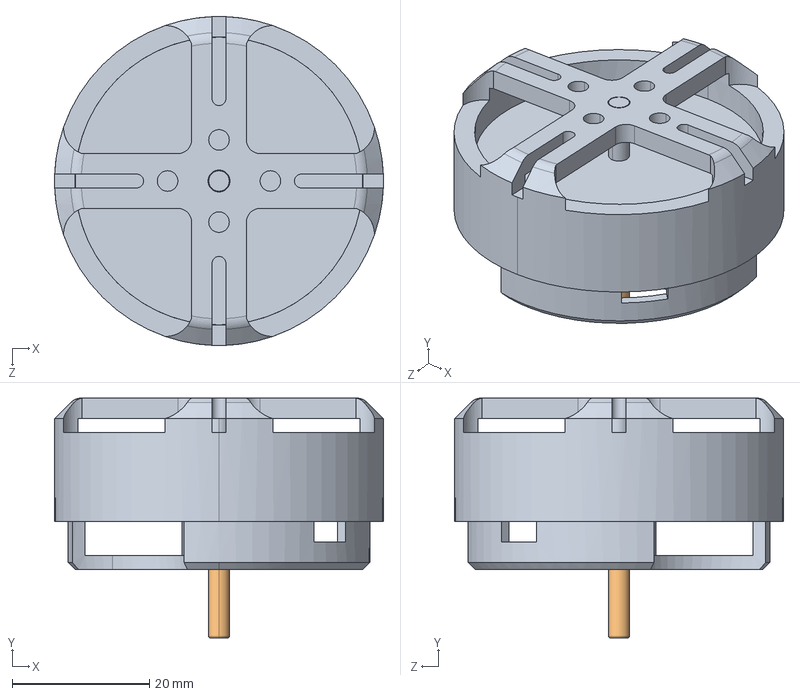
[picture p130: CAD file, 2022-11-20]
00 Modelisme/Moteur/Bruchless/Multistar 4822-390.STEP
48.0 x 35.0 x 48.0 mm
