ZINKTiti/30-bibliotheque-Modelisme/00 Modelisme/Moteur/Bruchless/Turnigy/Turnigy Aerodrive 1050kv Brushless Outrunner Motor.STEP

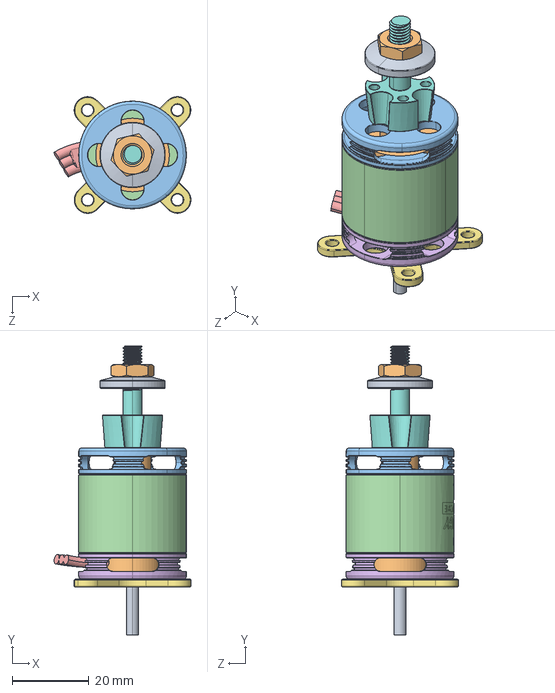
[picture p131: CAD file, 2024-11-10]
00 Modelisme/Moteur/Bruchless/Turnigy/Turnigy Aerodrive 1050kv Brushless Outrunner Motor.STEP
35.6 x 75.2 x 30.3 mm
