ZINKTiti/30-bibliotheque-Modelisme/00 Modelisme/Servos/Futaba/FSH-6W.step

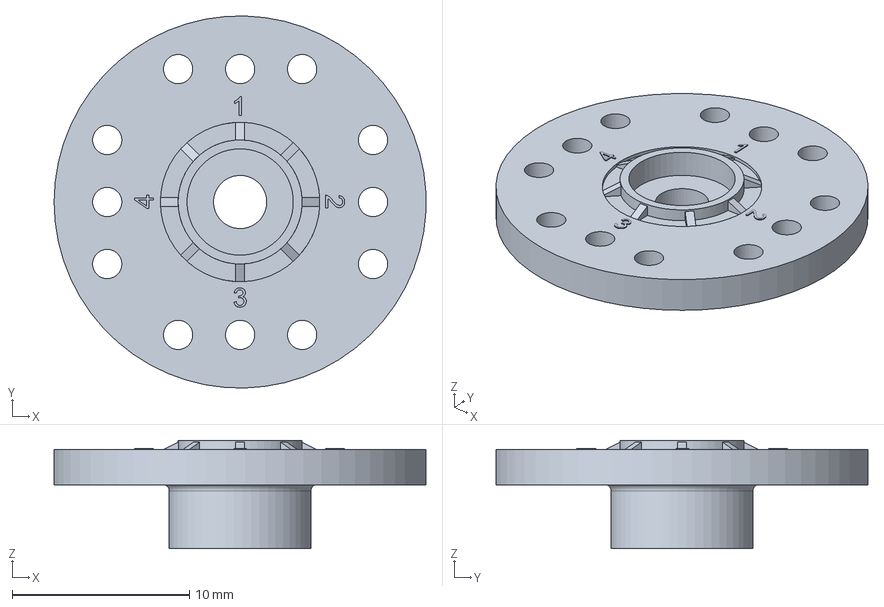
[picture p132: CAD file, 2022-01-30]
00 Modelisme/Servos/Futaba/FSH-6W.step
21.0 x 21.0 x 6.10 mm
