ZINKTiti/30-bibliotheque-Modelisme/00 Modelisme/Servos/Futaba/Futaba3003/Futaba3003-rounded-horn.stp

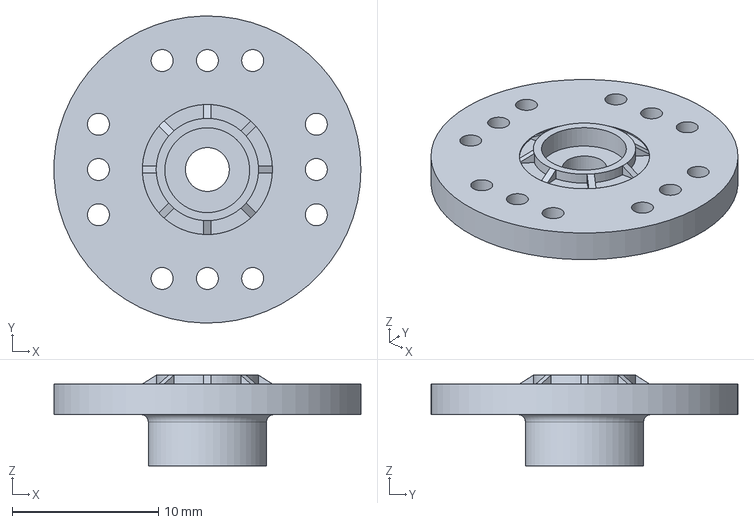
[picture p133: CAD file, 2022-01-30]
00 Modelisme/Servos/Futaba/Futaba3003/Futaba3003-rounded-horn.stp
21.0 x 21.0 x 6.20 mm
