ZINKTiti/30-bibliotheque-Modelisme/00 Modelisme/Servos/Goteck/DA2312T.stp

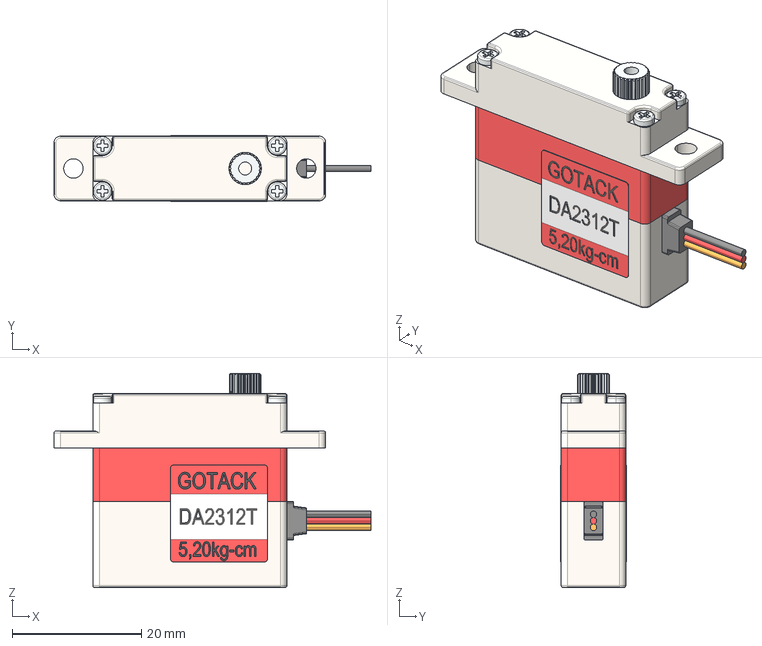
[picture p134: CAD file, 2022-01-30]
00 Modelisme/Servos/Goteck/DA2312T.stp
49.0 x 10.2 x 33.1 mm
