ZINKTiti/30-bibliotheque-Modelisme/00 Modelisme/Servos/Hitec/HS-5585MH.stp

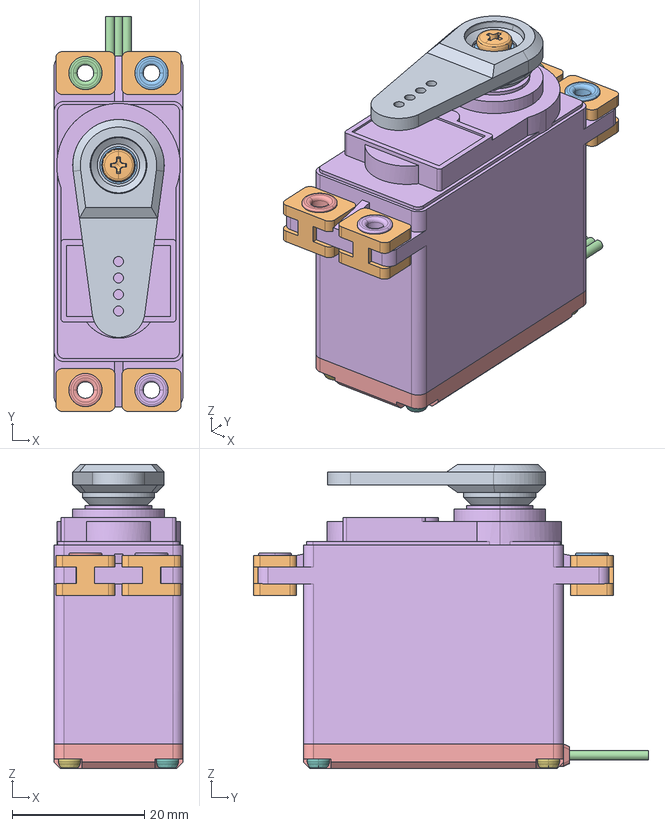
[picture p135: CAD file, 2022-01-30]
00 Modelisme/Servos/Hitec/HS-5585MH.stp
19.5 x 59.8 x 46.1 mm
