ZINKTiti/30-bibliotheque-Modelisme/00 Modelisme/Servos/Inconnu/Emax-ES08A/servo-rounded-horn.step

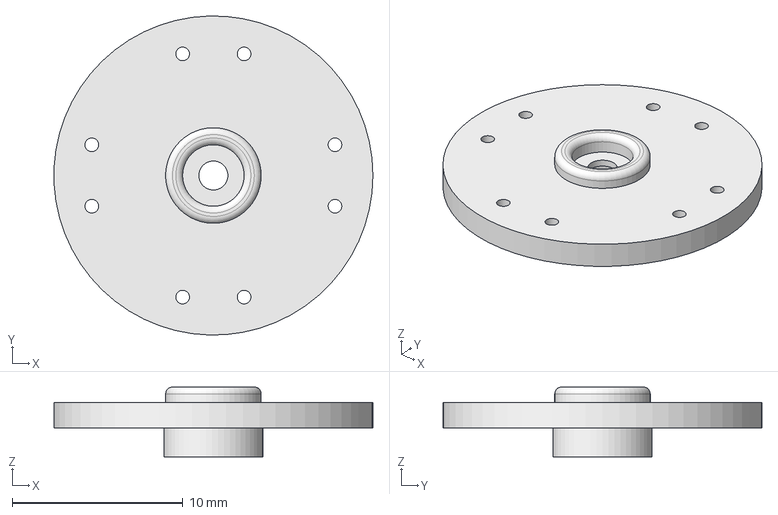
[picture p136: CAD file, 2022-01-30]
00 Modelisme/Servos/Inconnu/Emax-ES08A/servo-rounded-horn.step
18.7 x 18.7 x 4.10 mm
