ZINKTiti/30-bibliotheque-Modelisme/00 Modelisme/Servos/Inconnu/SG-90/SG90-4-arms-horn.step

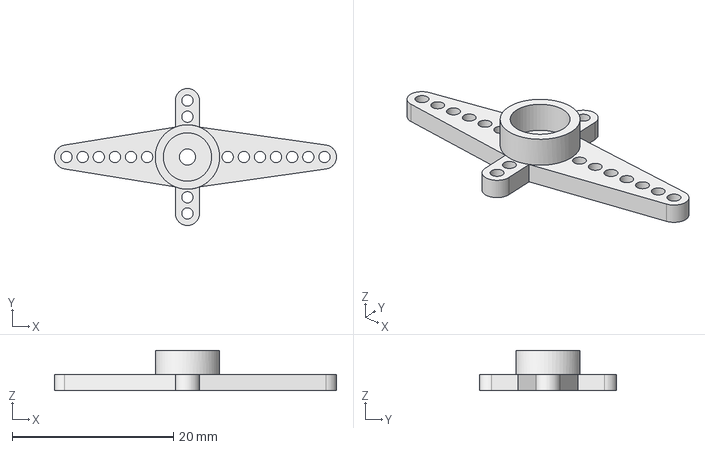
[picture p137: CAD file, 2022-01-30]
00 Modelisme/Servos/Inconnu/SG-90/SG90-4-arms-horn.step
35.0 x 17.0 x 5.00 mm
