ZINKTiti/30-bibliotheque-Modelisme/00 Modelisme/Servos/Inconnu/SpringRC-SM-S4303R/SM-S4303R-4-arms-horn.stp

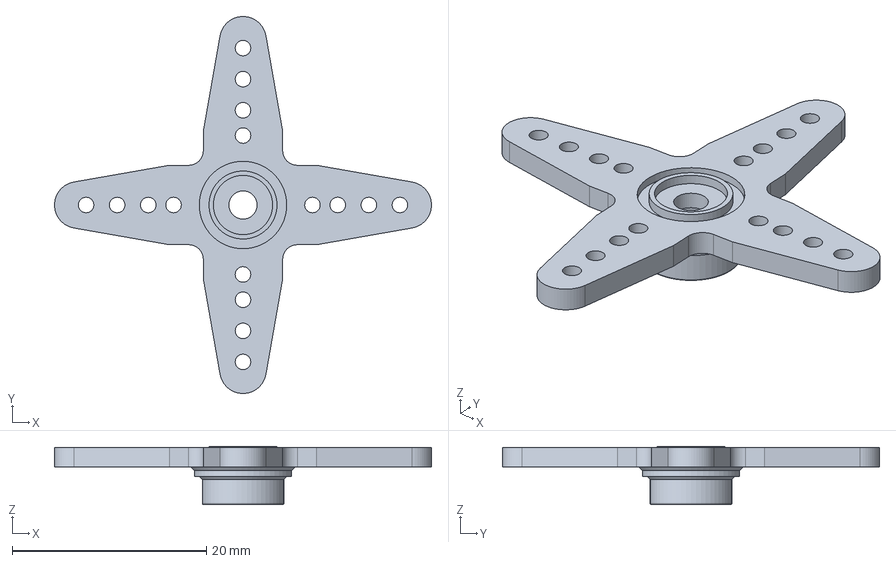
[picture p138: CAD file, 2022-01-30]
00 Modelisme/Servos/Inconnu/SpringRC-SM-S4303R/SM-S4303R-4-arms-horn.stp
38.8 x 38.8 x 6.00 mm
