ZINKTiti/30-bibliotheque-Modelisme/00 Modelisme/Servos/KST/KST DS135MG.stp

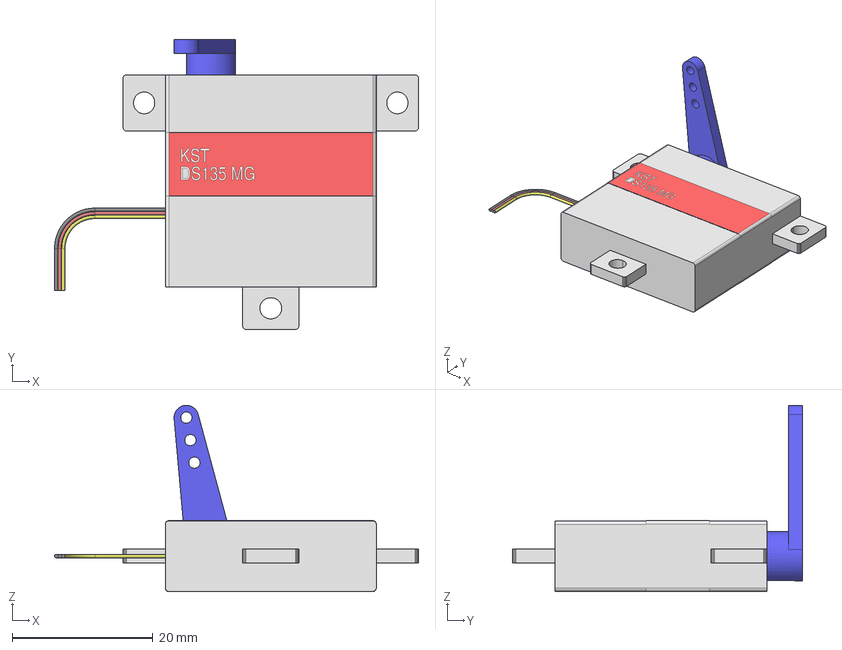
[picture p139: CAD file, 2022-01-30]
00 Modelisme/Servos/KST/KST DS135MG.stp
51.8 x 41.2 x 26.5 mm
