ZINKTiti/30-bibliotheque-Modelisme/00 Modelisme/Servos/Savox/SH-1250MG.stp

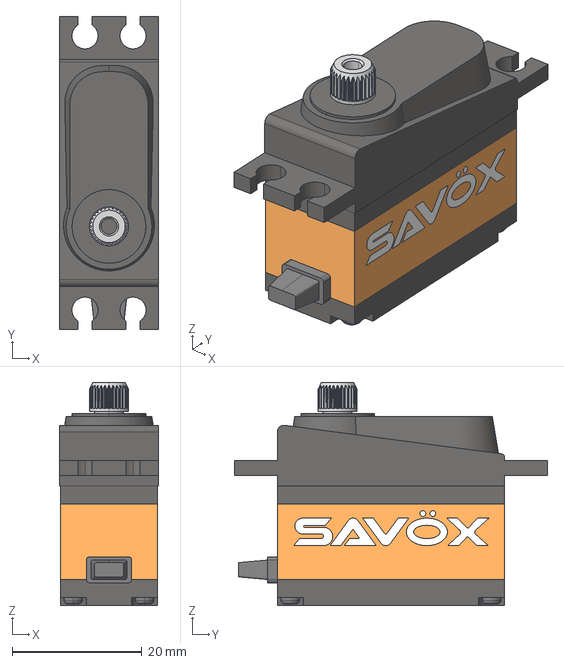
[picture p140: CAD file, 2022-01-30]
00 Modelisme/Servos/Savox/SH-1250MG.stp
15.2 x 48.2 x 34.4 mm
