ZINKTiti/30-bibliotheque-Modelisme/00 Modelisme/Servos/SERVO PARAMETRIQUE.FCStd

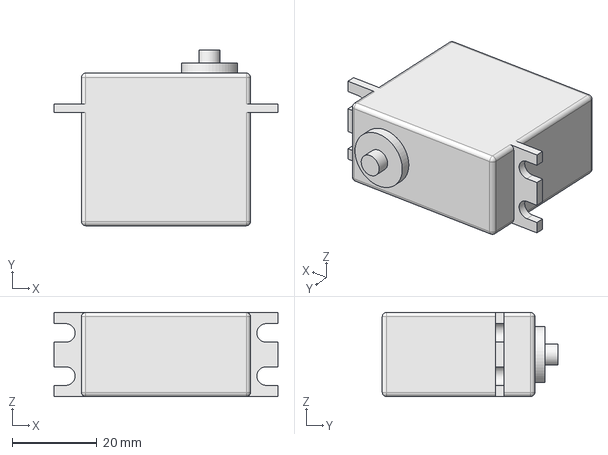
[picture p141: CAD file, 2022-11-20]
00 Modelisme/Servos/SERVO PARAMETRIQUE.FCStd
52.8 x 41.4 x 19.8 mm
