ZINKTiti/30-bibliotheque-Modelisme/00 Modelisme/Servos/Turnigy/TGY-S901D.STEP

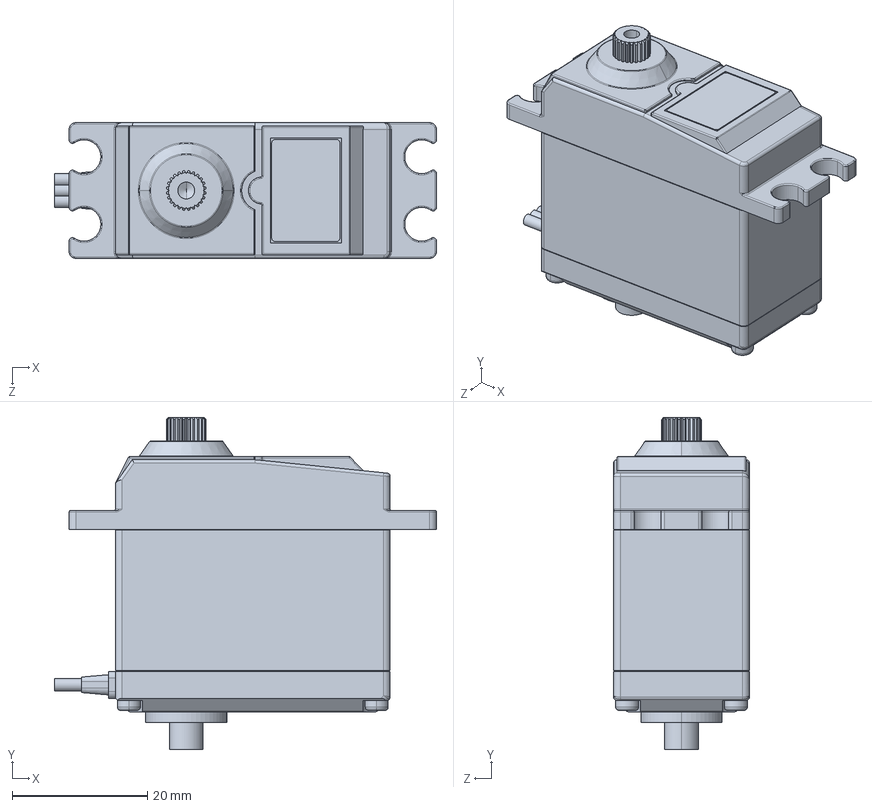
[picture p142: CAD file, 2022-01-30]
00 Modelisme/Servos/Turnigy/TGY-S901D.STEP
56.6 x 49.2 x 20.1 mm
