ZINKTiti/30-bibliotheque-Modelisme/01 Electronique/Arduino/COMMON SHIELDS/WaveShareSD.fcstd

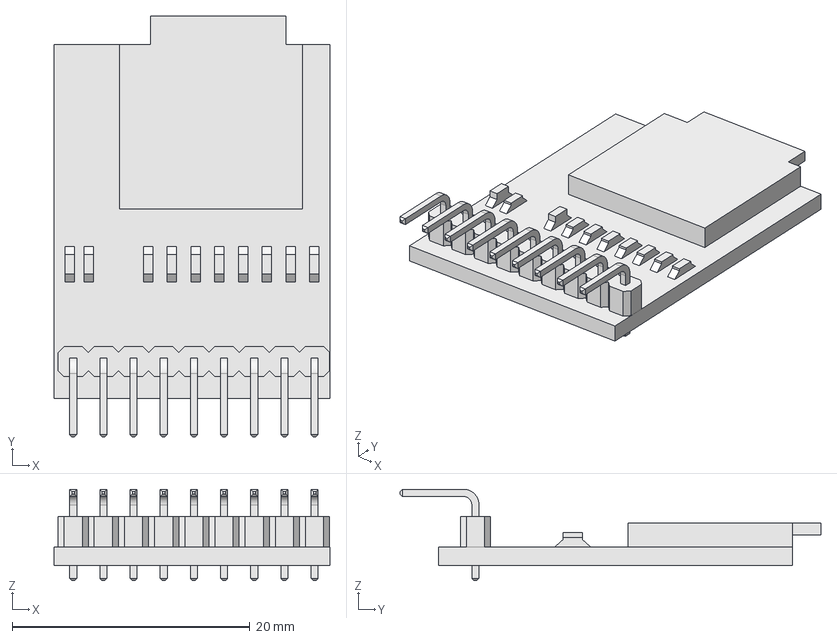
[picture p143: CAD file, 2022-01-30]
01 Electronique/Arduino/COMMON SHIELDS/WaveShareSD.fcstd
23.2 x 35.4 x 7.69 mm
