ZINKTiti/30-bibliotheque-Modelisme/01 Electronique/Arduino/MEGA/SHIELDS/ramps-1.4.fcstd

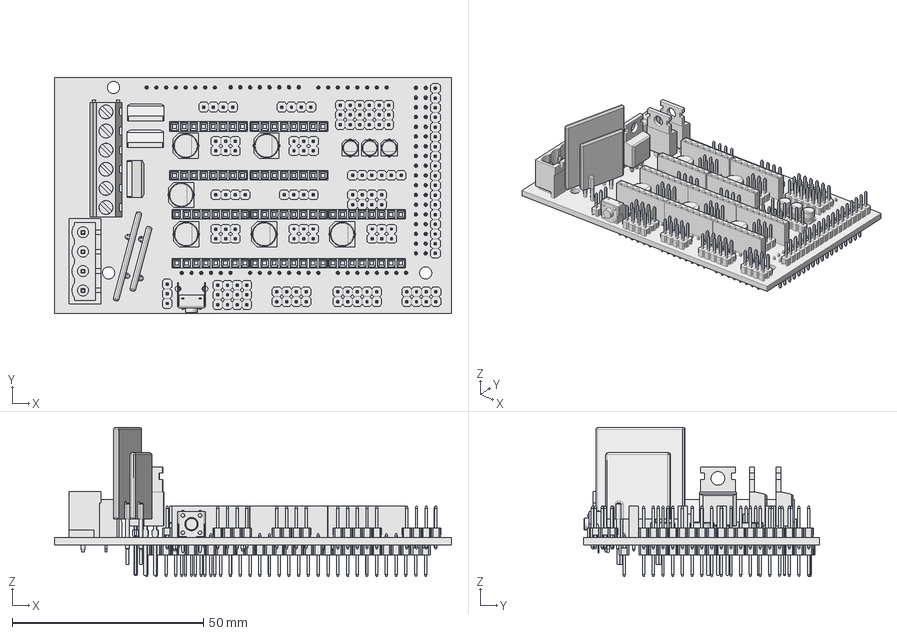
[picture p144: CAD file, 2022-01-30]
01 Electronique/Arduino/MEGA/SHIELDS/ramps-1.4.fcstd
103.9 x 61.8 x 39.0 mm
