ZINKTiti/30-bibliotheque-Modelisme/01 Electronique/dupont-connectors/dupont-2_54mm-female-conn-1x1.step

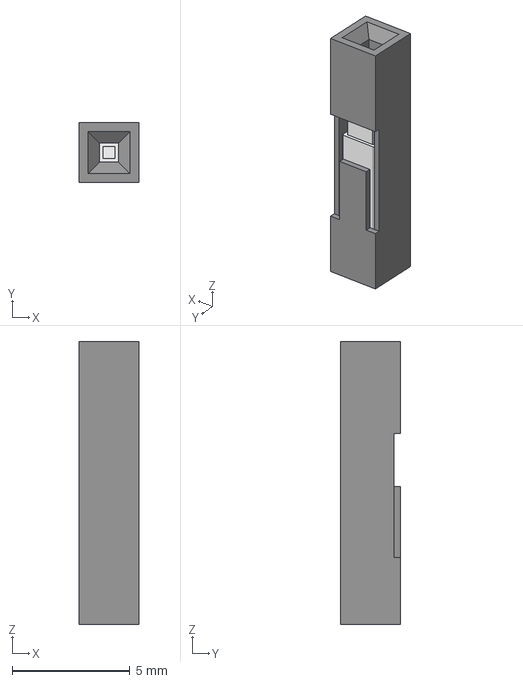
[picture p145: CAD file, 2022-01-30]
01 Electronique/dupont-connectors/dupont-2_54mm-female-conn-1x1.step
2.54 x 2.54 x 12.0 mm
Case
Pins
