ZINKTiti/30-bibliotheque-Modelisme/01 Electronique/fans/4010_DC-Fan.step

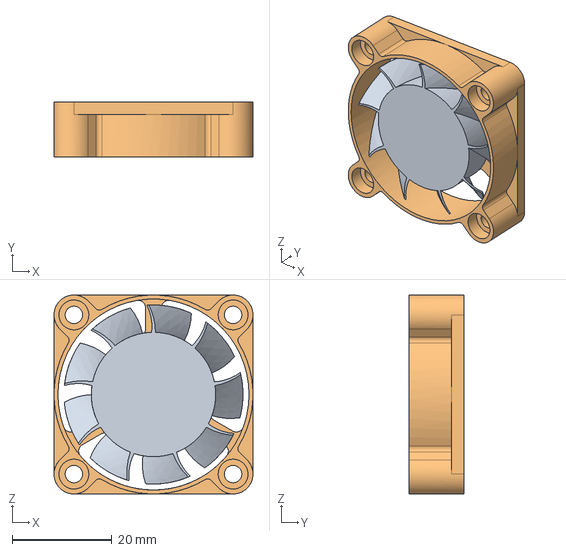
[picture p146: CAD file, 2022-01-30]
01 Electronique/fans/4010_DC-Fan.step
40.0 x 11.0 x 40.0 mm
