ZINKTiti/30-bibliotheque-Modelisme/01 Electronique/Fin de course/endstop.stp

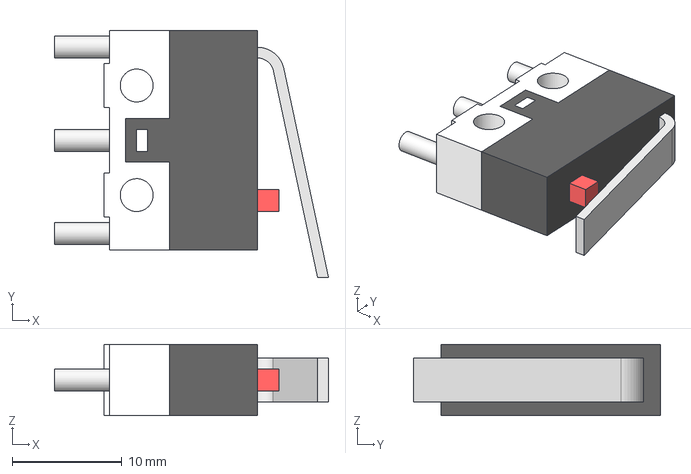
[picture p147: CAD file, 2022-01-30]
01 Electronique/Fin de course/endstop.stp
25.0 x 22.5 x 6.50 mm
