ZINKTiti/30-bibliotheque-Modelisme/01 Electronique/Fin de course/Fin de course rouge/Endstop2.stp

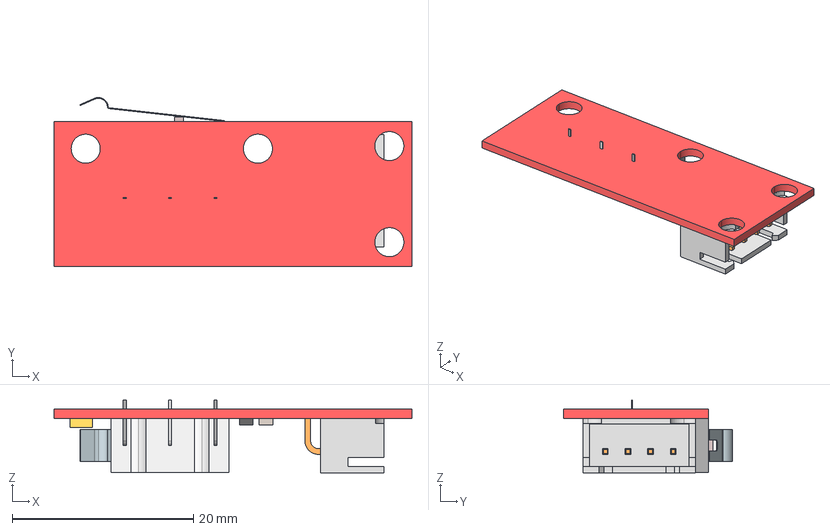
[picture p148: CAD file, 2022-01-30]
01 Electronique/Fin de course/Fin de course rouge/Endstop2.stp
39.5 x 18.6 x 8.02 mm
PCB Geometry
PCB^Endstop
Microswitch_1A_125vAC(seul)
JST 4Pin
