ZINKTiti/30-bibliotheque-Modelisme/01 Electronique/LCD/OLED_13_128_64_I2C_no_pins.stl

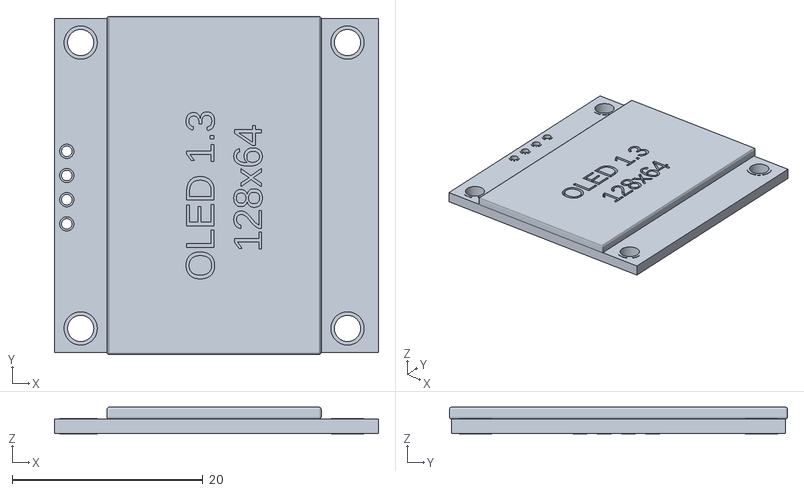
[picture p150: CAD file, 2022-01-30]
01 Electronique/LCD/OLED_13_128_64_I2C_no_pins.stl
34.0 x 35.5 x 2.80
