ZINKTiti/30-bibliotheque-Modelisme/02 Mecanique/Insert Ruthex/RX-M8x12.7.step

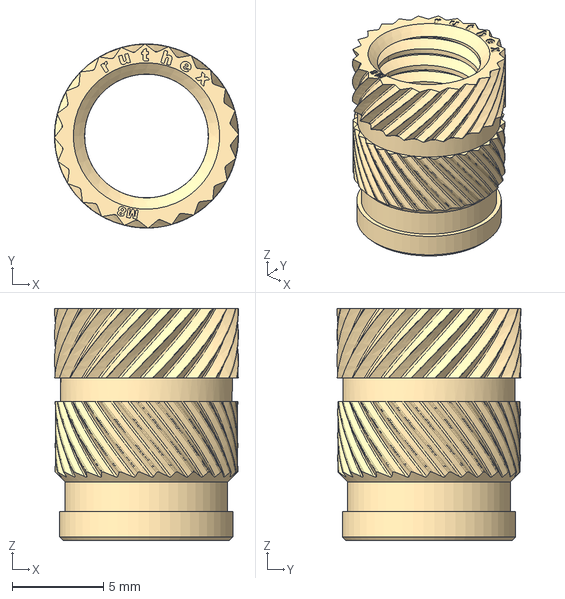
[picture p151: CAD file, 2022-02-15]
02 Mecanique/Insert Ruthex/RX-M8x12.7.step
10.1 x 10.1 x 12.7 mm
