ZINKTiti/30-bibliotheque-Modelisme/02 Mecanique/Profiles EN/BOSCH/Profile Bosh 40x40mm.FCStd

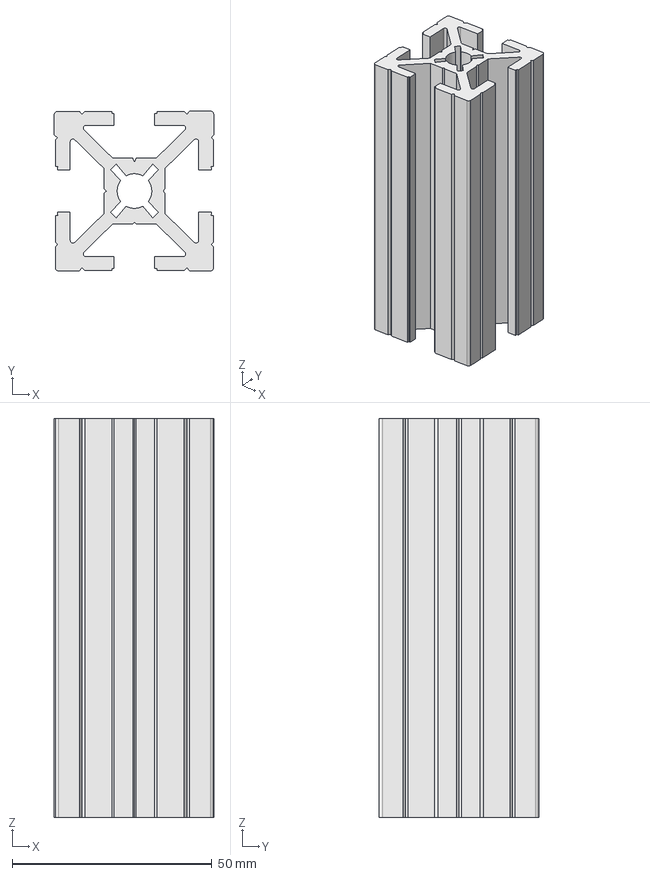
[picture p152: CAD file, 2022-01-30]
02 Mecanique/Profiles EN/BOSCH/Profile Bosh 40x40mm.FCStd
40.0 x 40.0 x 100.0 mm
