ZINKTiti/30-bibliotheque-Modelisme/02 Mecanique/Profiles EN/EN10056 Equal Angle Bars/Angle Bar L120x120x8 EN10056 S235JR.step

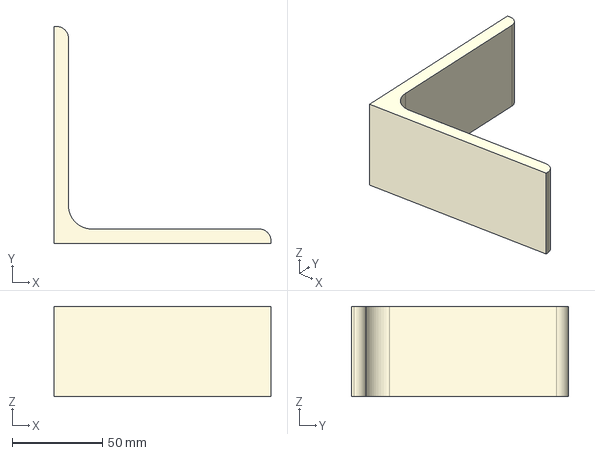
[picture p153: CAD file, 2022-01-30]
02 Mecanique/Profiles EN/EN10056 Equal Angle Bars/Angle Bar L120x120x8 EN10056 S235JR.step
120.0 x 120.0 x 50.0 mm
