ZINKTiti/30-bibliotheque-Modelisme/02 Mecanique/Profiles EN/EN10058 Flat steel bars/Flat Bar 110x6 EN10058 S235JR.step

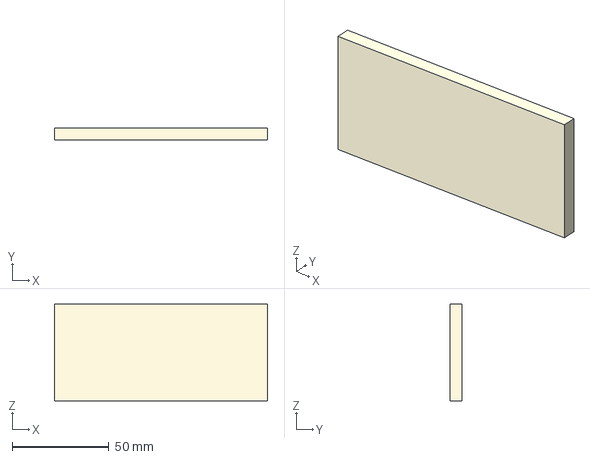
[picture p154: CAD file, 2022-01-30]
02 Mecanique/Profiles EN/EN10058 Flat steel bars/Flat Bar 110x6 EN10058 S235JR.step
110.0 x 6.00 x 50.0 mm
