ZINKTiti/30-bibliotheque-Modelisme/02 Mecanique/Profiles EN/EN10060 Round steel bars/Round Bar 125 EN10060 S235JR.step

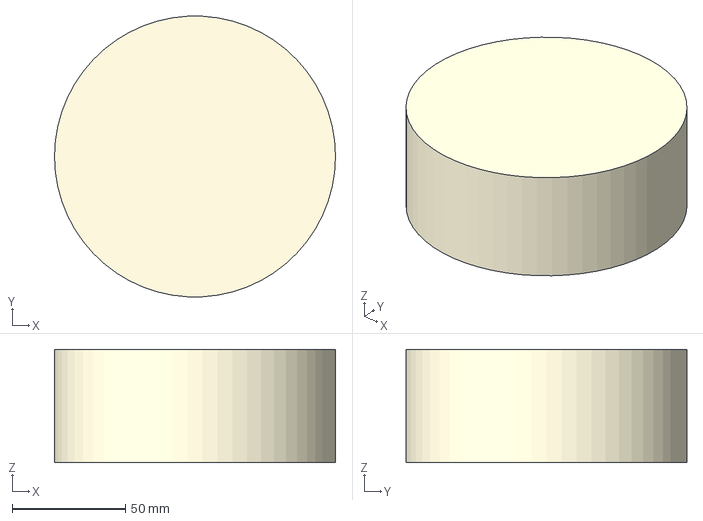
[picture p155: CAD file, 2022-01-30]
02 Mecanique/Profiles EN/EN10060 Round steel bars/Round Bar 125 EN10060 S235JR.step
124.0 x 123.8 x 50.0 mm
