ZINKTiti/30-bibliotheque-Modelisme/02 Mecanique/Profiles EN/EN10219 Rectangular Hollow Sections/Rectangular hollow section 250x150x6 EN10219 S235JRH.step

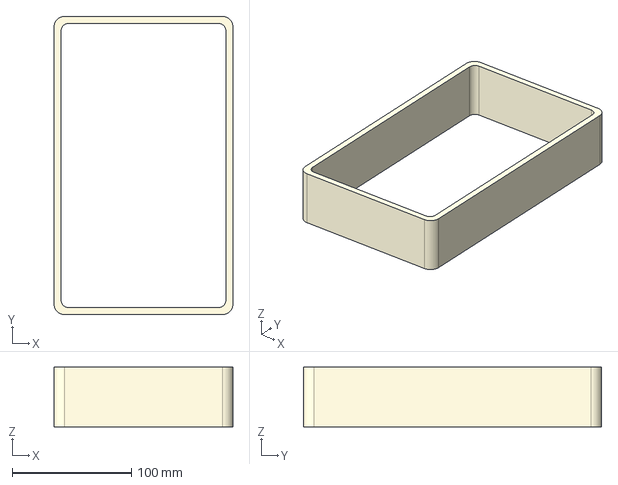
[picture p156: CAD file, 2022-01-30]
02 Mecanique/Profiles EN/EN10219 Rectangular Hollow Sections/Rectangular hollow section 250x150x6 EN10219 S235JRH.step
150.0 x 250.0 x 50.0 mm
