ZINKTiti/30-bibliotheque-Modelisme/02 Mecanique/Profiles EN/EN10219 Square Hollow Sections/Square hollow section 400x400x12.5 EN10219 S235JRH.step

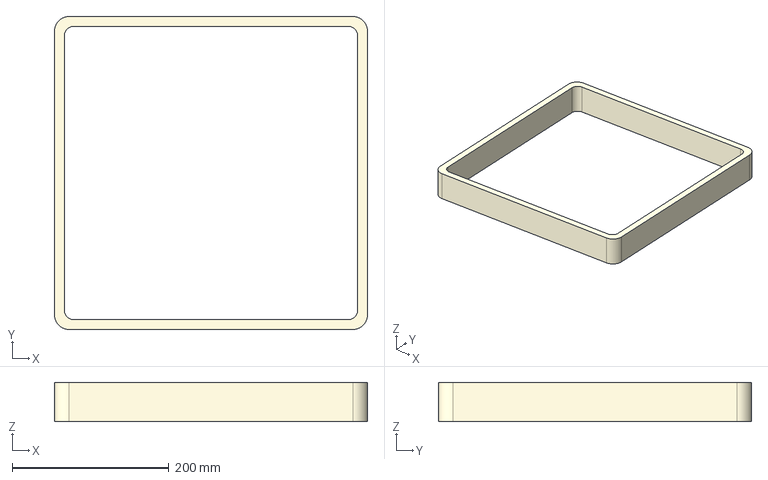
[picture p157: CAD file, 2022-01-30]
02 Mecanique/Profiles EN/EN10219 Square Hollow Sections/Square hollow section 400x400x12.5 EN10219 S235JRH.step
400.0 x 400.0 x 50.0 mm
