ZINKTiti/30-bibliotheque-Modelisme/02 Mecanique/Profiles EN/Motedis/Profile-30x60-B-Type_Slot8.step

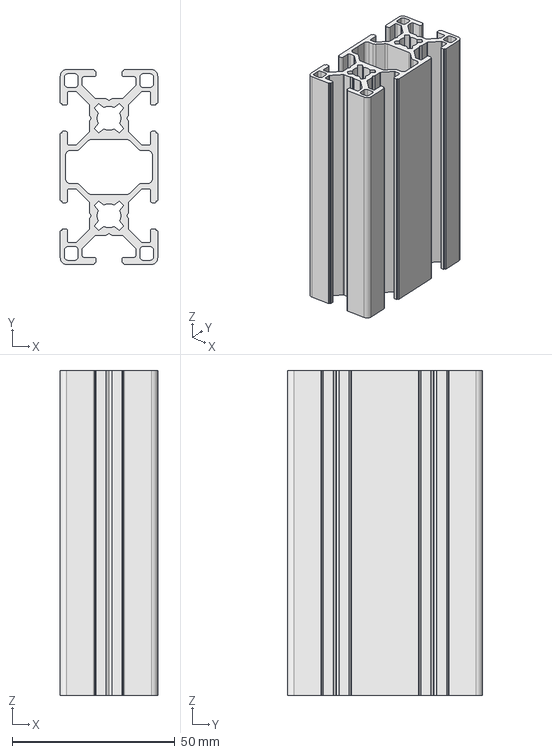
[picture p158: CAD file, 2022-01-30]
02 Mecanique/Profiles EN/Motedis/Profile-30x60-B-Type_Slot8.step
30.0 x 60.0 x 100.0 mm
