ZINKTiti/30-bibliotheque-Modelisme/02 Mecanique/Profiles EN/Sigma profiles/45x45 mm .fcstd

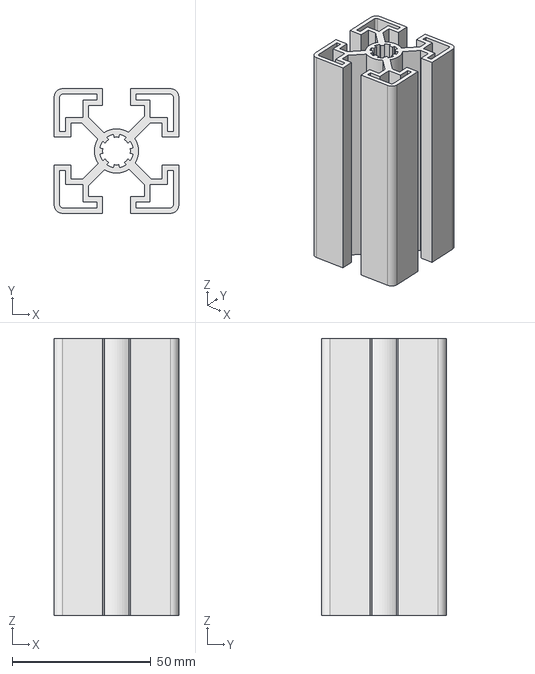
[picture p159: CAD file, 2022-01-30]
02 Mecanique/Profiles EN/Sigma profiles/45x45 mm .fcstd
45.0 x 45.0 x 100.0 mm
