ZINKTiti/30-bibliotheque-Modelisme/02 Mecanique/Profiles EN/VSlot/Vslot 2040 Parametrique.FCStd

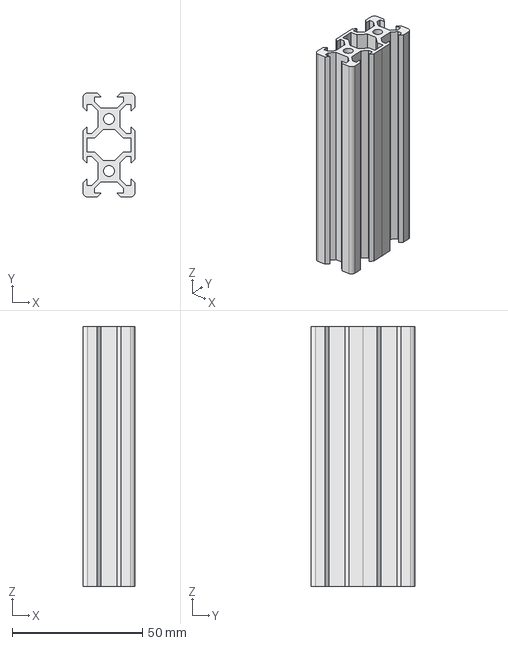
[picture p160: CAD file, 2022-02-01]
02 Mecanique/Profiles EN/VSlot/Vslot 2040 Parametrique.FCStd
20.0 x 40.0 x 100.0 mm
