ZINKTiti/30-bibliotheque-Modelisme/02 Mecanique/Roulement/LM12uu.step

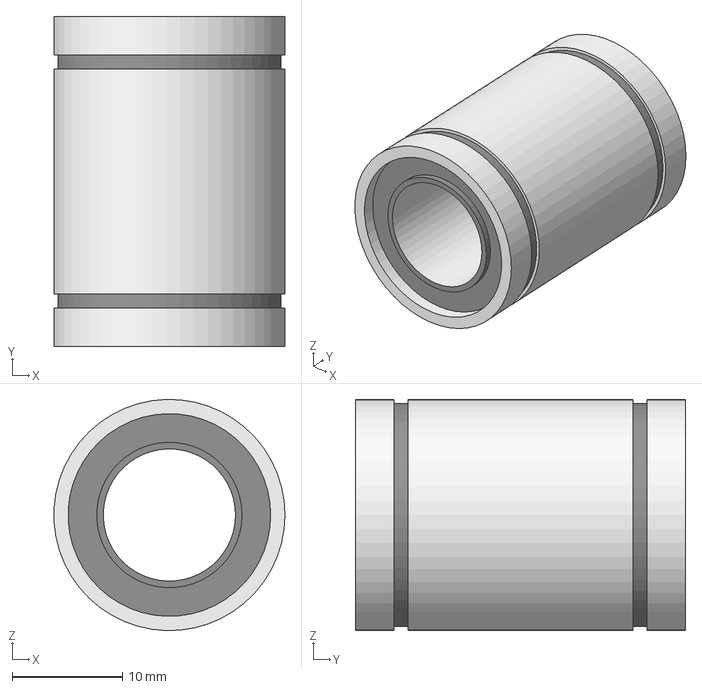
[picture p161: CAD file, 2022-01-30]
02 Mecanique/Roulement/LM12uu.step
21.0 x 30.0 x 21.0 mm
