ZINKTiti/30-bibliotheque-Modelisme/00 Modelisme/Accessoires/Boitier connecteur/connecteur_JR_double_superpose.stl

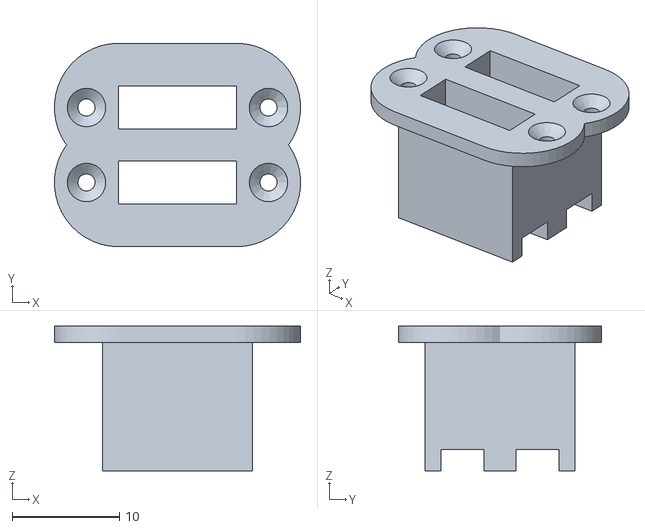
[picture p162: CAD file, 2024-11-10]
00 Modelisme/Accessoires/Boitier connecteur/connecteur_JR_double_superpose.stl
23.0 x 19.0 x 13.5
