ZINKTiti/30-bibliotheque-Modelisme/00 Modelisme/Accessoires/Connecteur/XT/XT60H-F.STEP

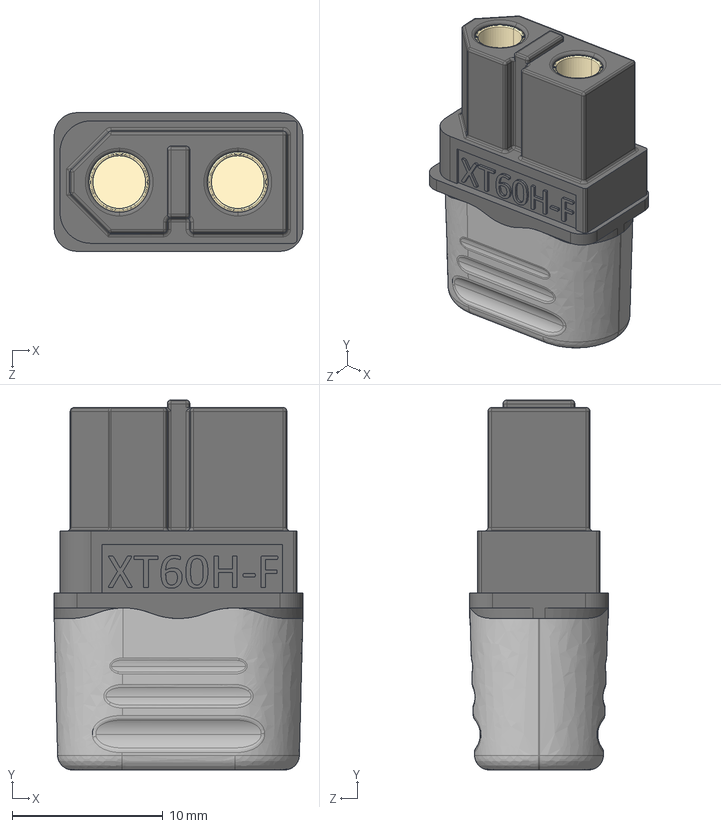
[picture p163: CAD file, 2024-11-10]
00 Modelisme/Accessoires/Connecteur/XT/XT60H-F.STEP
16.5 x 24.5 x 9.20 mm
