ZINKTiti/30-bibliotheque-Modelisme/00 Modelisme/Moteur/Bruchless/Axi/AXI 5325-24.STEP

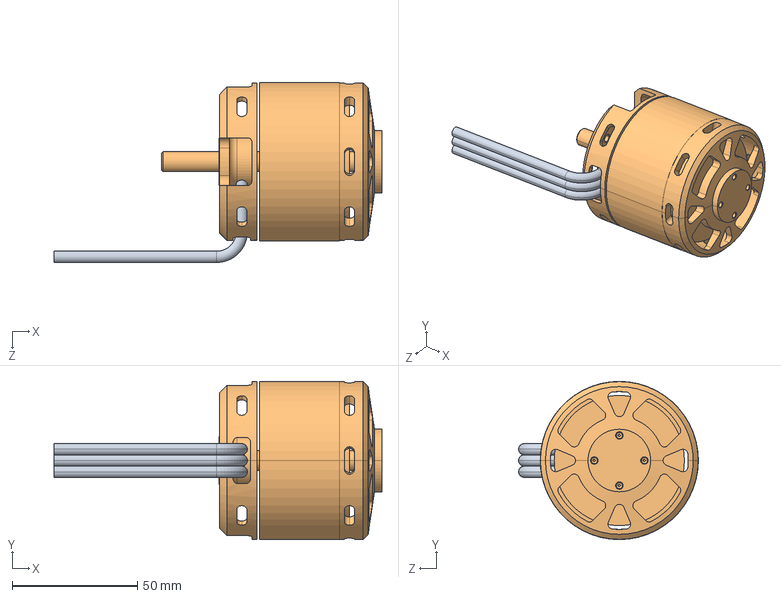
[picture p164: CAD file, 2022-01-30]
00 Modelisme/Moteur/Bruchless/Axi/AXI 5325-24.STEP
131.0 x 63.2 x 71.9 mm
