ZINKTiti/30-bibliotheque-Modelisme/00 Modelisme/Moteur/Bruchless/Turnigy/Turnigy D3530_14.STEP

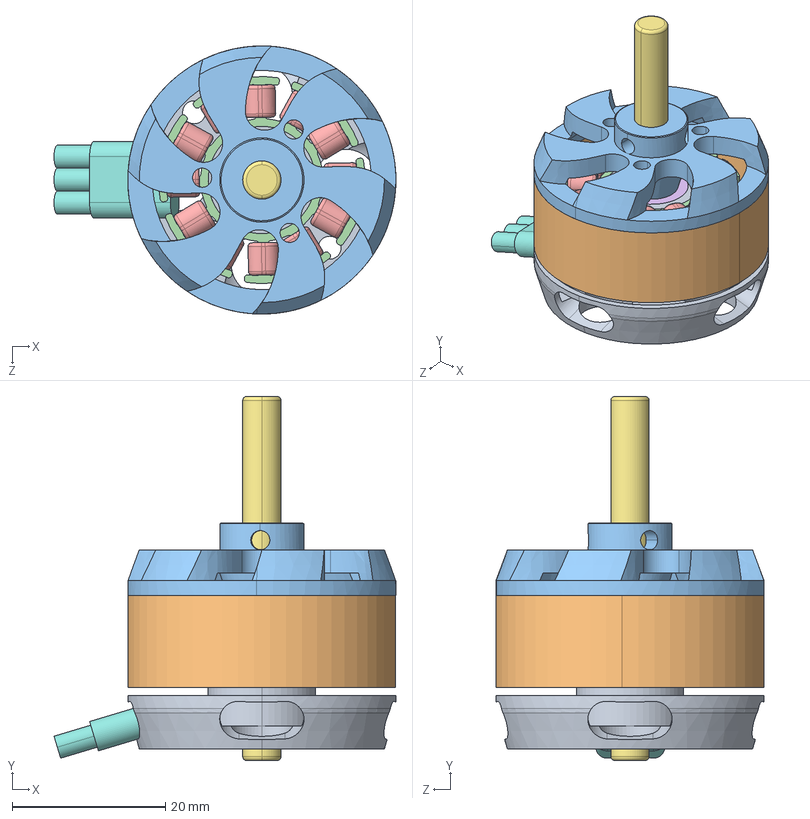
[picture p165: CAD file, 2022-11-20]
00 Modelisme/Moteur/Bruchless/Turnigy/Turnigy D3530_14.STEP
44.6 x 47.5 x 35.0 mm
Bottom Shell
Middle Shell
Top Shell
Inner Coil Rack
Coil x 12
Inner Bearing
Shaft
Wires
