ZINKTiti/30-bibliotheque-Modelisme/00 Modelisme/Servos/Futaba/FUTABA_HPSCB700_FSH6W v2.step

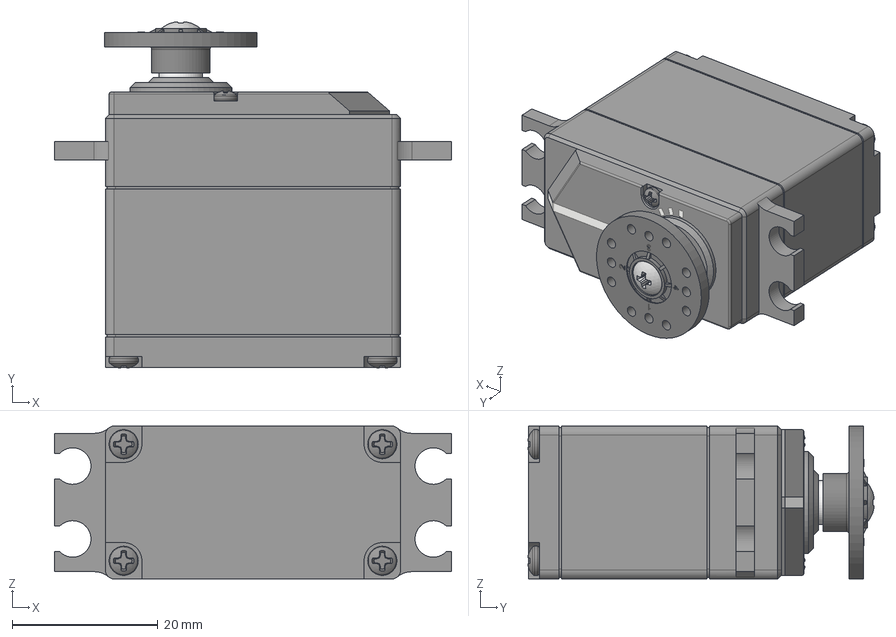
[picture p166: CAD file, 2022-01-30]
00 Modelisme/Servos/Futaba/FUTABA_HPSCB700_FSH6W v2.step
54.5 x 47.6 x 21.0 mm
92000A012 x 4
95836A511 x 2
92000A076
FSH-6W
