ZINKTiti/30-bibliotheque-Modelisme/00 Modelisme/Servos/Goteck/DA2322T.stp

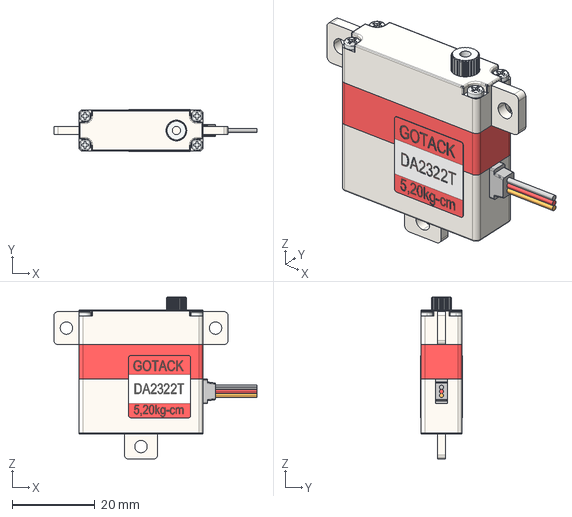
[picture p167: CAD file, 2022-01-30]
00 Modelisme/Servos/Goteck/DA2322T.stp
49.0 x 10.2 x 39.1 mm
