ZINKTiti/30-bibliotheque-Modelisme/00 Modelisme/Servos/Hitec/HS-7980TH.STEP

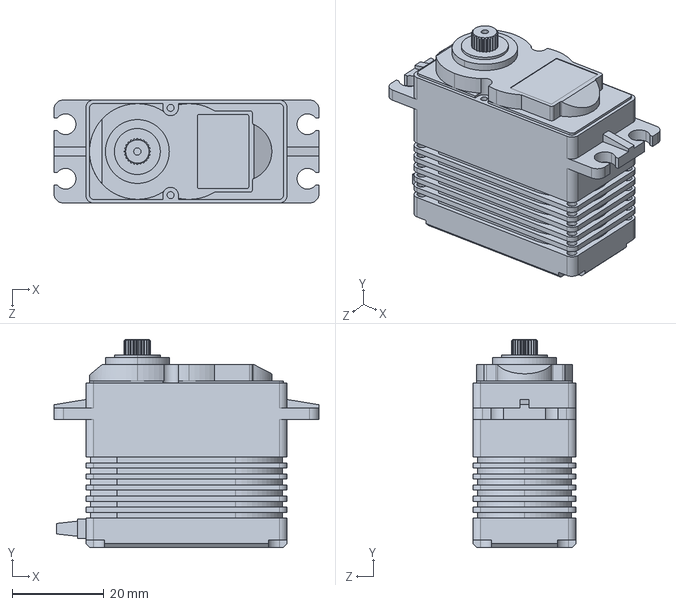
[picture p168: CAD file, 2022-01-30]
00 Modelisme/Servos/Hitec/HS-7980TH.STEP
57.7 x 45.4 x 22.4 mm
