ZINKTiti/30-bibliotheque-Modelisme/00 Modelisme/Servos/Inconnu/SG-90/Servo-sg90.step

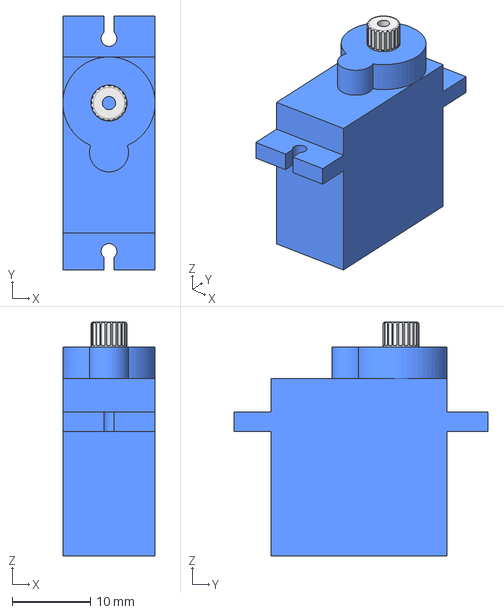
[picture p169: CAD file, 2022-01-30]
00 Modelisme/Servos/Inconnu/SG-90/Servo-sg90.step
11.8 x 32.4 x 29.9 mm
