ZINKTiti/30-bibliotheque-Modelisme/00 Modelisme/Servos/Inconnu/SpringRC-SM-S4303R/SM-S4303R-6-arms-horn.stp

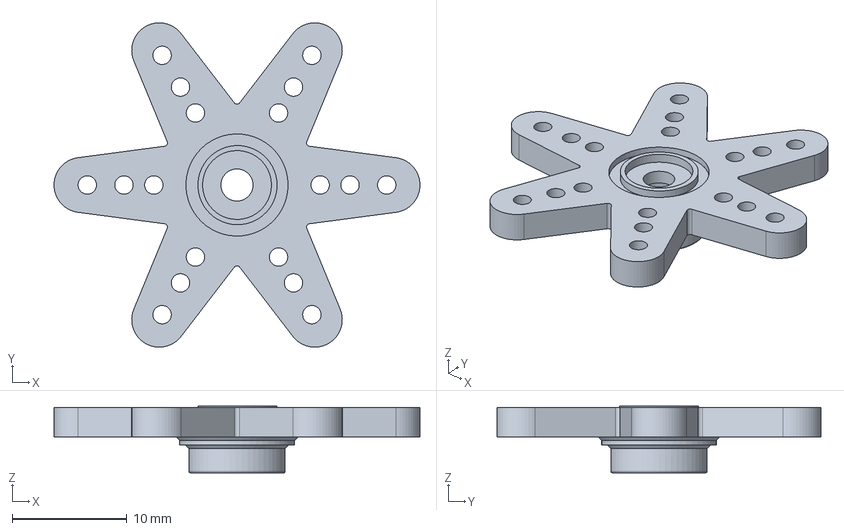
[picture p170: CAD file, 2022-01-30]
00 Modelisme/Servos/Inconnu/SpringRC-SM-S4303R/SM-S4303R-6-arms-horn.stp
31.9 x 28.3 x 5.80 mm
