ZINKTiti/30-bibliotheque-Modelisme/00 Modelisme/Servos/KST/KST X10 Mini.stp

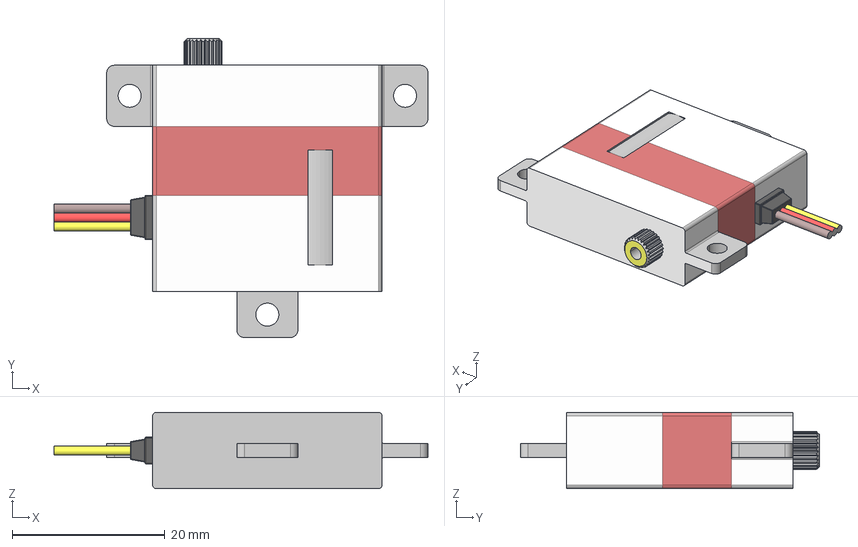
[picture p171: CAD file, 2022-01-30]
00 Modelisme/Servos/KST/KST X10 Mini.stp
48.9 x 39.1 x 10.0 mm
