ZINKTiti/30-bibliotheque-Modelisme/00 Modelisme/Servos/Savox/SA1230SG.STEP

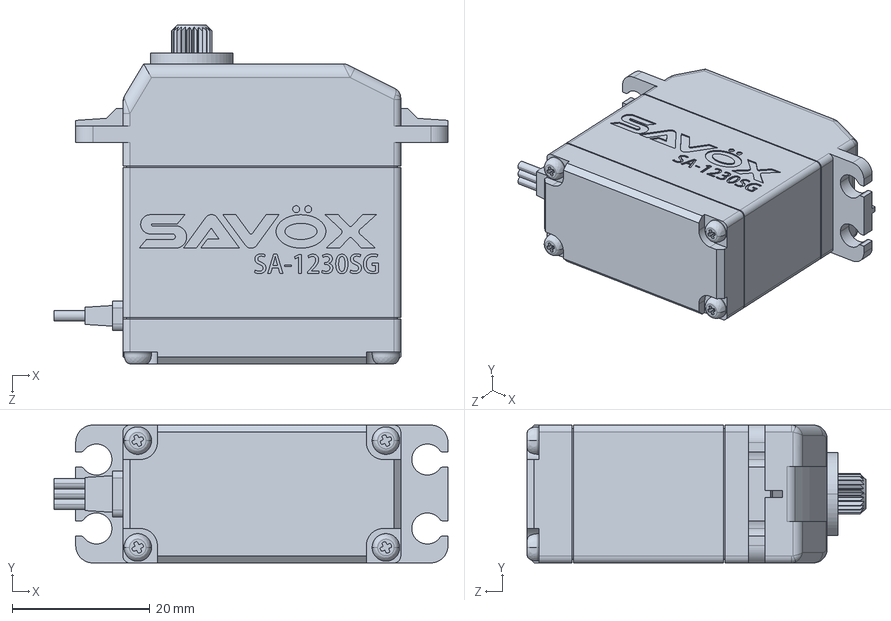
[picture p172: CAD file, 2022-01-30]
00 Modelisme/Servos/Savox/SA1230SG.STEP
57.1 x 20.0 x 49.1 mm
