ZINKTiti/30-bibliotheque-Modelisme/00 Modelisme/Servos/SERVO PARAMETRIQUE--Cut.stl

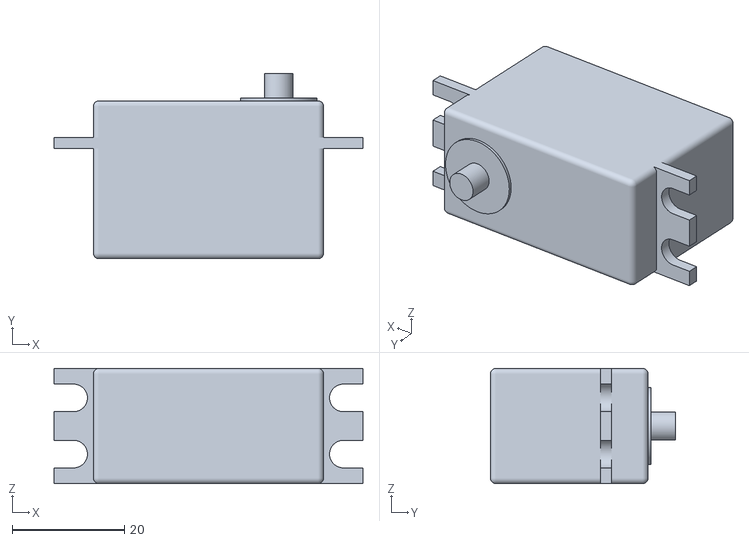
[picture p173: CAD file, 2022-03-02]
00 Modelisme/Servos/SERVO PARAMETRIQUE--Cut.stl
55.0 x 33.0 x 20.5
