ZINKTiti/30-bibliotheque-Modelisme/00 Modelisme/Servos/Turnigy/TGY-210DMH.stp

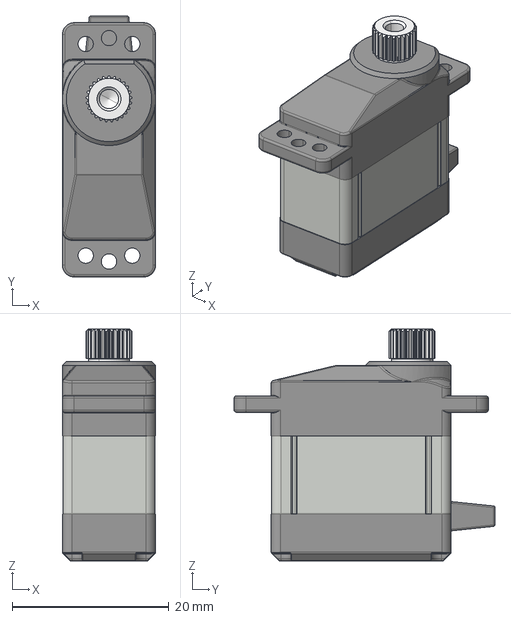
[picture p174: CAD file, 2022-01-30]
00 Modelisme/Servos/Turnigy/TGY-210DMH.stp
11.9 x 33.4 x 29.6 mm
