ZINKTiti/30-bibliotheque-Modelisme/01 Electronique/Arduino/COMMON SHIELDS/smart-lcd-ramps.fcstd

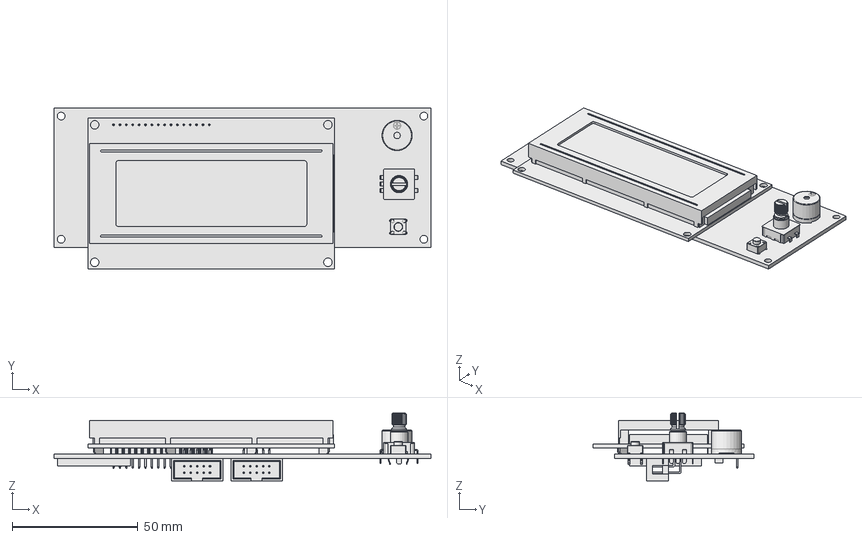
[picture p175: CAD file, 2022-01-30]
01 Electronique/Arduino/COMMON SHIELDS/smart-lcd-ramps.fcstd
150.0 x 64.1 x 26.9 mm
