ZINKTiti/30-bibliotheque-Modelisme/01 Electronique/fans/blower-50x50mm.step

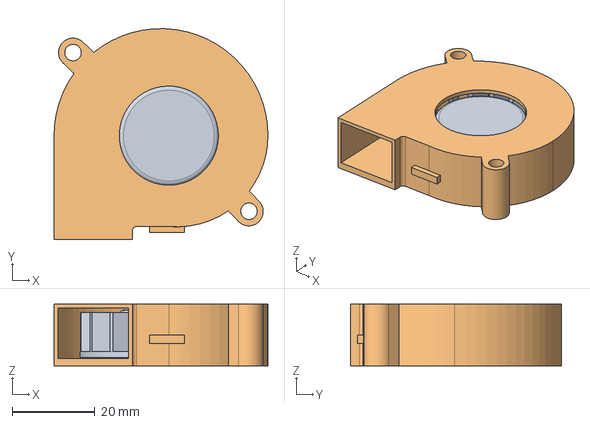
[picture p177: CAD file, 2022-01-30]
01 Electronique/fans/blower-50x50mm.step
51.8 x 51.0 x 15.0 mm
