ZINKTiti/30-bibliotheque-Modelisme/01 Electronique/Fin de course/Switch.STEP

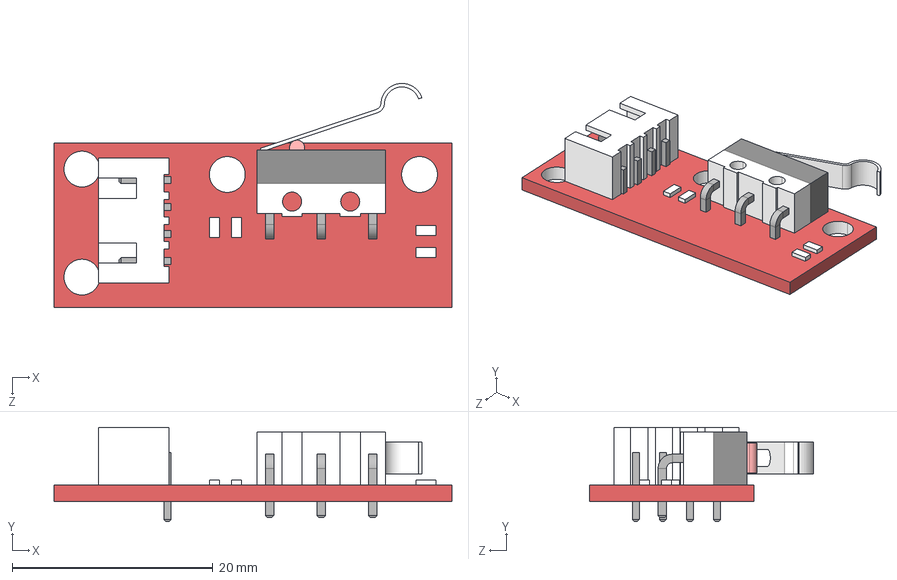
[picture p178: CAD file, 2022-01-30]
01 Electronique/Fin de course/Switch.STEP
39.7 x 9.40 x 22.4 mm
