ZINKTiti/30-bibliotheque-Modelisme/01 Electronique/LCD/2-2-tft-lcd-screen/2.2 TFT ILI9341 - Reverse.stp

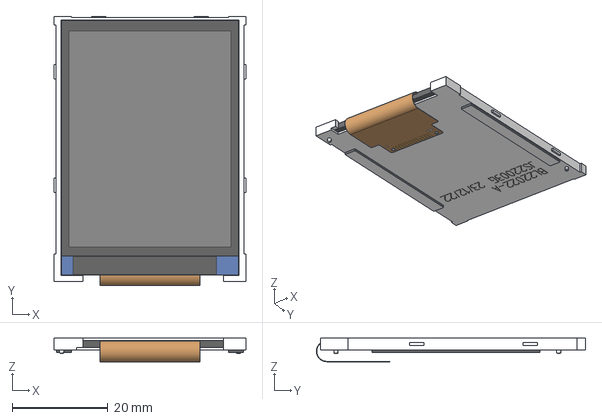
[picture p179: CAD file, 2025-01-18]
01 Electronique/LCD/2-2-tft-lcd-screen/2.2 TFT ILI9341 - Reverse.stp
40.0 x 56.1 x 4.93 mm
