ZINKTiti/30-bibliotheque-Modelisme/02 Mecanique/Insert Ruthex/RX-M2.5x5.7.step

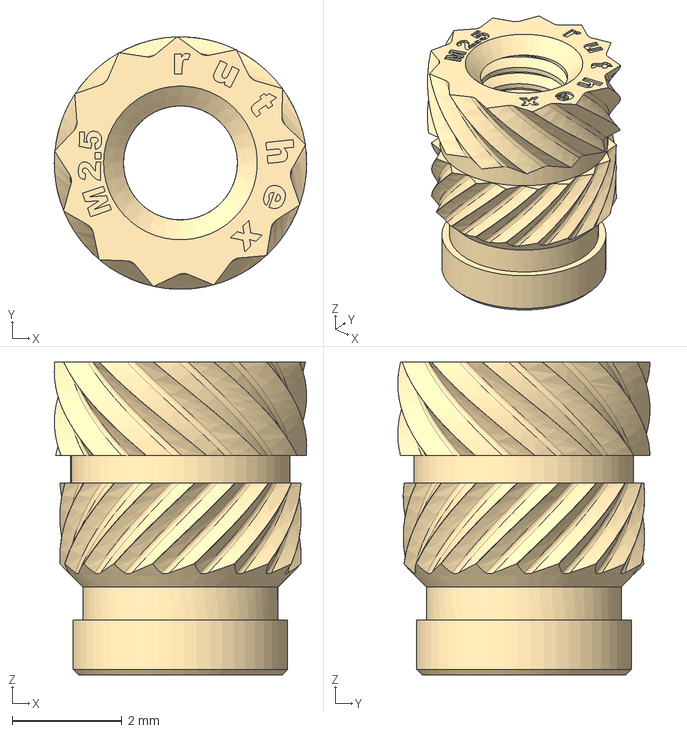
[picture p181: CAD file, 2022-02-15]
02 Mecanique/Insert Ruthex/RX-M2.5x5.7.step
4.60 x 4.60 x 5.70 mm
