ZINKTiti/30-bibliotheque-Modelisme/02 Mecanique/Profiles EN/BOSCH/Profile 20-4040.FCStd

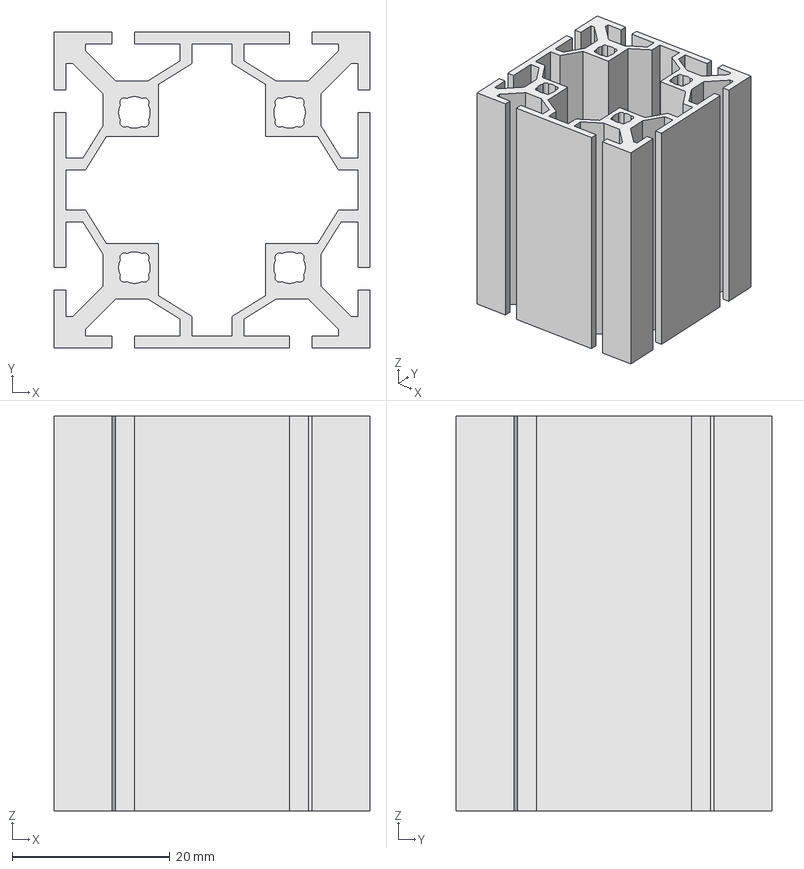
[picture p182: CAD file, 2022-01-30]
02 Mecanique/Profiles EN/BOSCH/Profile 20-4040.FCStd
40.0 x 40.0 x 50.0 mm
