ZINKTiti/30-bibliotheque-Modelisme/02 Mecanique/Profiles EN/EN10056 Equal Angle Bars/Angle Bar L65x65x6 EN10056 S235JR.step

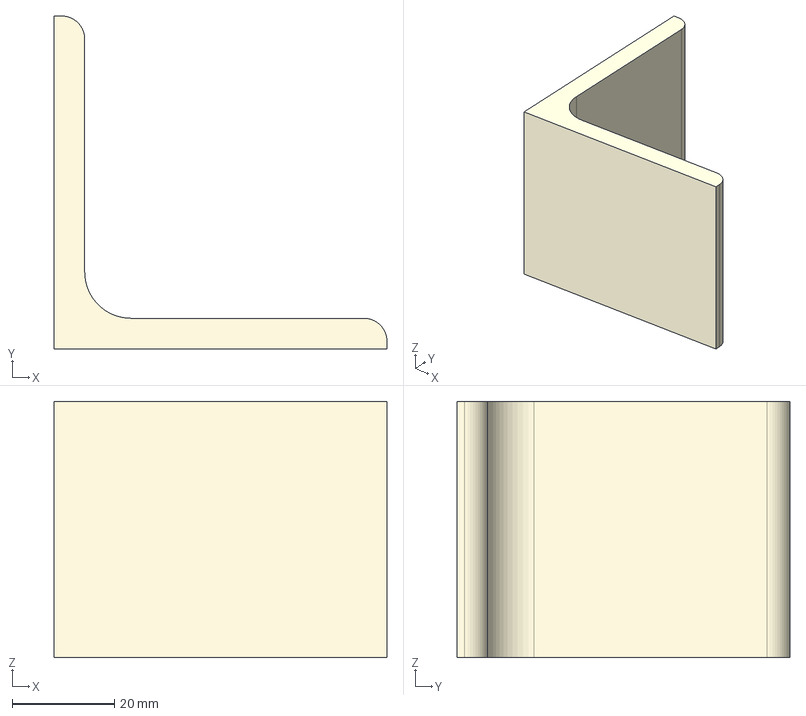
[picture p183: CAD file, 2022-01-30]
02 Mecanique/Profiles EN/EN10056 Equal Angle Bars/Angle Bar L65x65x6 EN10056 S235JR.step
65.0 x 65.0 x 50.0 mm
