ZINKTiti/30-bibliotheque-Modelisme/02 Mecanique/Profiles EN/EN10056 Unequal Angle Bars/Angle Bar 50x40x4 EN10056 S235JR.step

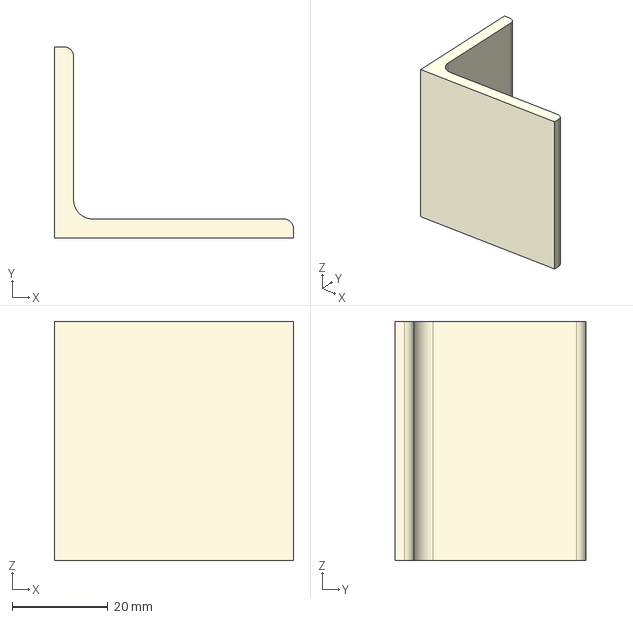
[picture p184: CAD file, 2022-01-30]
02 Mecanique/Profiles EN/EN10056 Unequal Angle Bars/Angle Bar 50x40x4 EN10056 S235JR.step
50.0 x 40.0 x 50.0 mm
