ZINKTiti/30-bibliotheque-Modelisme/02 Mecanique/Profiles EN/EN10059 Square steel bars/Square Bar 50 EN10059 S235JR.step

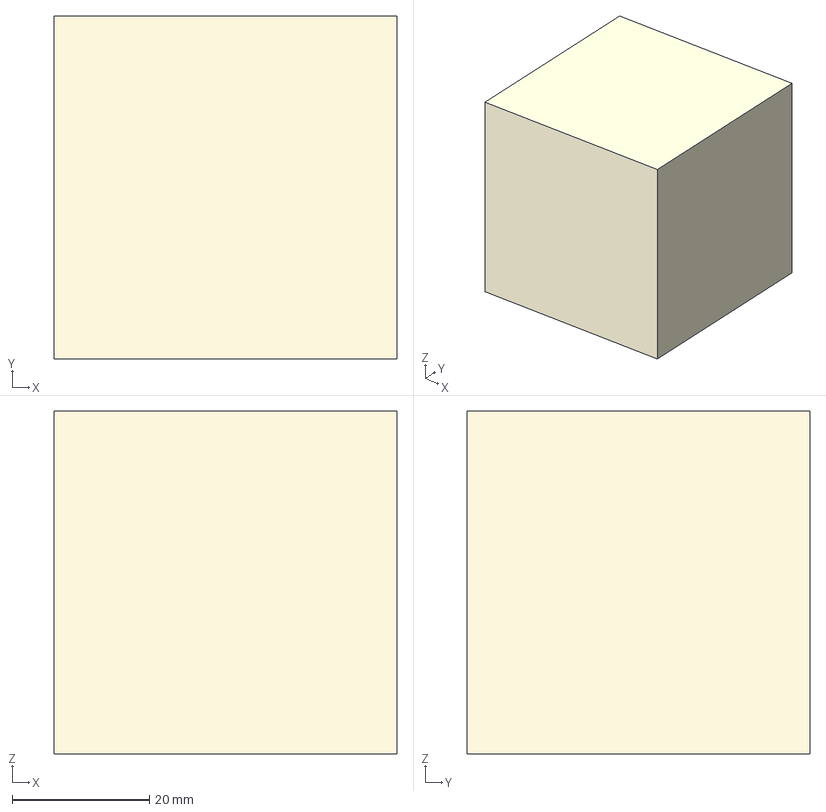
[picture p185: CAD file, 2022-01-30]
02 Mecanique/Profiles EN/EN10059 Square steel bars/Square Bar 50 EN10059 S235JR.step
50.0 x 50.0 x 50.0 mm
