ZINKTiti/30-bibliotheque-Modelisme/02 Mecanique/Profiles EN/EN10060 Round steel bars/Round Bar 290 EN10060 S235JR.step

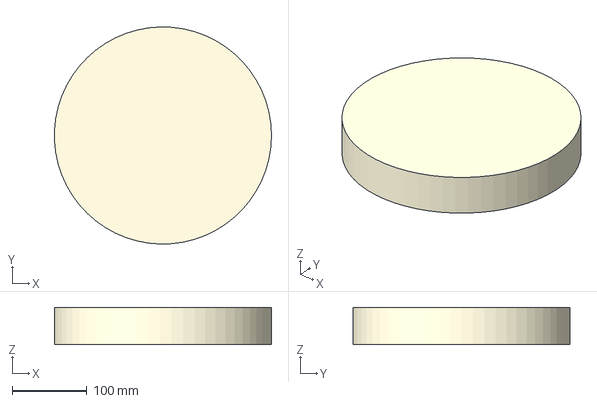
[picture p186: CAD file, 2022-01-30]
02 Mecanique/Profiles EN/EN10060 Round steel bars/Round Bar 290 EN10060 S235JR.step
289.8 x 289.9 x 50.0 mm
