ZINKTiti/30-bibliotheque-Modelisme/02 Mecanique/Profiles EN/EN10219 Rectangular Hollow Sections/Rectangular hollow section 100x50x4 EN10219 S235JRH.step

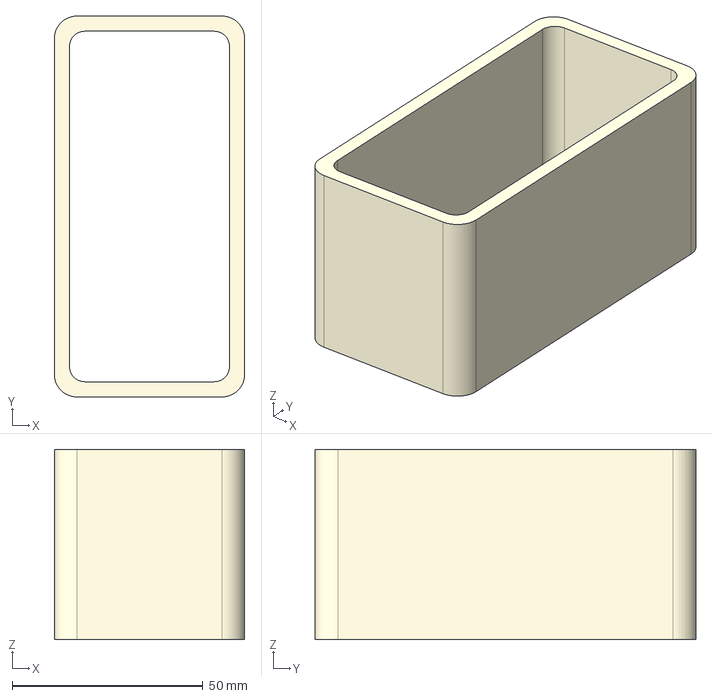
[picture p187: CAD file, 2022-01-30]
02 Mecanique/Profiles EN/EN10219 Rectangular Hollow Sections/Rectangular hollow section 100x50x4 EN10219 S235JRH.step
50.0 x 100.0 x 50.0 mm
