ZINKTiti/30-bibliotheque-Modelisme/02 Mecanique/Profiles EN/EN10219 Square Hollow Sections/Square hollow section 30x30x2.5 EN10219 S235JRH.step

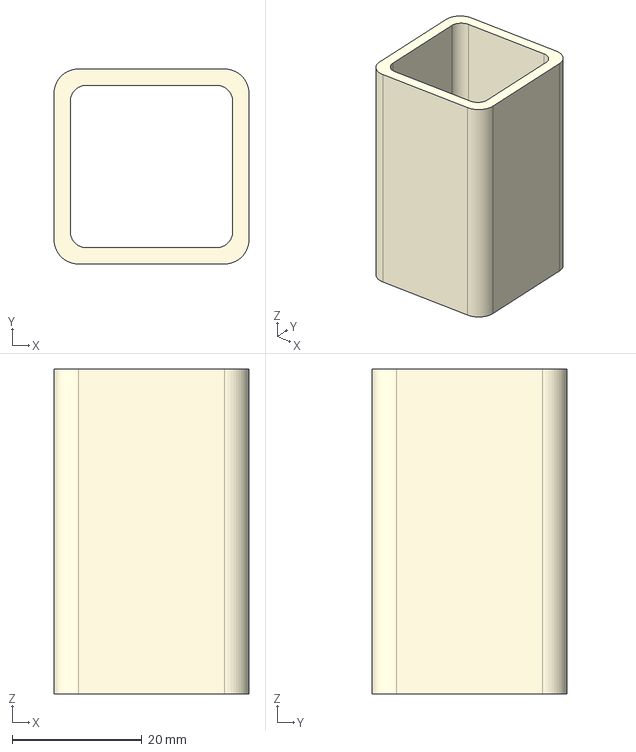
[picture p188: CAD file, 2022-01-30]
02 Mecanique/Profiles EN/EN10219 Square Hollow Sections/Square hollow section 30x30x2.5 EN10219 S235JRH.step
30.0 x 30.0 x 50.0 mm
