ZINKTiti/30-bibliotheque-Modelisme/02 Mecanique/Profiles EN/Motedis/Profile-40x40L-I-Type_Slot8.step

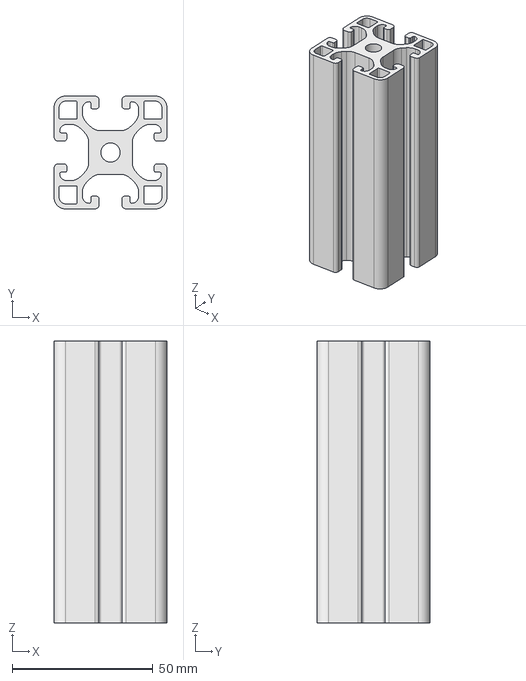
[picture p189: CAD file, 2022-01-30]
02 Mecanique/Profiles EN/Motedis/Profile-40x40L-I-Type_Slot8.step
40.0 x 40.0 x 100.0 mm
