ZINKTiti/30-bibliotheque-Modelisme/02 Mecanique/Profiles EN/Sigma profiles/Ayak.step

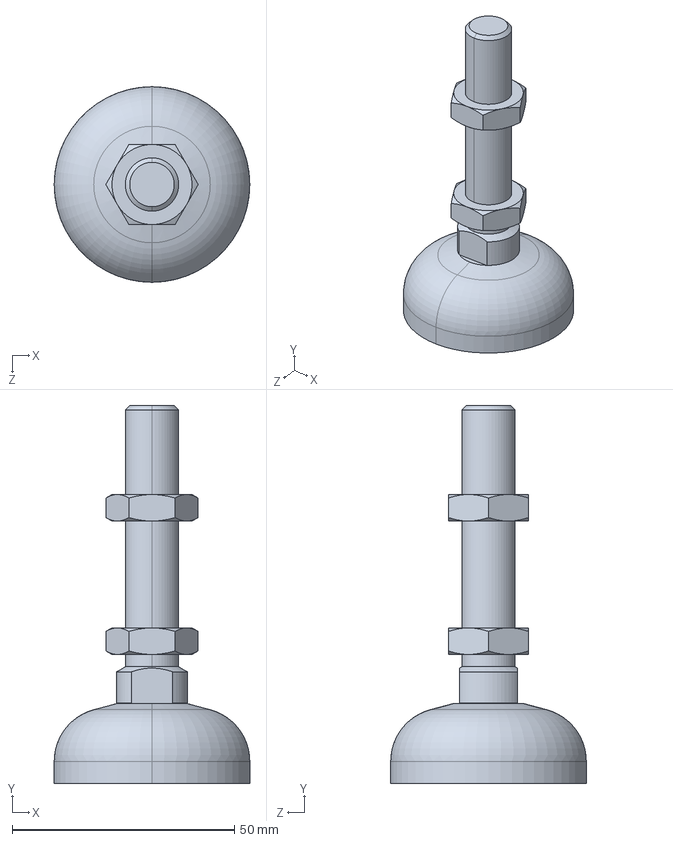
[picture p190: CAD file, 2022-01-30]
02 Mecanique/Profiles EN/Sigma profiles/Ayak.step
44.0 x 85.0 x 44.0 mm
