ZINKTiti/30-bibliotheque-Modelisme/02 Mecanique/Roulement/623ZZ_Ball_Bearing.step

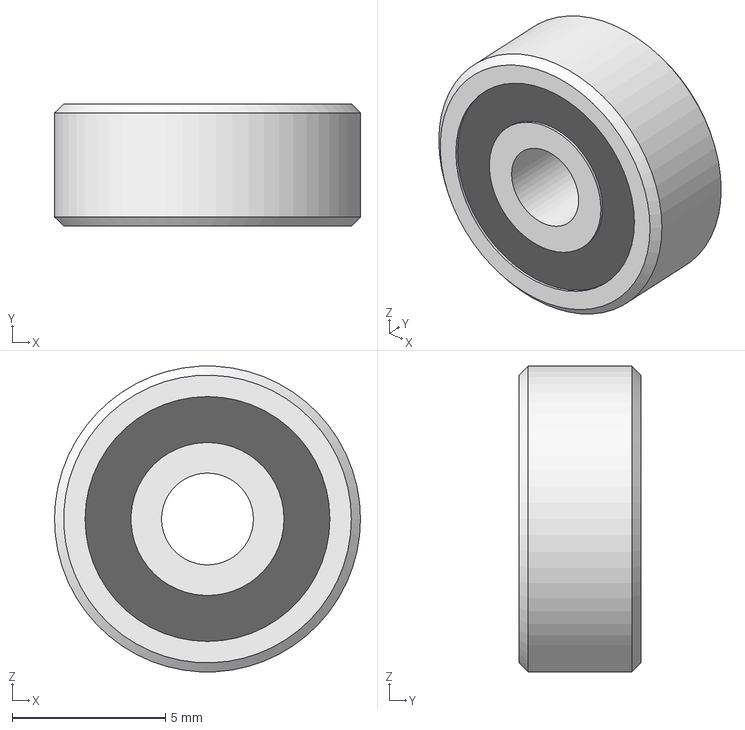
[picture p191: CAD file, 2022-01-30]
02 Mecanique/Roulement/623ZZ_Ball_Bearing.step
10.0 x 4.00 x 9.99 mm
