ZINKTiti/30-bibliotheque-Modelisme/00 Modelisme/Accessoires/Boitier connecteur/connecteur_JR_affleurant.stl

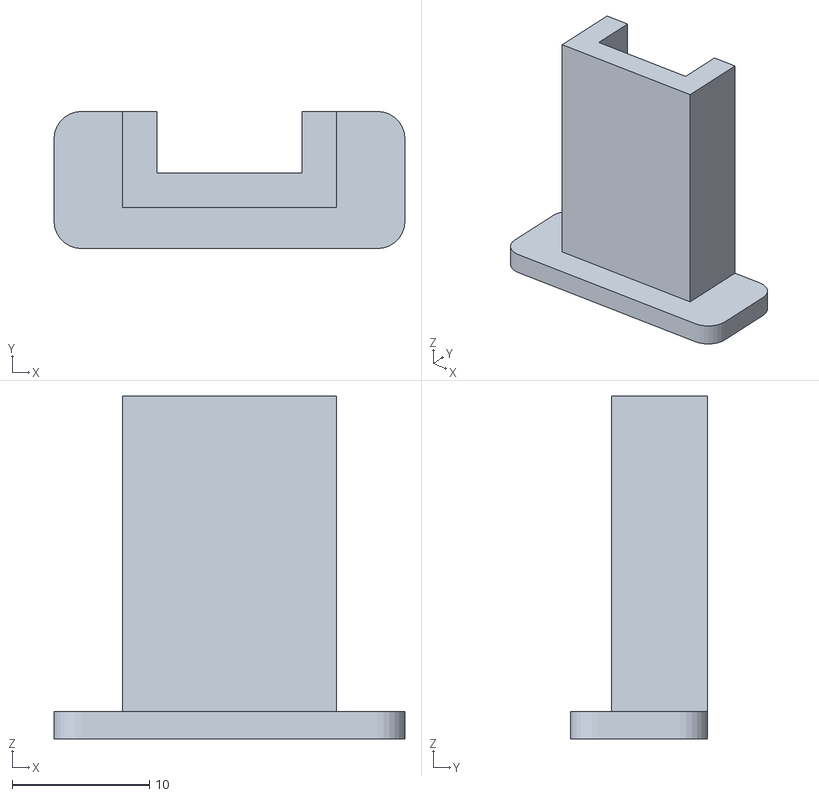
[picture p192: CAD file, 2024-11-10]
00 Modelisme/Accessoires/Boitier connecteur/connecteur_JR_affleurant.stl
25.6 x 10.0 x 25.0
