ZINKTiti/30-bibliotheque-Modelisme/00 Modelisme/Accessoires/Connecteur/XT/XT60 Male Connector.STEP

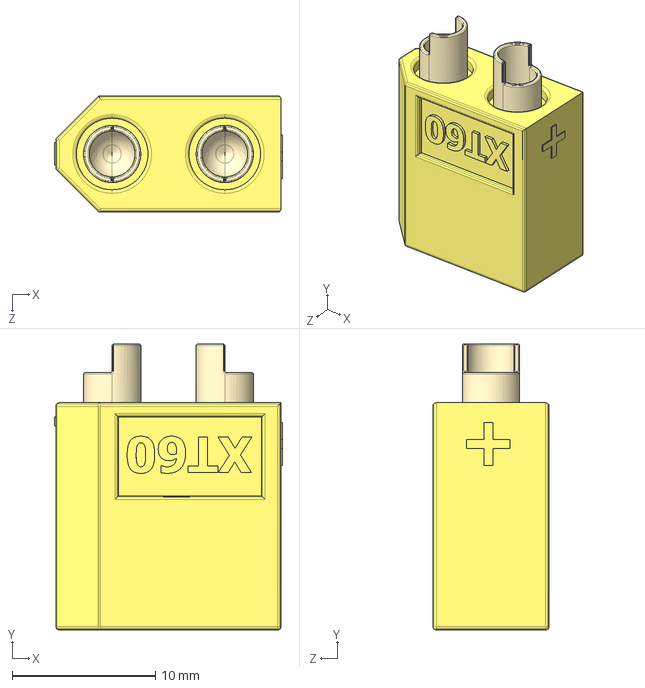
[picture p193: CAD file, 2024-11-10]
00 Modelisme/Accessoires/Connecteur/XT/XT60 Male Connector.STEP
15.9 x 20.0 x 8.13 mm
