ZINKTiti/30-bibliotheque-Modelisme/00 Modelisme/Servos/Futaba/Servo_Futaba_S3107.step

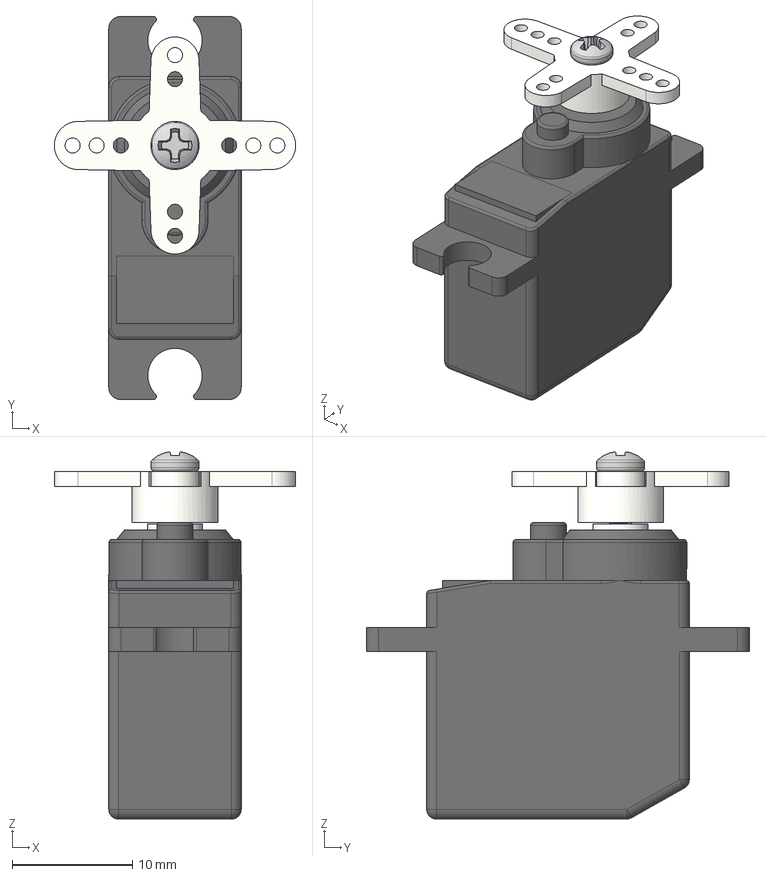
[picture p194: CAD file, 2022-01-30]
00 Modelisme/Servos/Futaba/Servo_Futaba_S3107.step
20.0 x 31.8 x 30.5 mm
ScrewM2x8mm
ServoHorm1-FutabaS3107 v4
