ZINKTiti/30-bibliotheque-Modelisme/00 Modelisme/Servos/Hitec/Hitec D845WP.STEP

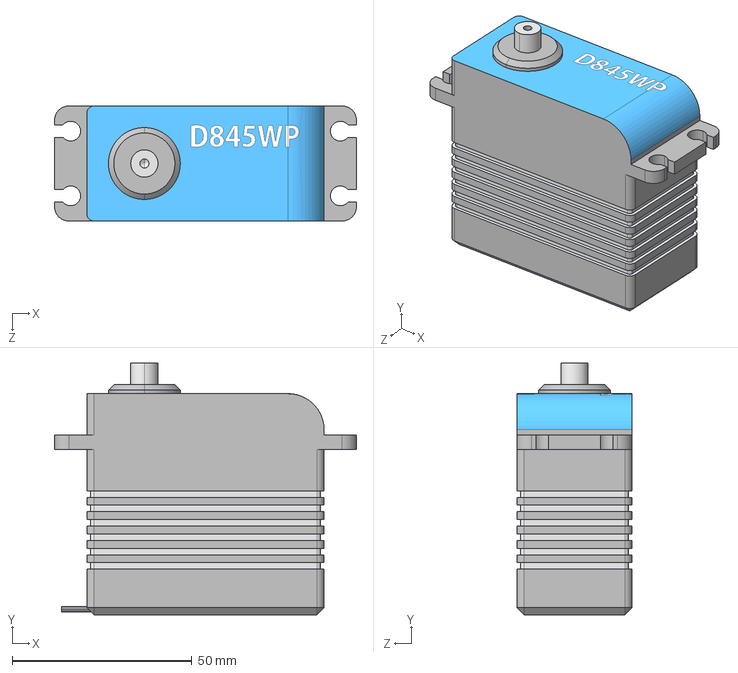
[picture p195: CAD file, 2022-01-30]
00 Modelisme/Servos/Hitec/Hitec D845WP.STEP
84.0 x 70.0 x 32.0 mm
