ZINKTiti/30-bibliotheque-Modelisme/00 Modelisme/Servos/Inconnu/Emax-ES08A/Emax-es08A.step

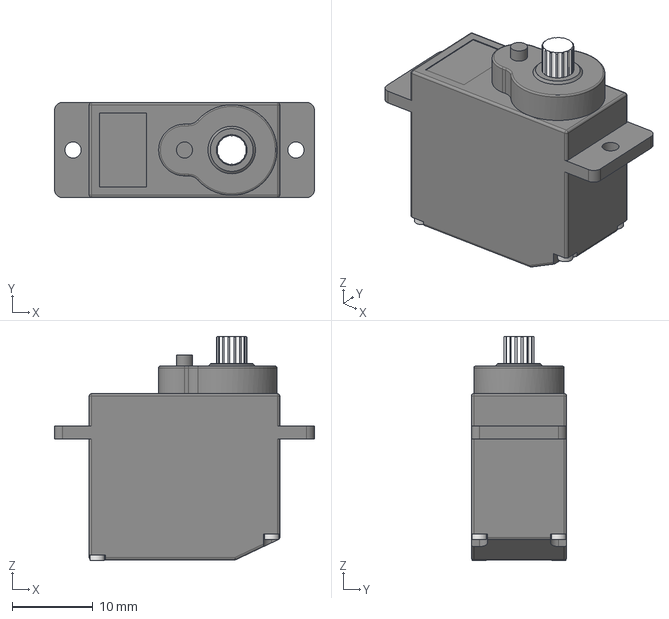
[picture p196: CAD file, 2022-01-30]
00 Modelisme/Servos/Inconnu/Emax-ES08A/Emax-es08A.step
32.2 x 11.8 x 27.8 mm
