ZINKTiti/30-bibliotheque-Modelisme/00 Modelisme/Servos/Inconnu/SG-90/SG90-2-arms-horn.step

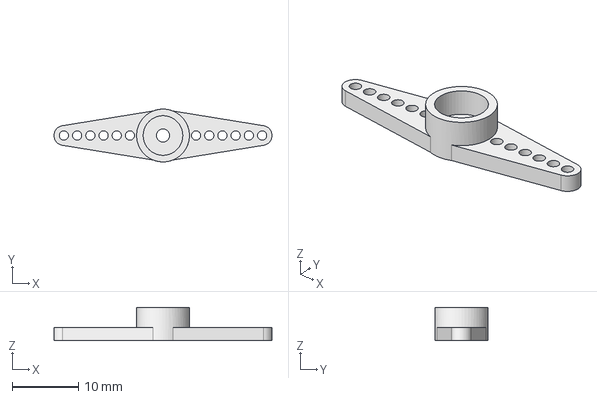
[picture p197: CAD file, 2022-01-30]
00 Modelisme/Servos/Inconnu/SG-90/SG90-2-arms-horn.step
33.0 x 8.00 x 5.00 mm
