ZINKTiti/30-bibliotheque-Modelisme/00 Modelisme/Servos/Inconnu/SpringRC-SM-S4303R/SM-S4303R.step

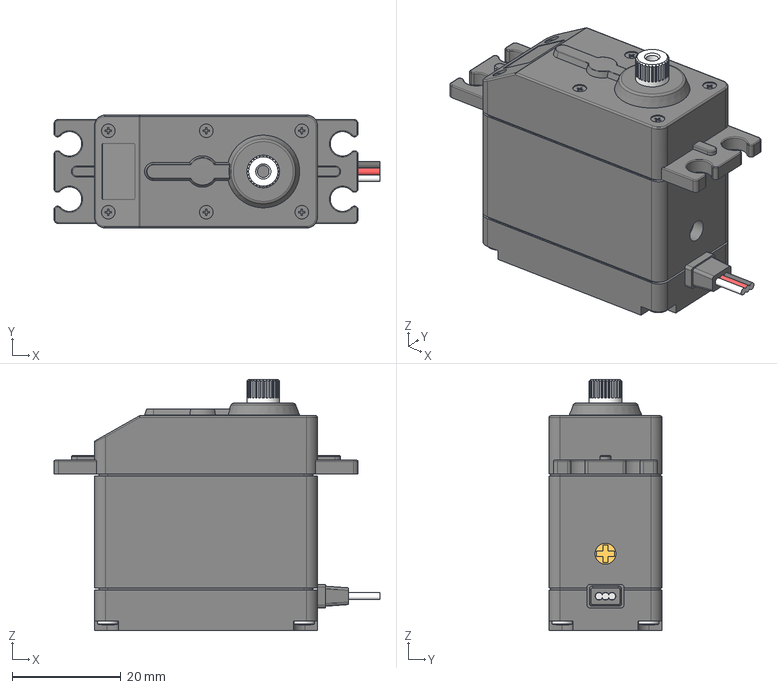
[picture p198: CAD file, 2022-01-30]
00 Modelisme/Servos/Inconnu/SpringRC-SM-S4303R/SM-S4303R.step
60.0 x 20.8 x 46.3 mm
