ZINKTiti/30-bibliotheque-Modelisme/00 Modelisme/Servos/KST/KST X06.stp

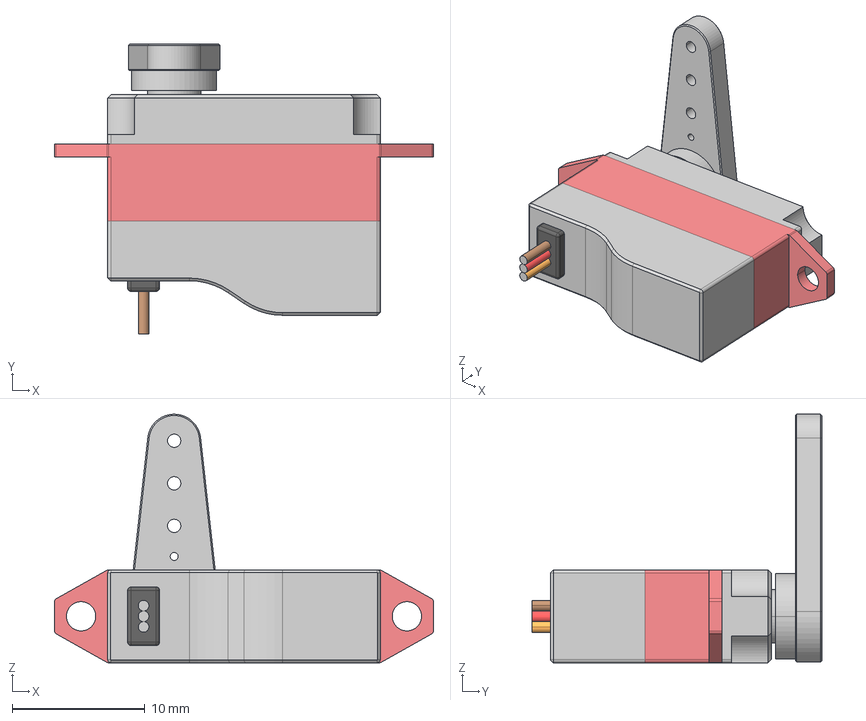
[picture p199: CAD file, 2022-01-30]
00 Modelisme/Servos/KST/KST X06.stp
28.5 x 21.8 x 18.7 mm
KST06_horn
KST06 Body
