ZINKTiti/30-bibliotheque-Modelisme/00 Modelisme/Servos/Turnigy/TGY-180D.STEP

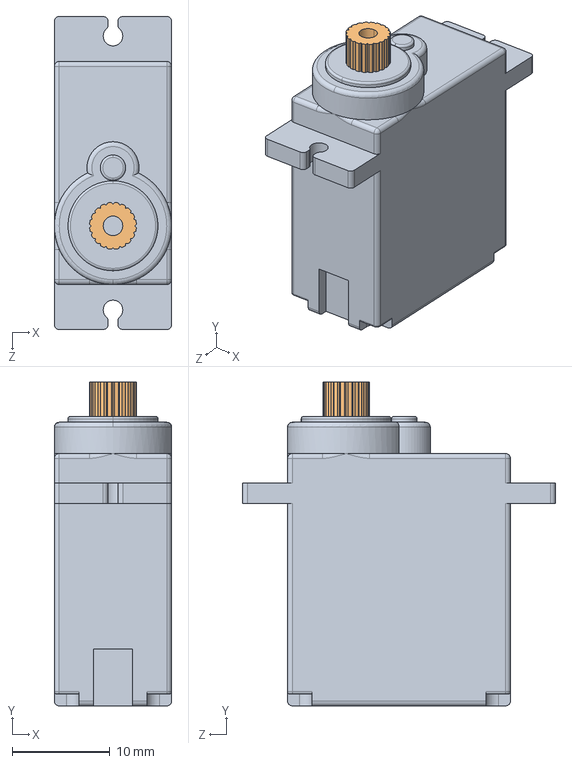
[picture p200: CAD file, 2022-01-30]
00 Modelisme/Servos/Turnigy/TGY-180D.STEP
12.0 x 33.1 x 32.0 mm
Part1^Turnigy TGY-180D Servo
Part2^Turnigy TGY-180D Servo
