ZINKTiti/30-bibliotheque-Modelisme/01 Electronique/Arduino/COMMON SHIELDS/bus_pirate.fcstd

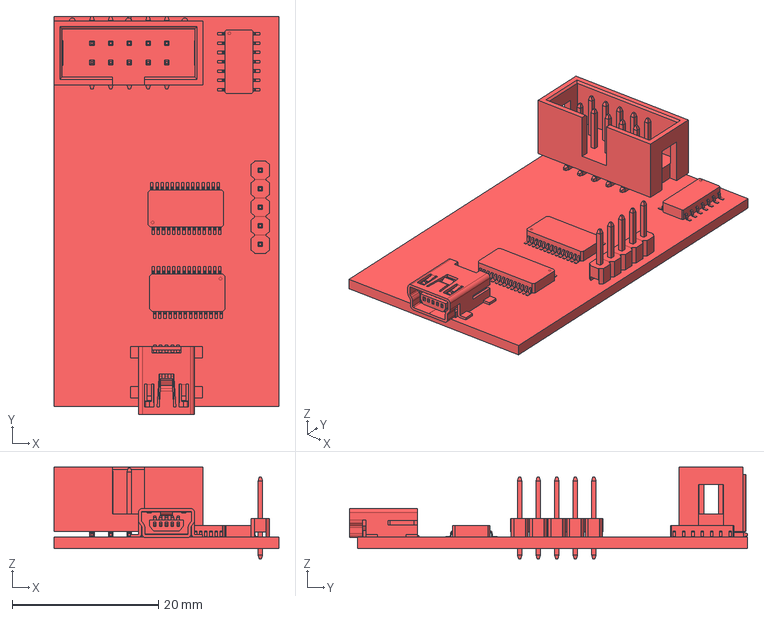
[picture p201: CAD file, 2022-01-30]
01 Electronique/Arduino/COMMON SHIELDS/bus_pirate.fcstd
30.8 x 54.5 x 12.6 mm
