ZINKTiti/30-bibliotheque-Modelisme/01 Electronique/fans/fan-40x40mm.step

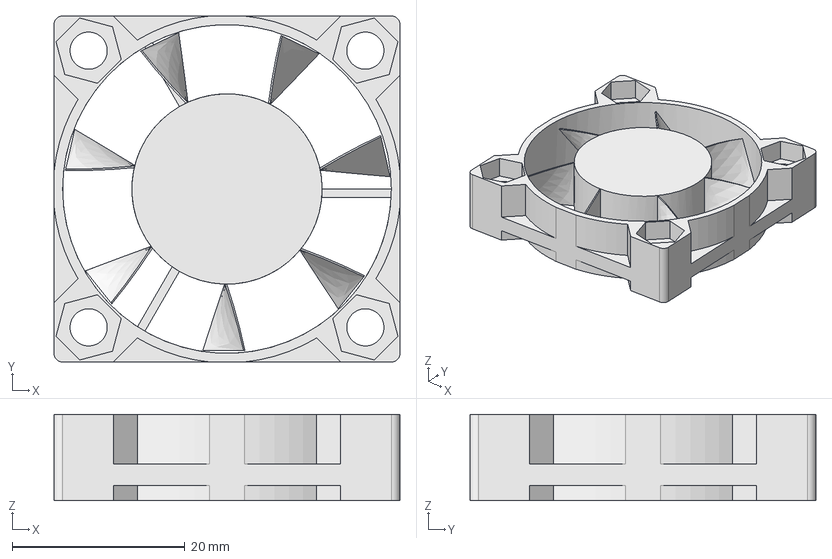
[picture p203: CAD file, 2022-01-30]
01 Electronique/fans/fan-40x40mm.step
40.0 x 40.0 x 10.0 mm
