ZINKTiti/30-bibliotheque-Modelisme/01 Electronique/Fin de course/microswitch-ESS05-EGE.step

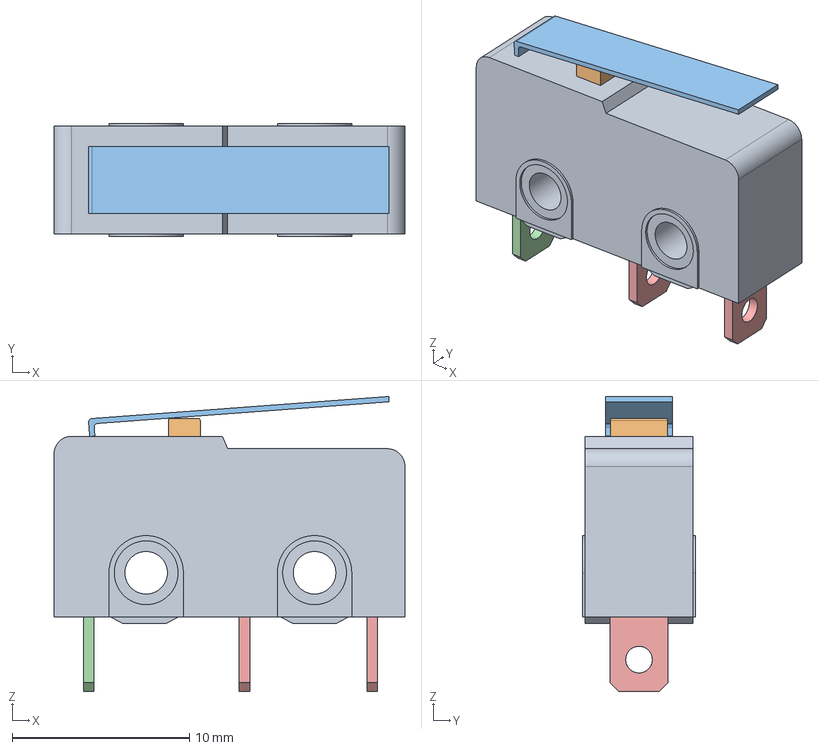
[picture p204: CAD file, 2022-01-30]
01 Electronique/Fin de course/microswitch-ESS05-EGE.step
19.8 x 6.40 x 16.6 mm
