ZINKTiti/30-bibliotheque-Modelisme/(list of files, cad)

Other CAD files:
00 Modelisme/Servos/Accesories/servo_rod_100mm.step
02 Mecanique/Profiles EN/EN10056 Unequal Angle Bars/Angle Bar 70x50x5 EN10056 S235JR.step
00 Modelisme/Accessoires/Boitier connecteur/Dobbel_MPX_v1.stl
00 Modelisme/Accessoires/Boitier connecteur/connecteur_JR_double_ligne.stl
00 Modelisme/Accessoires/Boitier connecteur/connecteur_JR_simple.stl
00 Modelisme/Accessoires/Connecteur/MPX/MULTIPLEX CONNECTOR.IGS
00 Modelisme/Accessoires/Connecteur/XT/XT60 Female Connector.STEP
00 Modelisme/Accessoires/Connecteur/XT/XT60E-M.STEP
00 Modelisme/Servos/Accesories/servo_rod_100mm.fcstd
00 Modelisme/Servos/Accesories/servo_rod_100mm.stl
00 Modelisme/Servos/Futaba/Futaba3003/Futaba3003-4-arms-horn.fcstd
00 Modelisme/Servos/Futaba/Futaba3003/Futaba3003-4-arms-horn.step
00 Modelisme/Servos/Futaba/Futaba3003/Futaba3003-4-arms-horn.stl
00 Modelisme/Servos/Futaba/Futaba3003/Futaba3003-6-arms-horn.fcstd
00 Modelisme/Servos/Futaba/Futaba3003/Futaba3003-6-arms-horn.step
00 Modelisme/Servos/Futaba/Futaba3003/Futaba3003-6-arms-horn.stl
00 Modelisme/Servos/Futaba/Futaba3003/Futaba3003-big-rounded-horn.fcstd
00 Modelisme/Servos/Futaba/Futaba3003/Futaba3003-big-rounded-horn.stl
00 Modelisme/Servos/Futaba/Futaba3003/Futaba3003-bottom-bolt.fcstd
00 Modelisme/Servos/Futaba/Futaba3003/Futaba3003-bottom-screw.stl
00 Modelisme/Servos/Futaba/Futaba3003/Futaba3003-bottom-screw.stp
00 Modelisme/Servos/Futaba/Futaba3003/Futaba3003-horn-bolt-short-version.fcstd
00 Modelisme/Servos/Futaba/Futaba3003/Futaba3003-horn-bolt-short-version.stl
00 Modelisme/Servos/Futaba/Futaba3003/Futaba3003-horn-bolt-short-version.stp
00 Modelisme/Servos/Futaba/Futaba3003/Futaba3003-horn-bolt.fcstd
00 Modelisme/Servos/Futaba/Futaba3003/Futaba3003-horn-bolt.stl
00 Modelisme/Servos/Futaba/Futaba3003/Futaba3003-horn-bolt.stp
00 Modelisme/Servos/Futaba/Futaba3003/Futaba3003-rounded-horn.fcstd
00 Modelisme/Servos/Futaba/Futaba3003/Futaba3003-rounded-horn.stl
00 Modelisme/Servos/Futaba/Futaba3003/Futaba3003-shaft-bolt.fcstd
00 Modelisme/Servos/Futaba/Futaba3003/Futaba3003-shaft-bolt.stl
00 Modelisme/Servos/Futaba/Futaba3003/Futaba3003-shaft-bolt.stp
00 Modelisme/Servos/Futaba/Futaba3003/Futaba3003.fcstd
00 Modelisme/Servos/Futaba/Futaba3003/Futaba3003.stl
00 Modelisme/Servos/Futaba/Futaba3003/Futaba3003.stp
00 Modelisme/Servos/Futaba/Servo_Futaba_S3154.step
00 Modelisme/Servos/Hitec/HS-125MG.stp
00 Modelisme/Servos/Hitec/HS-5125MG.STEP
00 Modelisme/Servos/Hitec/HS-5485HB Servo.STEP
00 Modelisme/Servos/Hitec/HS-77BB.STEP
00 Modelisme/Servos/Hitec/HS-D930 .step
00 Modelisme/Servos/Hitec/HSB-9380TH.STEP
00 Modelisme/Servos/Hitec/HSB-9381TH.STEP
00 Modelisme/Servos/Hitec/HSR-2645CR.STEP
00 Modelisme/Servos/Inconnu/Emax-ES08A/Emax-es08A.fcstd
00 Modelisme/Servos/Inconnu/Emax-ES08A/Emax-es08A.stl
00 Modelisme/Servos/Inconnu/Emax-ES08A/servo-rounded-horn.fcstd
00 Modelisme/Servos/Inconnu/Emax-ES08A/servo-rounded-horn.stl
00 Modelisme/Servos/Inconnu/Emax-ES08A/servo-screw-1.7x6.2mm.fcstd
00 Modelisme/Servos/Inconnu/Emax-ES08A/servo-screw-1.7x6.2mm.step
00 Modelisme/Servos/Inconnu/Emax-ES08A/servo-screw-1.7x6.2mm.stl
00 Modelisme/Servos/Inconnu/Emax-ES08A/servo-screw-2x7_5mm.fcstd
00 Modelisme/Servos/Inconnu/Emax-ES08A/servo-screw-2x7_5mm.step
00 Modelisme/Servos/Inconnu/Emax-ES08A/servo-screw-2x7_5mm.stl
00 Modelisme/Servos/Inconnu/SG-90/SG90-1-arm-horn.fcstd
00 Modelisme/Servos/Inconnu/SG-90/SG90-1-arm-horn.stl
00 Modelisme/Servos/Inconnu/SG-90/SG90-2-arms-horn.fcstd
00 Modelisme/Servos/Inconnu/SG-90/SG90-2-arms-horn.stl
00 Modelisme/Servos/Inconnu/SG-90/SG90-4-arms-horn.fcstd
00 Modelisme/Servos/Inconnu/SG-90/SG90-4-arms-horn.stl
00 Modelisme/Servos/Inconnu/SG-90/Servo sg90.fcstd
00 Modelisme/Servos/Inconnu/SG-90/Servo-SG90.stl
00 Modelisme/Servos/Inconnu/SpringRC-SM-S4303R/SM-S4303R-2-arms-big-horn.fcstd
00 Modelisme/Servos/Inconnu/SpringRC-SM-S4303R/SM-S4303R-2-arms-big-horn.stl
00 Modelisme/Servos/Inconnu/SpringRC-SM-S4303R/SM-S4303R-2-arms-big-horn.stp
00 Modelisme/Servos/Inconnu/SpringRC-SM-S4303R/SM-S4303R-2-arms-small-horn.fcstd
00 Modelisme/Servos/Inconnu/SpringRC-SM-S4303R/SM-S4303R-2-arms-small-horn.stl
00 Modelisme/Servos/Inconnu/SpringRC-SM-S4303R/SM-S4303R-2-arms-small-horn.stp
00 Modelisme/Servos/Inconnu/SpringRC-SM-S4303R/SM-S4303R-4-arm-horn.fcstd
00 Modelisme/Servos/Inconnu/SpringRC-SM-S4303R/SM-S4303R-4-arms-horn.stl
00 Modelisme/Servos/Inconnu/SpringRC-SM-S4303R/SM-S4303R-6-arm-horn.fcstd
00 Modelisme/Servos/Inconnu/SpringRC-SM-S4303R/SM-S4303R-6-arms-horn.stl
00 Modelisme/Servos/Inconnu/SpringRC-SM-S4303R/SM-S4303R-big-rounded-horn.fcstd
00 Modelisme/Servos/Inconnu/SpringRC-SM-S4303R/SM-S4303R-big-rounded-horn.step
00 Modelisme/Servos/Inconnu/SpringRC-SM-S4303R/SM-S4303R-big-rounded-horn.stl
00 Modelisme/Servos/Inconnu/SpringRC-SM-S4303R/SM-S4303R-bottom-screws.fcstd
00 Modelisme/Servos/Inconnu/SpringRC-SM-S4303R/SM-S4303R-bottom-screws.step
00 Modelisme/Servos/Inconnu/SpringRC-SM-S4303R/SM-S4303R-bottom-screws.stl
00 Modelisme/Servos/Inconnu/SpringRC-SM-S4303R/SM-S4303R-horn-screw.fcstd
00 Modelisme/Servos/Inconnu/SpringRC-SM-S4303R/SM-S4303R-horn-screw.step
00 Modelisme/Servos/Inconnu/SpringRC-SM-S4303R/SM-S4303R-horn-screw.stl
00 Modelisme/Servos/Inconnu/SpringRC-SM-S4303R/SM-S4303R-shaft-screw.fcstd
00 Modelisme/Servos/Inconnu/SpringRC-SM-S4303R/SM-S4303R-shaft-screw.stl
00 Modelisme/Servos/Inconnu/SpringRC-SM-S4303R/SM-S4303R-shaft-screw.stp
00 Modelisme/Servos/Inconnu/SpringRC-SM-S4303R/SM-S4303R-small-rounded-horn.fcstd
00 Modelisme/Servos/Inconnu/SpringRC-SM-S4303R/SM-S4303R-small-rounded-horn.step
00 Modelisme/Servos/Inconnu/SpringRC-SM-S4303R/SM-S4303R-small-rounded-horn.stl
00 Modelisme/Servos/Inconnu/SpringRC-SM-S4303R/SM-S4303R.fcstd
00 Modelisme/Servos/Inconnu/SpringRC-SM-S4303R/SM-S4303R.stl
00 Modelisme/Servos/KST/KST X08.stp
00 Modelisme/Servos/KST/KST X10 710.stp
00 Modelisme/Servos/Turnigy/TGY-306GV2.2.STL
00 Modelisme/Servos/Turnigy/TGY-3225MG.STEP
00 Modelisme/Servos/Turnigy/TGY-390DMH.stp
00 Modelisme/Servos/Turnigy/TGY-4409MD.stp
00 Modelisme/Servos/Turnigy/TGY-9025MG.STEP
00 Modelisme/Servos/Turnigy/TGY1501.step
01 Electronique/Arduino/COMMON SHIELDS/Nordic NRF24L01_plus.fcstd
01 Electronique/Arduino/COMMON SHIELDS/Nordic NRF24L01_plus.stl
01 Electronique/Arduino/COMMON SHIELDS/bus-pirate.STL
01 Electronique/Arduino/COMMON SHIELDS/pololu-A500.fcstd
01 Electronique/Arduino/COMMON SHIELDS/pololu-A500.stl
01 Electronique/Arduino/COMMON SHIELDS/smart-lcd-ramps.stl
01 Electronique/Arduino/MEGA/arduino-mega.stl
01 Electronique/Arduino/NANO/Nano-Rev3_0.fcstd
01 Electronique/Arduino/NANO/Nano-Rev3_0.stl
01 Electronique/Arduino/NANO/SHIELDS/nano_expansion_shield.stl
01 Electronique/Arduino/UNO/freaduino-uno.stl
01 Electronique/Fin de course/Fin de course rouge/Konstruktion24.igs
01 Electronique/Fin de course/endstop-v1-2-makerbot.fcstd
01 Electronique/Fin de course/endstop-v1-2-makerbot.step
01 Electronique/Fin de course/endstop-v1-2-makerbot.stl
01 Electronique/Fin de course/endstop.fcstd
01 Electronique/Fin de course/endstop.stl
01 Electronique/Fin de course/endstopsmall.fcstd
01 Electronique/Fin de course/endstopsmall.stl
01 Electronique/Fin de course/microswitch-ESS05-EGE.fcstd
01 Electronique/Fin de course/microswitch-ESS05-EGE.stl
01 Electronique/LCD/2-2-tft-lcd-screen/2.2 TFT ILI9341 - Flat - With Glass.stp
01 Electronique/LCD/2-2-tft-lcd-screen/2.2 TFT ILI9341 - Flat.stp
01 Electronique/LCD/2-2-tft-lcd-screen/2.2 TFT ILI9341 - Flush.stp
01 Electronique/LCD/2-2-tft-lcd-screen/2.2 TFT ILI9341 - Glass.stp
01 Electronique/LCD/OLED TFT 0.96 inch 64x128 monochrome.STEP
01 Electronique/LCD/OLED_13_128_64_I2C_pins_up.stl
01 Electronique/LCD/lcd-4x20-backlight.fcstd
01 Electronique/LCD/lcd-4x20-backlight.stl
01 Electronique/Motors/01 NEMA/Nema-17_Mount_Bracket/Nema-17_MountBracket.stl
01 Electronique/Motors/01 NEMA/Nema-17_Mount_Bracket/Nema-17_Mount_Bracket.fcstd
01 Electronique/Motors/01 NEMA/Old/NEMA-17_Stepper_Motor_26mm_with_connector.fcstd
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
