ZINKTiti/30-bibliotheque-Modelisme/(commit log)

2022-01-30 Update
    Servo/Moteur/RX
    [C508.igs, Emax-es08A.fcstd, Emax-es08A.step, Emax-es08A.stl, FSH-6W.step, FUTABA_HPSCB700_FSH6W v2.step, Futaba3003-4-arms-horn.fcstd, Futaba3003-4-arms-horn.step]
2022-01-30 New servo
    Goteck Hitec Savox
    [DA2312T.stp, DA2322T.stp, HS-5125MG.STEP, MG946R.STL, SA1230SG.STEP]
2022-01-30 New Servo
    [AXI 5325-24.STEP, AXI2814-20.STEP, Futaba FP-S28.STEP, Goteck BL1511S.stp, HS-125MG.stp, HS-5485HB Servo.STEP, HS-55.step, HS-5585MH.stp]
2022-01-30 Axi serie 28XX
    [AXI_28XX.FCStd, AXI_28XX.FCStd.fcstd, AXI_28XX.FCStd.step, AXI_28XX.FCStd.stl]
2022-01-31 Moteur AXI28XX
    Model Parametrique des moteur Axi de toute la serie 28XX
    [AXI_28XX.FCStd, AXI_28XX.FCStd.fcstd, AXI_28XX.FCStd.step, AXI_28XX.FCStd.stl]
2022-02-01 NEW AXI
    [AXI_28XX.FCStd]
2022-02-01 Servo Parametric
    [AXI_28XX.FCStd, SERVO PARAMETRIQUE.FCStd]
2022-02-01 Servo Full Parametric
    [SERVO PARAMETRIQUE.FCStd]
2022-02-01 Create Vslot 2020 Parametrique.FCStd
    [Vslot 2020 Parametrique.FCStd]
2022-02-01 Vslot Update
    [Vslot 2020 Parametrique.FCStd]
2022-02-01 Vslot 2040 Parametrique
    [Vslot 2040 Parametrique.FCStd]
2022-02-02 DIN ISO 12240-4 INIT
    [Embout à rotule mâle DIN ISO 12240-4.FCStd]
2022-02-04 Add file Fcinfo
    [Vslot 2020 Parametrique.FCStd]
2022-02-15 Add Ruthex part
    [RX-M2.5x5.7.step, RX-M2x4.step, RX-M3x5.7.step, RX-M4x8.1.step, RX-M5x9.5.step, RX-M6x12.7.step, RX-M8x12.7.step, Vslot 2020 Parametrique.FCStd]
2022-03-02 Create SERVO FLAT PARAMTERIQUE.FCStd
    [SERVO FLAT PARAMTERIQUE.FCStd]
2022-11-20 New object and Servo Modif
    [LiPo 2S 300mAh.stp, Multistar 4822-390.STEP, Propdrive 2826 V2.STEP, SERVO FLAT PARAMTERIQUE.FCStd, SERVO PARAMETRIQUE.FCStd, Turnigy D3530_14.STEP]
